cansat-tsniimash/NeonBlade-2023/docs/Зимняя сессия/Cansat NEON BLADE-2023 Презентация.pdf

# Презентация проекта команды NEON BLADE

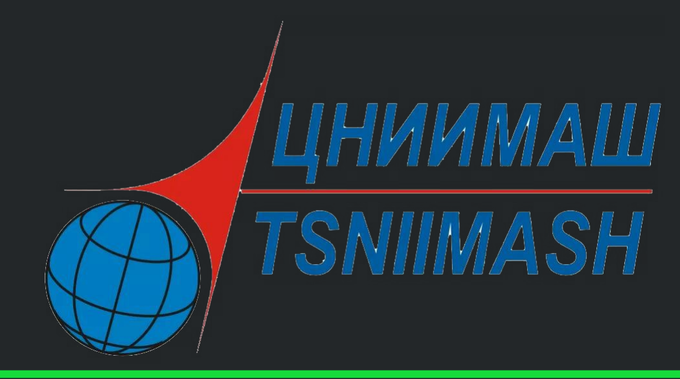
[picture p1: figure]

# Команда

# Воронов Даниил

## 2 года участия в ВИШ

# Черноглазов Даниил

## 1 год участия в ВИШ

# Ожигов Тимофей ✩

## 2 года участия в ВИШ

# Куратор

# Кетов Вячеслав

## 8 год участия в ВИШ

Воздушно-инженерная школа
Зимняя сессия 2023

# Миссии атмосферного зонда

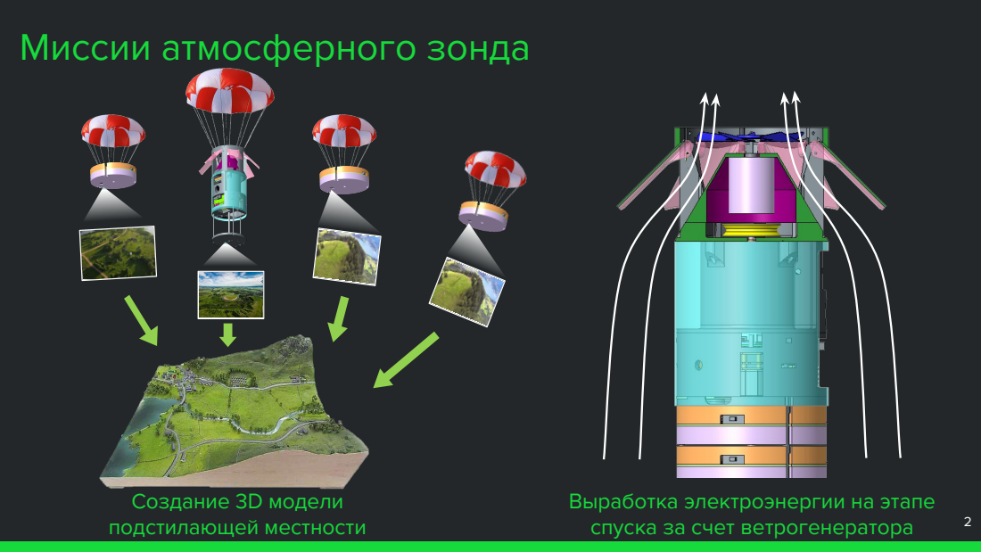
[picture p2: page 2]
Создание 3D модели подстилающей местности; спуска за счет ветрогенератора

Выработка электроэнергии на этапе

# Облик аппарата

## верхний отсек

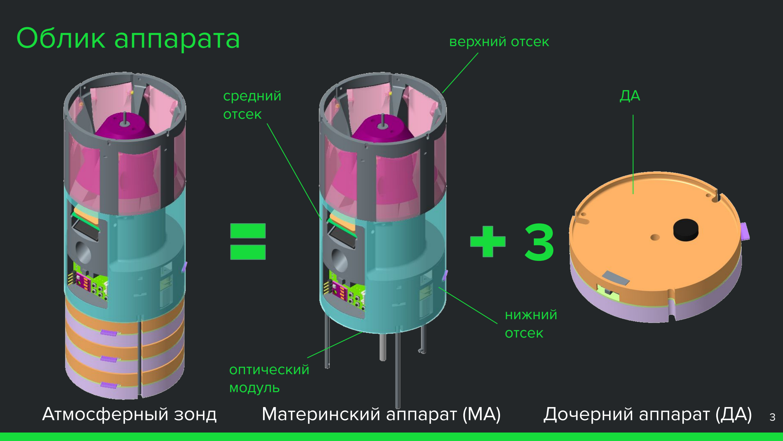
[picture p3: page 3]

3

## средний отсек

## нижний отсек

## оптический модуль

ДА

Атмосферный зонд | Материнский аппарат (МА) | Дочерний аппарат (ДА) 3

# Основные задачи

# - Измерение температуры, давления, трёх компонентов ускорения и трёх компонентов индукции магнитного поля на протяжении всего полёта

# - Создание системы спасения

# - Обеспечение бесконтактной фиксации момента отделения аппарата от носителя

# - Приём телеметрии на собственную наземную станцию

# Дополнительные задачи

- Создание ветрогенератора - Обеспечение вертикальной ориентации до раскрытия парашюта - Отложенное срабатывание системы спасения - Создание системы отделения ДА - Фотосъёмка с бортов МА и ДА во время спуска - Построение 3D-модели местности - Сбор данных с датчиков GPS МА и ДА - Сохранение телеметрии МА и ДА на SD карты - Обеспечение радиосвязи между МА и ДА - Анализ телеметрии зонда на приемном пункте в режиме реального времени во время полета - Разработка системы поиска - Видеорегистрация полёта

# План-полета

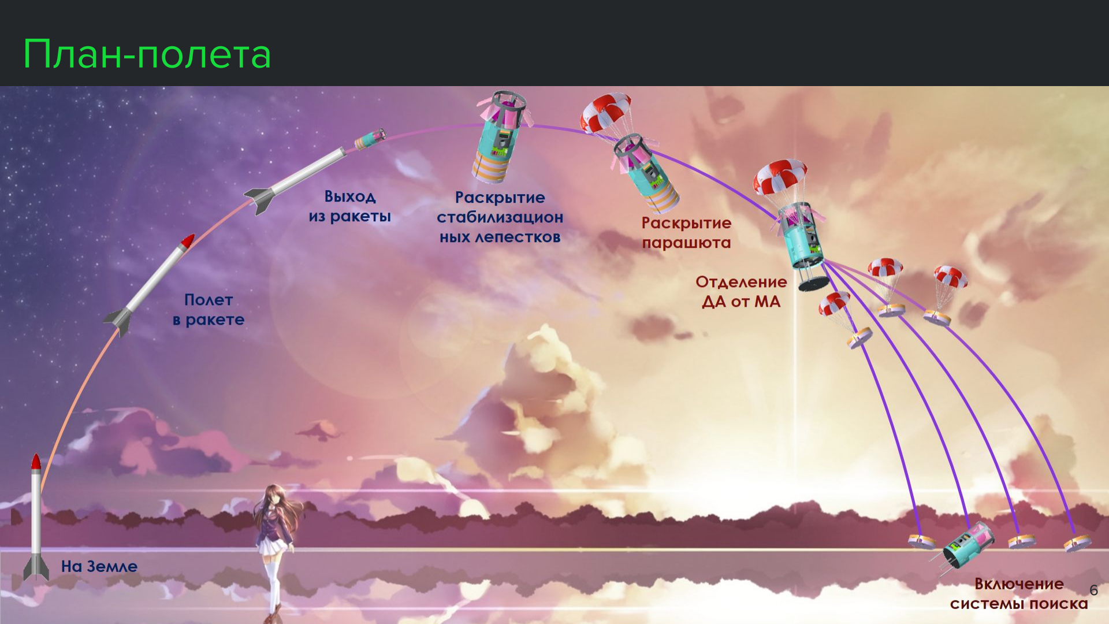
[picture p4: page 6]

# Создание ветрогенератора

V

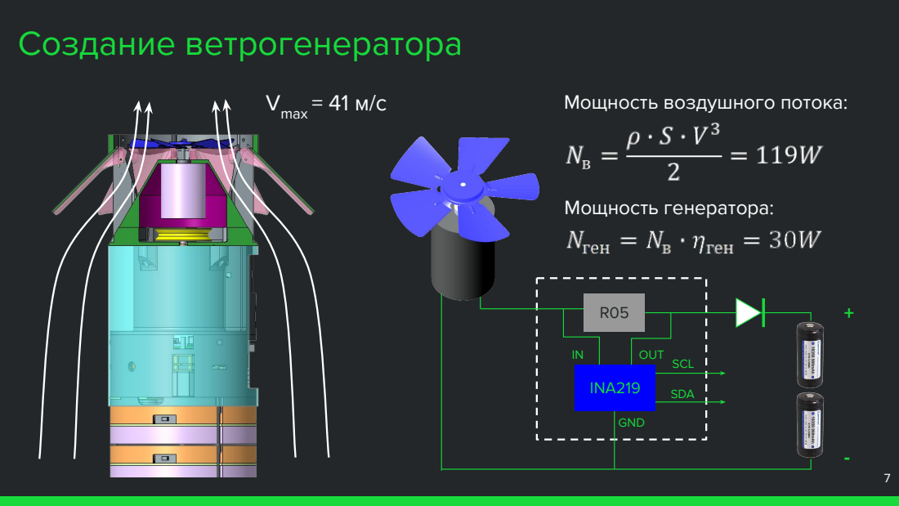
[picture p5: page 7]
OUT; GND; SCL SDA INA219; max; Мощность воздушного потока:; Мощность генератора:

# Обеспечение вертикальной ориентации

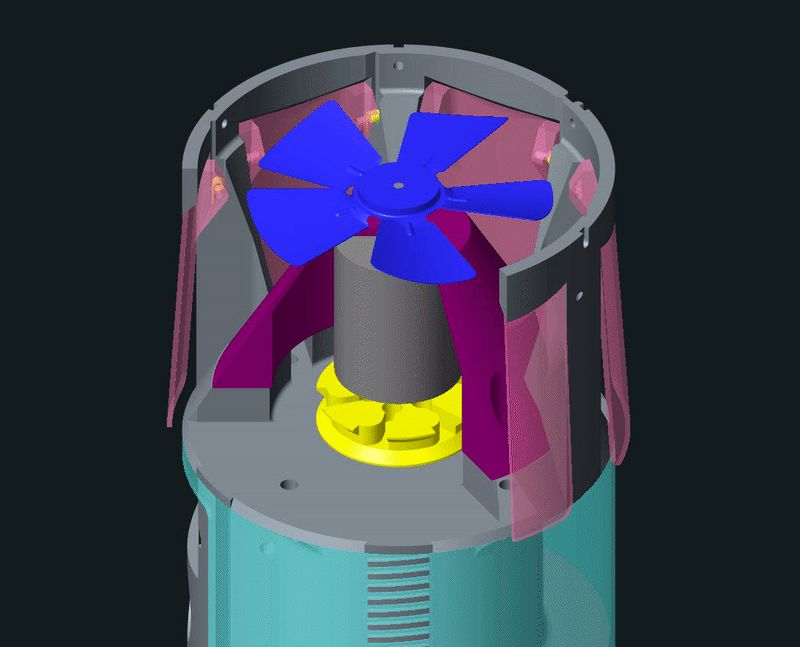
[picture p6: figure]

# Отложенное срабатывание системы спасения

## Крепления

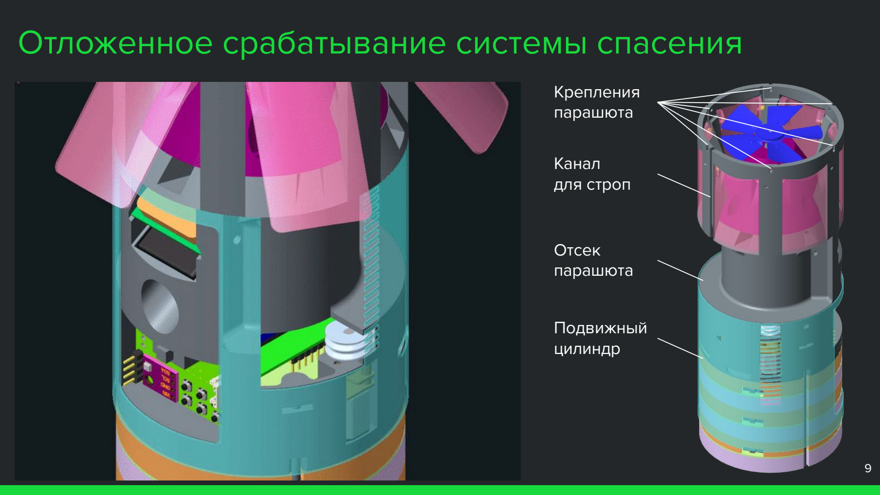
[picture p7: page 9]

## Канал для строп

## Отсек парашюта

## парашюта

## Подвижный цилиндр

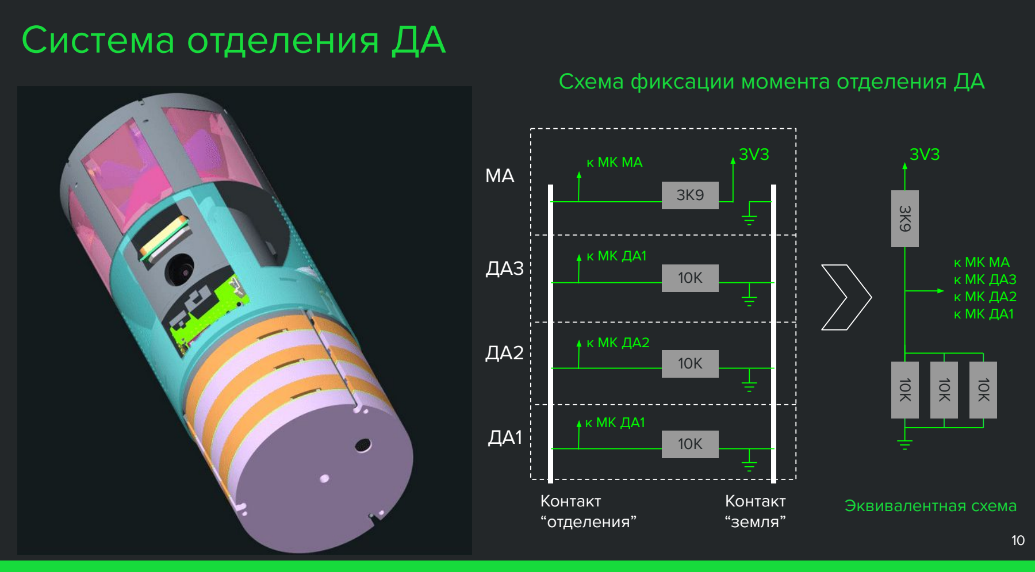
[picture p8: figure]
Система отделения ДА; Контакт “отделения”; Контакт “земля”; Схема фиксации момента отделения ДА; Эквивалентная схема

# Фотосъёмка с бортов МА и ДА

## Модуль ESP32-CAM:

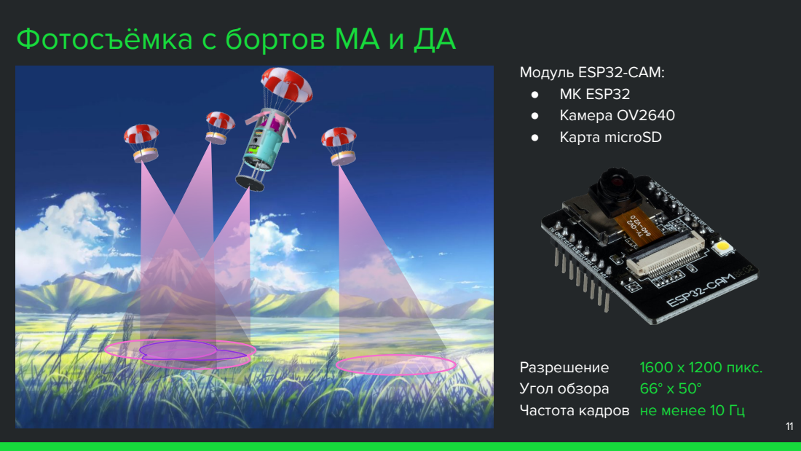
[picture p9: page 11]
Разрешение; 1600 х 1200 пикс.; Угол обзора; ● МК ESP32 ● Камера OV2640 ● Карта microSD

Частота кадров не менее 10 Гц

# Построение 3D модели местности

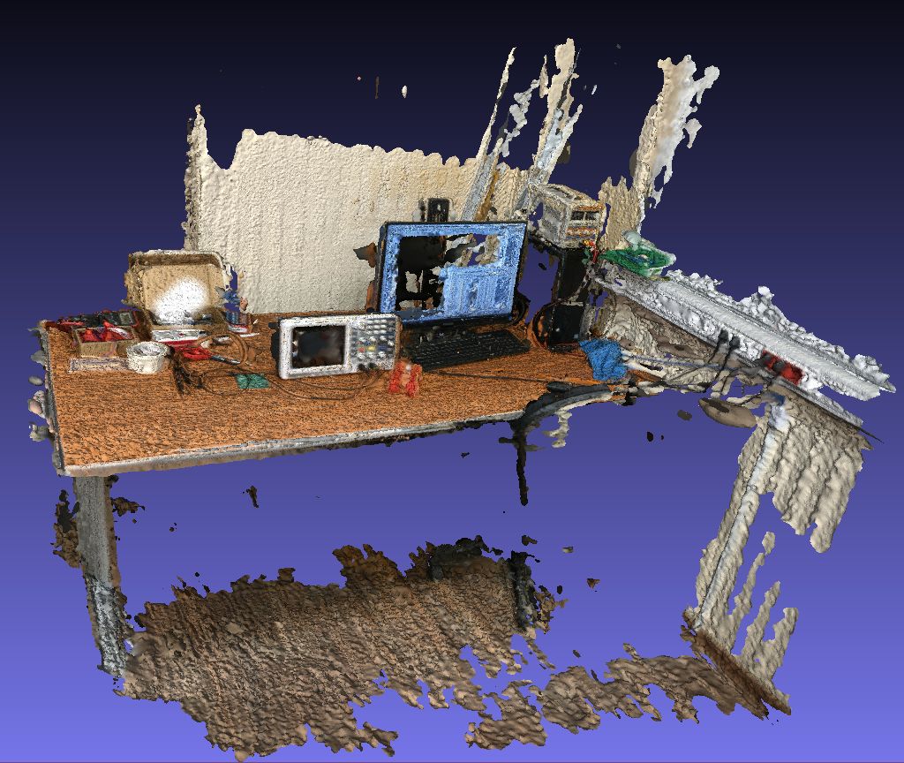
[picture p10: figure]

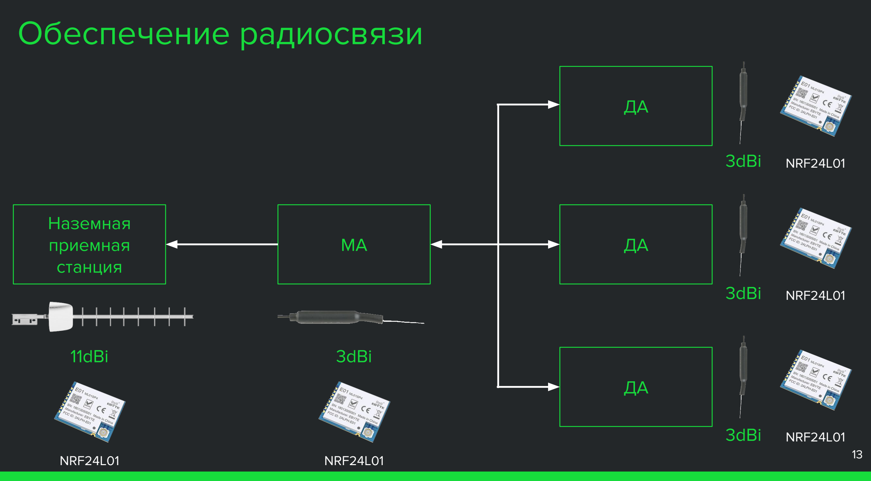
[picture p11: figure]
Обеспечение радиосвязи; Наземная приемная станция; 11dBi; 3dBi; 13 NRF24L01; NRF24L01

# Система поиска

## звуковая сигнализация GPS

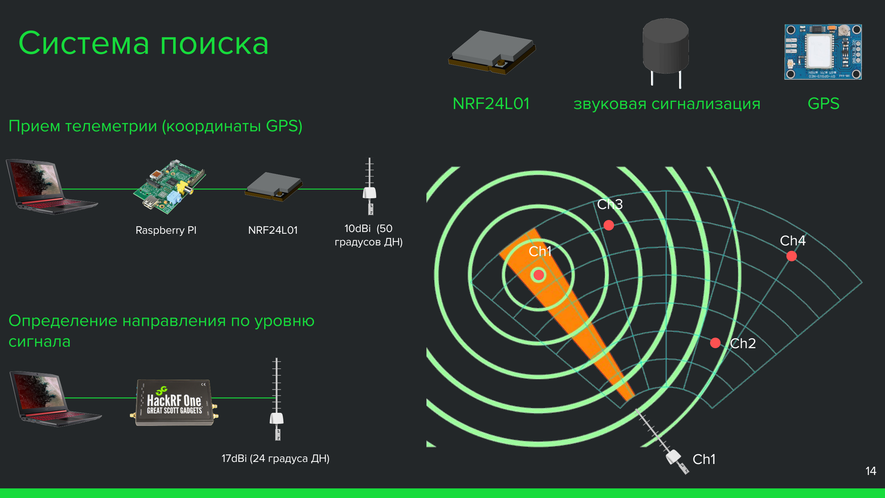
[picture p12: page 14]

Ch3

Ch4

Ch2

Ch1

Ch1

## NRF24L01 Прием телеметрии (координаты GPS)

## Определение направления по уровню сигнала

Raspberry PI | NRF24L01 | 10dBi (50 градусов ДН)

17dBi (24 градуса ДН)

# Видеорегистрация полёта

# Регистрация

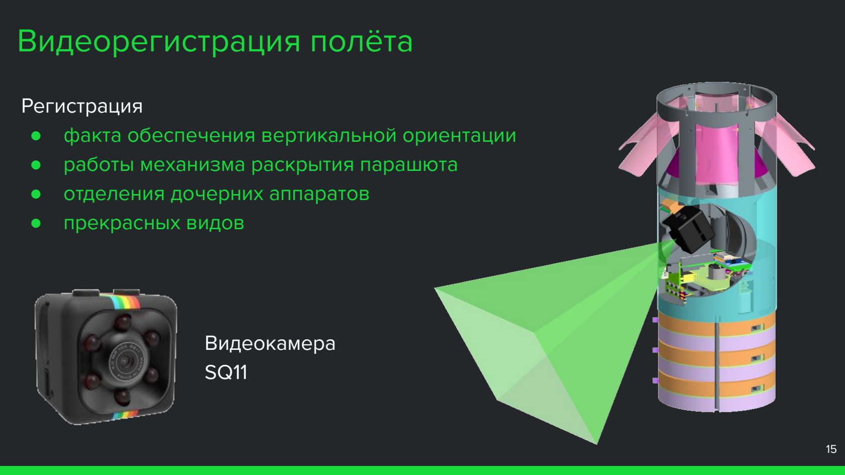
[picture p13: page 15]

# Видеокамера

SQ11

# - факта обеспечения вертикальной ориентации - работы механизма раскрытия парашюта - отделения дочерних аппаратов - прекрасных видов

# Системы материнского аппарата

# Аппарат

## система спасения

купольный
парашют

## система поиска

пищалка

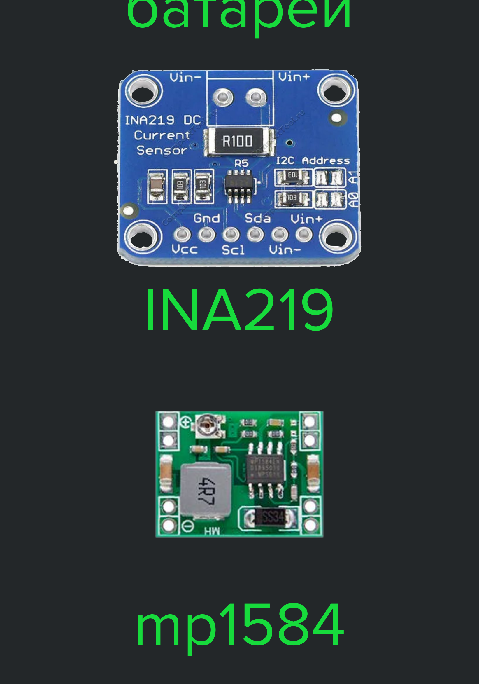
[picture p14: figure]
INA219

NRF24L01

XQ-02A

## система электропитания

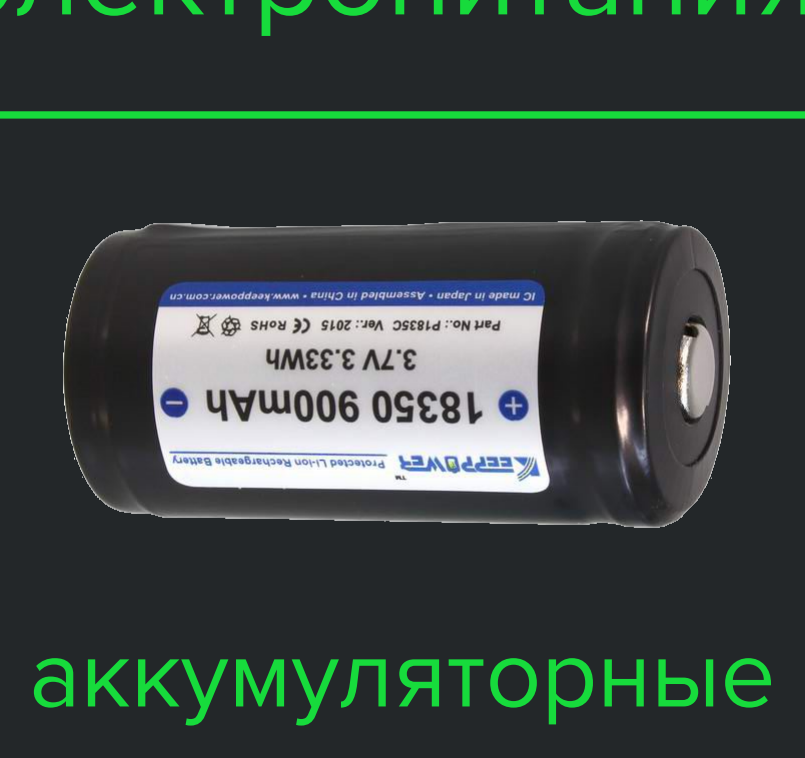
[picture p15: figure]
аккумуляторные

батареи

## система измерений

BME280

NEO-6M

LIS3MDL

LISM6DSL

VT91N1

## система управления

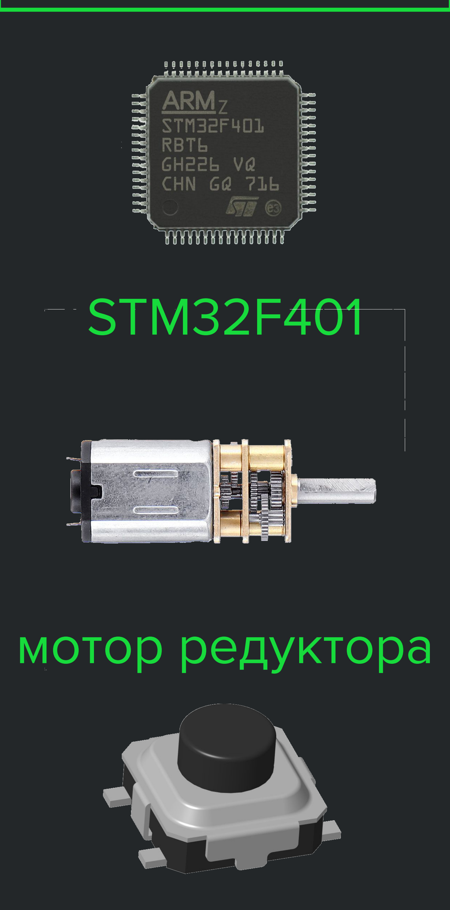
[picture p16: figure]
STM32F401; мотор редуктора

кнопки

## система видеонаблюдения

ESP32CAM

SQ11

## Система хранения и передачи данных

SD-карта

NRF24L01

XQ-02A

Входят функционально

# Системы дочернего аппарата

# Аппарат

## система спасения

купольный
парашют

## система поиска

пищалка

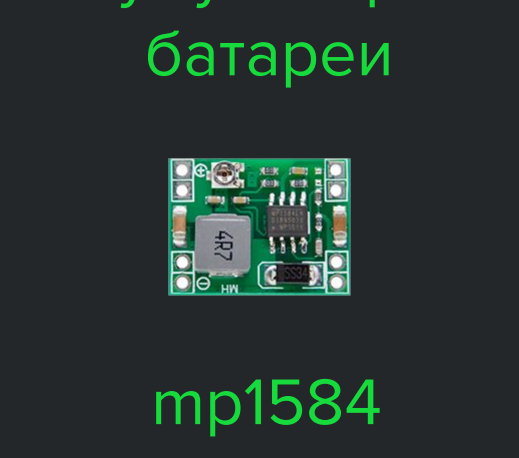
[picture p17: figure]
батареи

NRF24L01

## система электропитания

аккумуляторные

## система измерений

BME280

NEO-7M

LIS3MDL

LISM6DSL

## система управления

STM32F103

## система видеонаблюдения

ESP32CAM

## Система хранения и передачи данных

SD-карта

NRF24L01

Входят функционально

# Компоновка МА [верхний модуль]

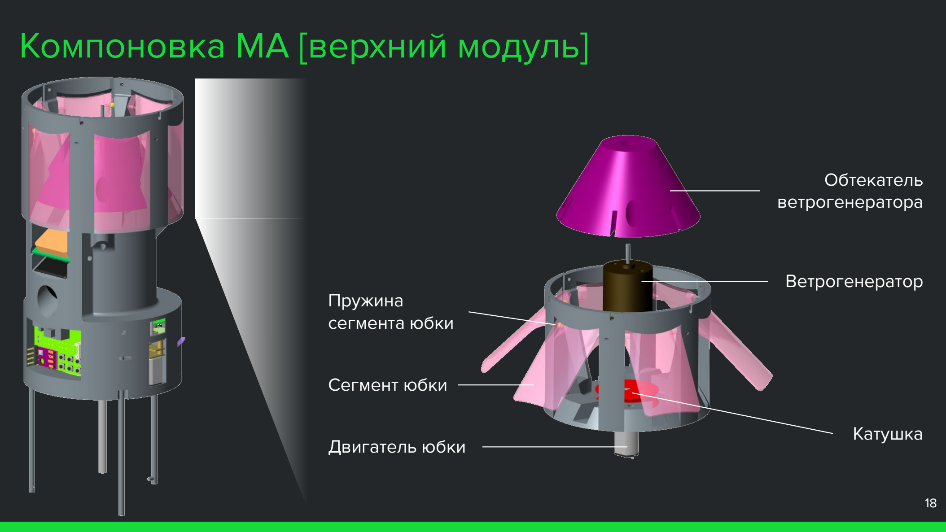
[picture p18: page 18]

## Двигатель юбки

## Катушка

## Пружина сегмента юбки

## Ветрогенератор

## Обтекатель ветрогенератора

## Сегмент юбки

# Компоновка МА [средний модуль]

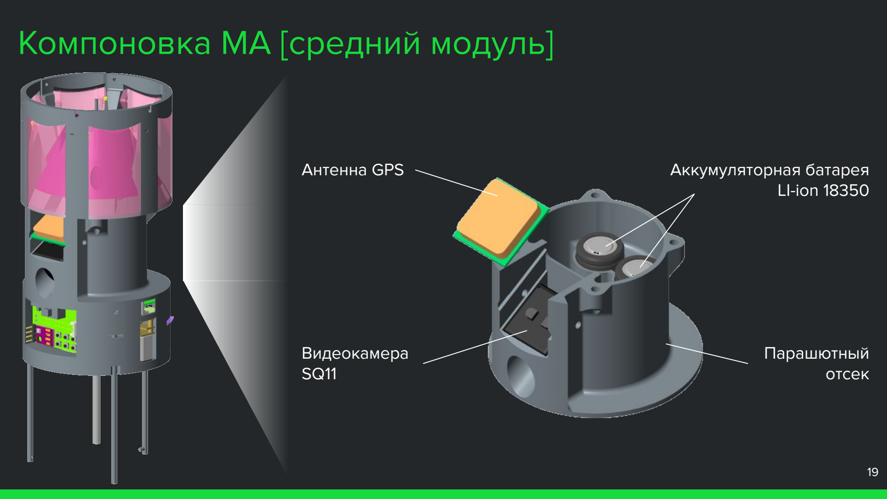
[picture p19: page 19]

## Парашютный отсек

## Аккумуляторная батарея LI-ion 18350

## Видеокамера

SQ11

## Антенна GPS

# Компоновка МА [нижний модуль]

| Усилитель XQ-02A | Датчик тока INA219

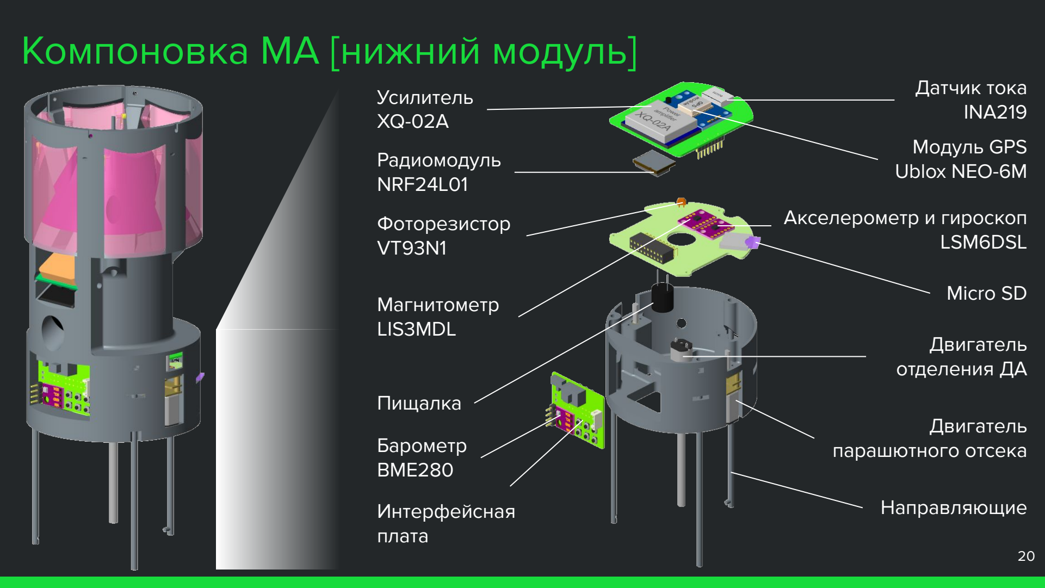
[picture p20: page 20]

## Барометр BME280

## Двигатель парашютного отсека

## Двигатель отделения ДА

## Пищалка

## Micro SD

## Акселерометр и гироскоп LSM6DSL

## Магнитометр LIS3MDL

## Модуль GPS Ublox NEO-6M

## Фоторезистор VT93N1

## Радиомодуль NRF24L01

## Интерфейсная плата

## Направляющие

# Компоновка МА [Оптический модуль]

Разъём FFC | Модуль SP32-CAM

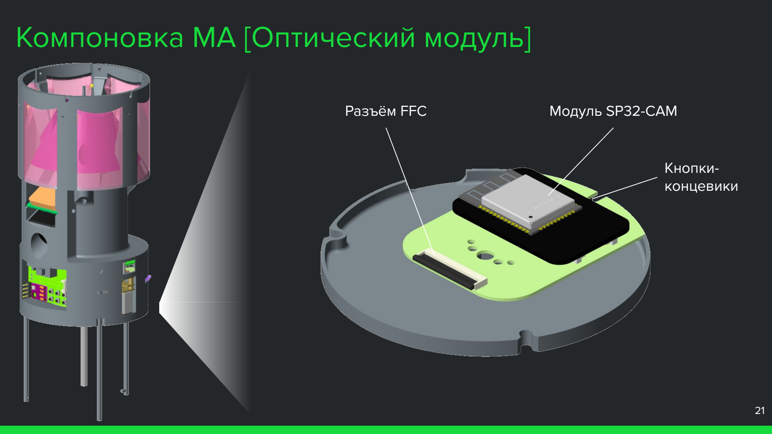
[picture p21: page 21]

## Кнопки-концевики

# Компоновка ДА

## Переключатель

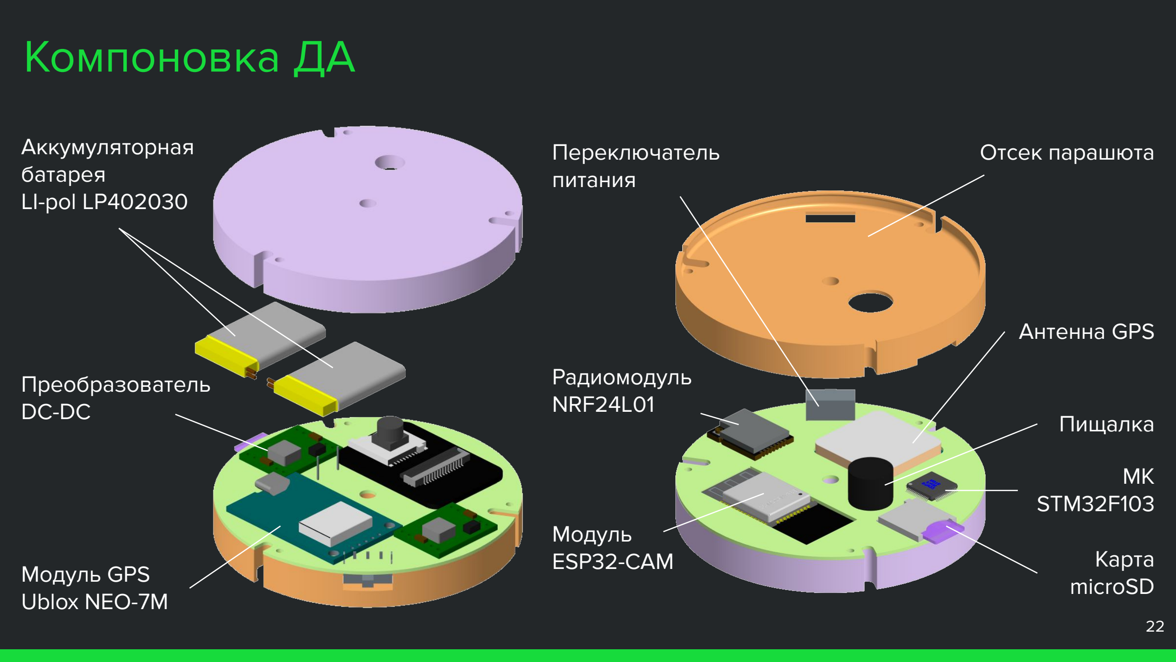
[picture p22: page 22]

## Карта microSD

МК

## STM32F103

## Пищалка

## Антенна GPS

## питания

## Отсек парашюта

## Радиомодуль NRF24L01

## Модуль ESP32-CAM Модуль GPS

## Ublox NEO-7M

## Преобразователь DC-DC

## Аккумуляторная батарея LI-pol LP402030

# Схема подключения МА

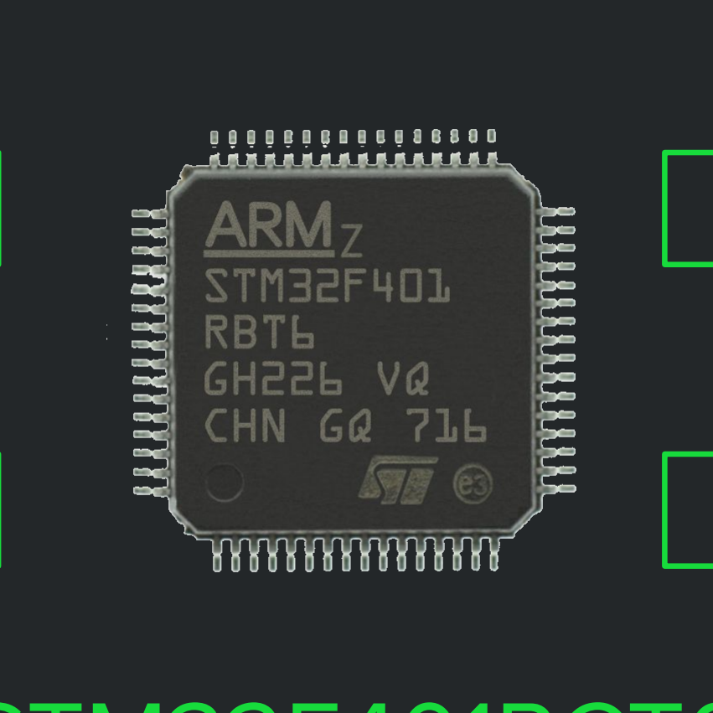
[picture p23: figure]

## STM32F401RCT6

SPI | SPI

### BME280

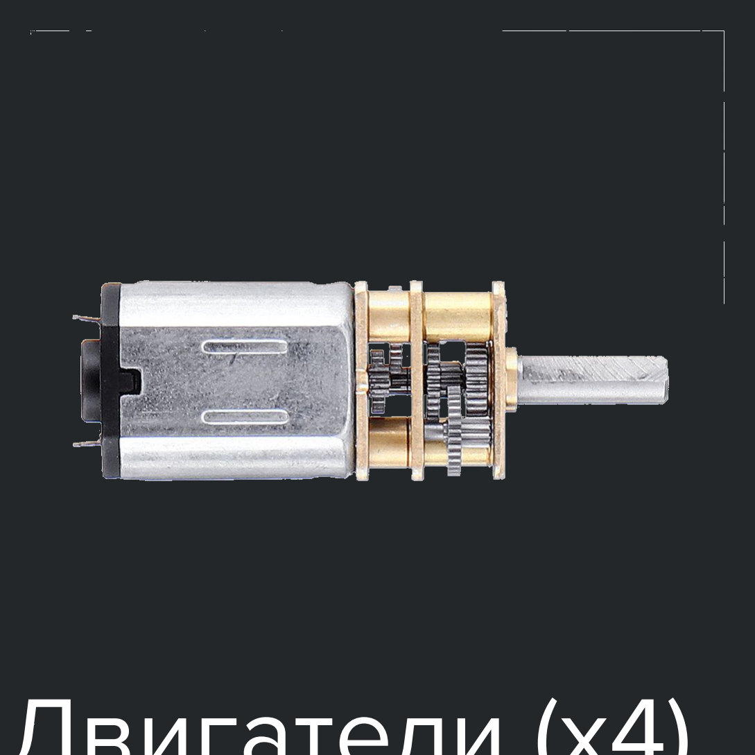
[picture p24: figure]

### LSM6DSL

### LIS3MDL

### NRF24L01

## SPI

## SPI

## SPI

## ADC

UART | I2C

I2C

SDIO | SDIO

## GPIO

## ADC

ФОТОРЕЗИСТОР | INA219 | Кнопки (x10)
GPIO | GPIO
Двигатели (x4) | BUZZER

## GPIO

Усилитель

UART | GPIO

### NEO-6M

microSD

# Схема подключения ДА

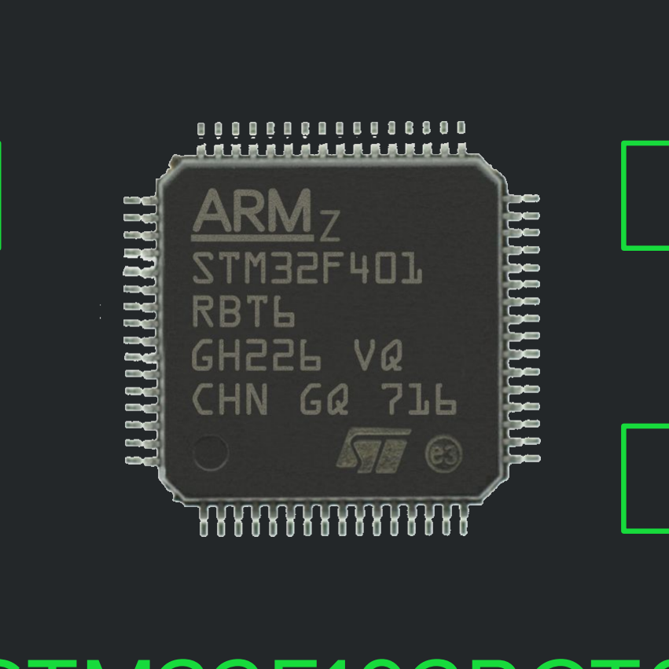
[picture p25: figure]

## STM32F103RCT6

SPI | SPI

### BME280

### LSM6DSL

### LIS3MDL

### NRF24L01

## SPI

## SPI

SPI | UART
SPI | SPI

## GPIO

### BUZZER

UART | GPIO

### NEO-7M

microSD

# Система питания МА

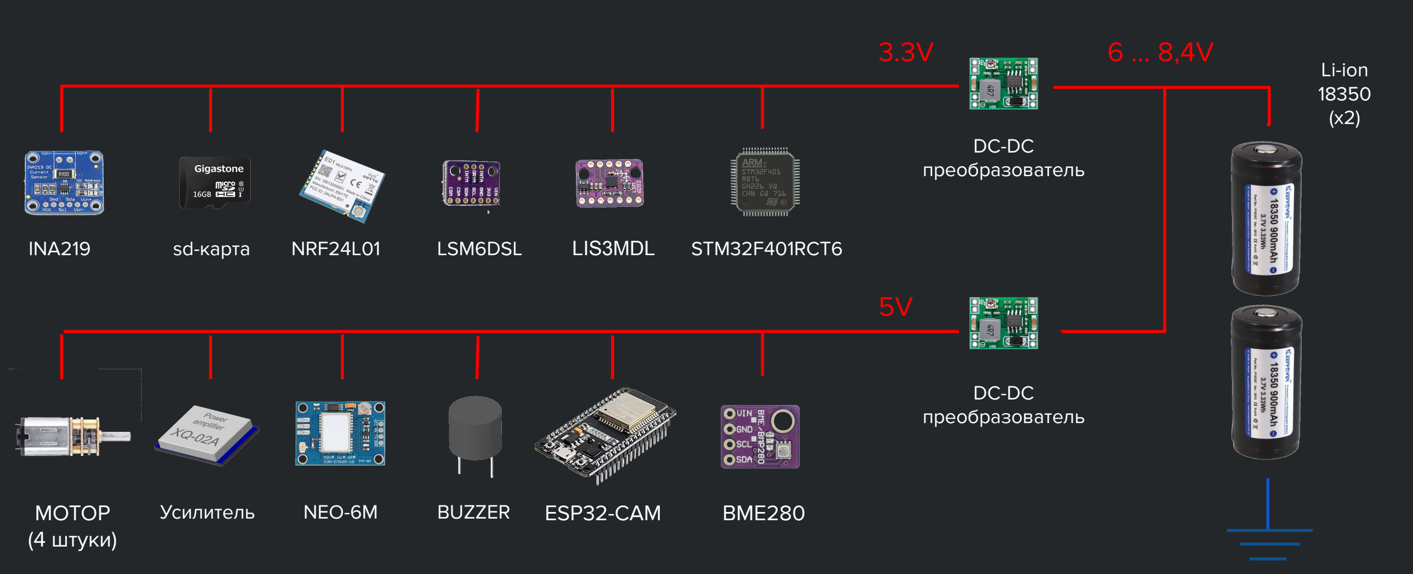
[picture p26: figure]
DC-DC преобразователь; STM32F401RCT6; BME280; INA219; NRF24L01; LSM6DSL; LIS3MDL; ESP32-CAM; sd-карта; BUZZER; Li-ion 18350 (x2); МОТОР; Усилитель; (4 штуки); NEO-6M

# Система питания ДА

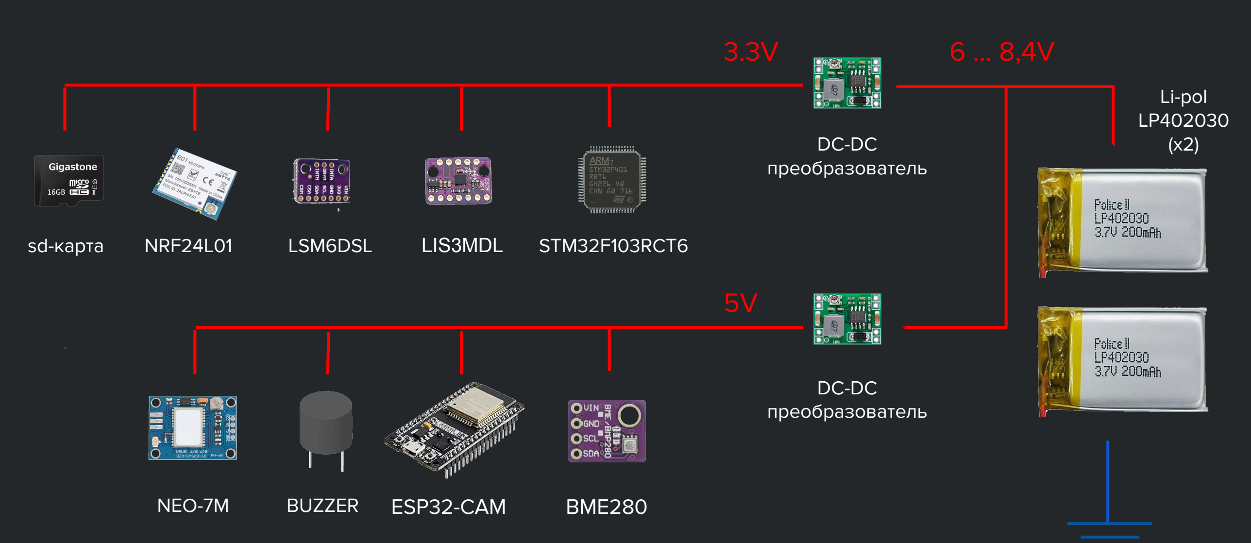
[picture p27: figure]
DC-DC преобразователь; STM32F103RCT6; BME280; NRF24L01; LSM6DSL; LIS3MDL; ESP32-CAM; sd-карта; BUZZER; Li-pol LP402030 (x2); NEO-7M

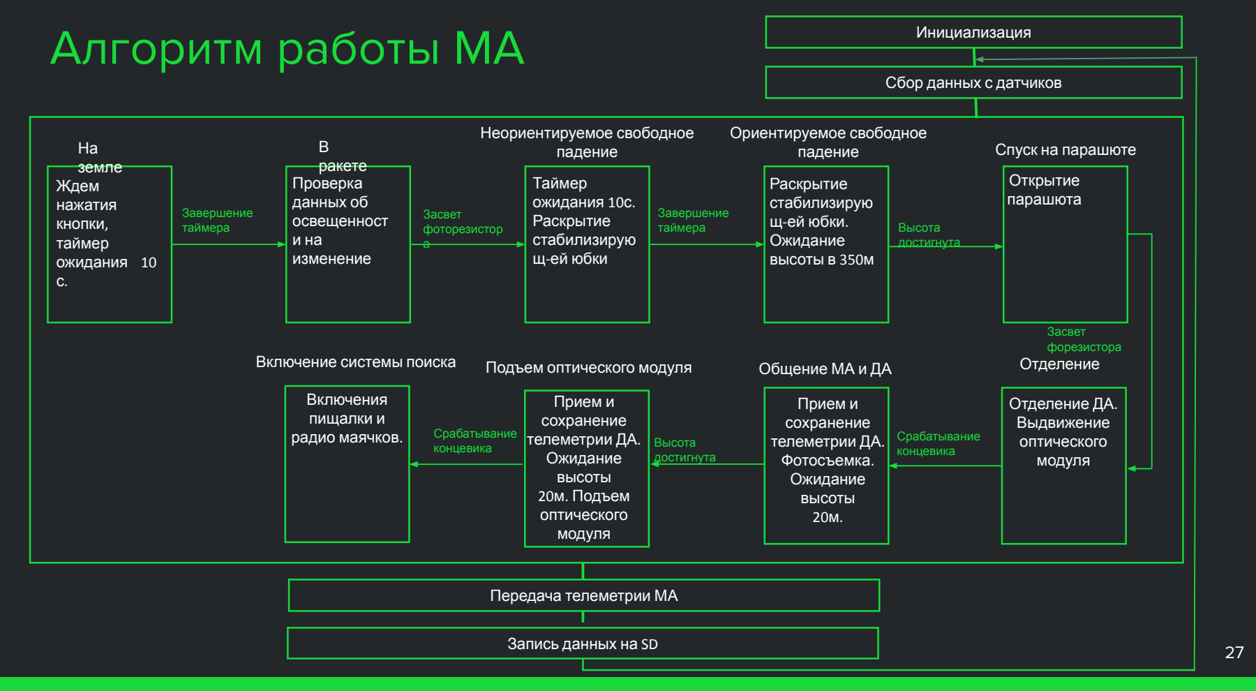
[picture p28: figure]
Инициализация; На земле Ждем нажатия кнопки,; таймер ожидания 10 с.; достигнута; Завершение таймера; В ракете Проверка данных об освещенност и на изменение; Засвет фоторезистор а; Неориентируемое свободное падение; Таймер ожидания 10с. Раскрытие стабилизирую щ-ей юбки; Ориентируемое свободное падение; Раскрытие стабилизирую щ-ей юбки. Ожидание высоты в 350м; Высота; Спуск на парашюте; Открытие парашюта; Засвет форезистора; Срабатывание концевика; Общение МА и ДА; Отделение; Отделение ДА. Выдвижение оптического модуля; Прием и сохранение телеметрии ДА. Фотосъемка. Ожидание высоты 20м.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

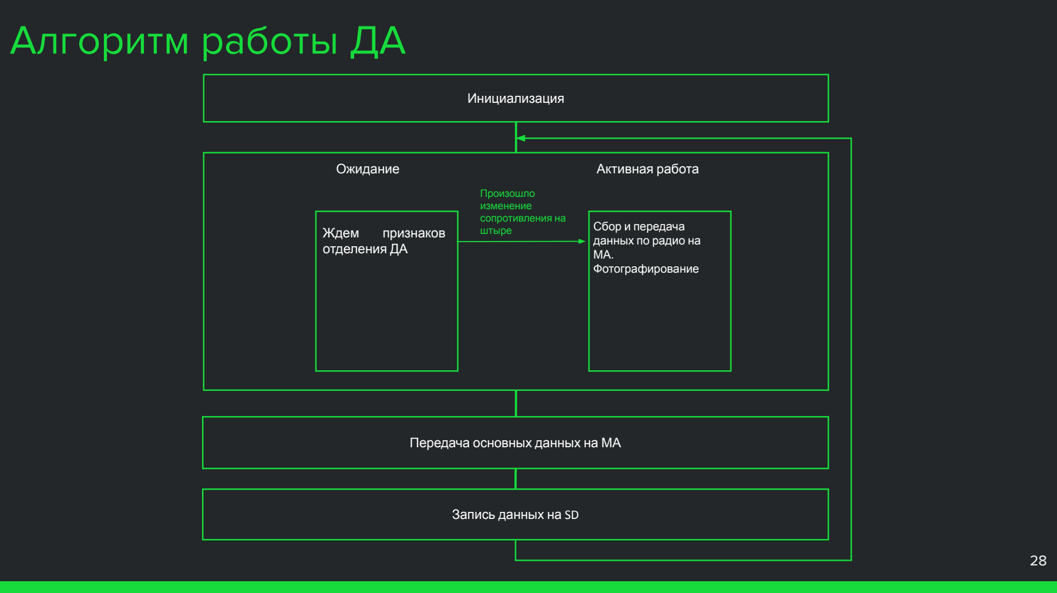
[picture p29: figure]
Алгоритм работы ДАА; Инициализация; Ожидание; Ждем; признаков; отделения ДА; Произошло изменение сопротивления на штыре; Активная работа; Сбор и передача данных по радио на МА. Фотографирование; Запись данных на SD; Передача основных данных на МА

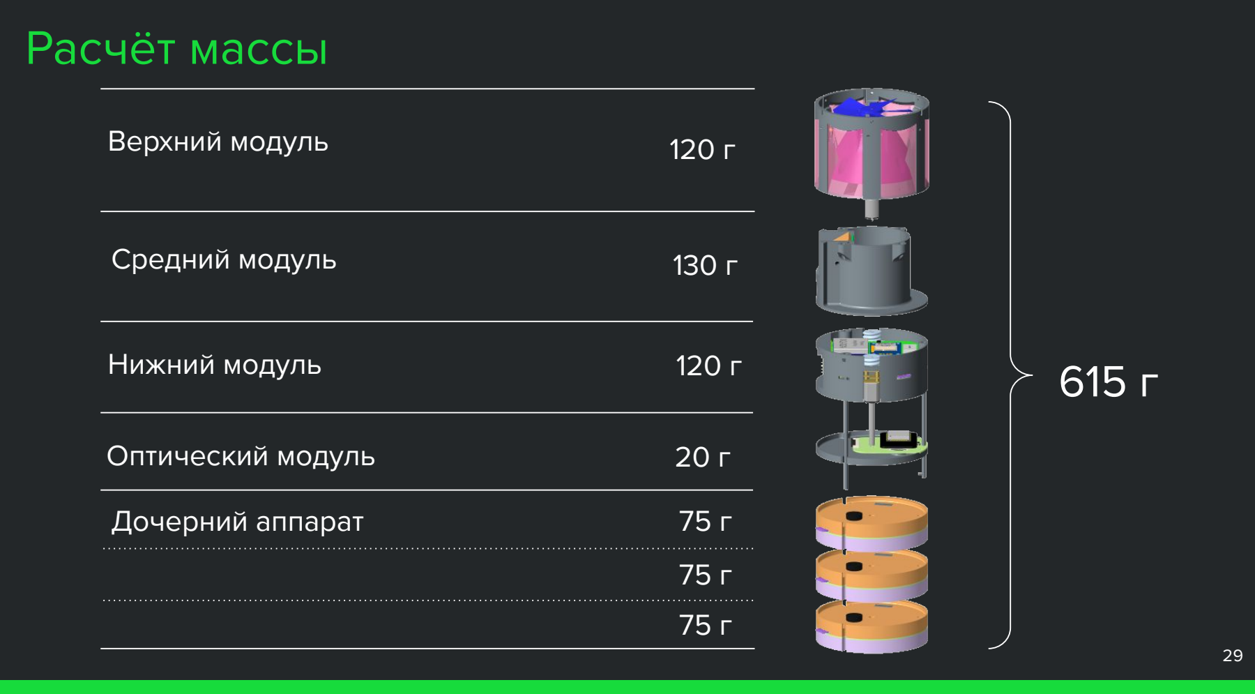
[picture p30: figure]
Расчёт массы; Верхний модуль; Средний модуль; Нижний модуль; Оптический модуль; Дочерний аппарат

# Расчёт парашюта

Характеристики парашюта | МА | ДА
Диаметр купола [D], мм | 308 | 180
Диаметр центрального отверстия, мм | 40 | 20
Площадь парашюта [S], м² | 0,731 | 0,025
Длина строп парашюта, мм | 450 | 200
Количество строп | 6 | 6
Режим спуска | Масса, г | Диаметр [D], мм | Скорость спуска, м/с
МА + ДА | 615 | 308 | 7,5
МА | 390 | 308 | 6
ДА | 75 | 180 | 6

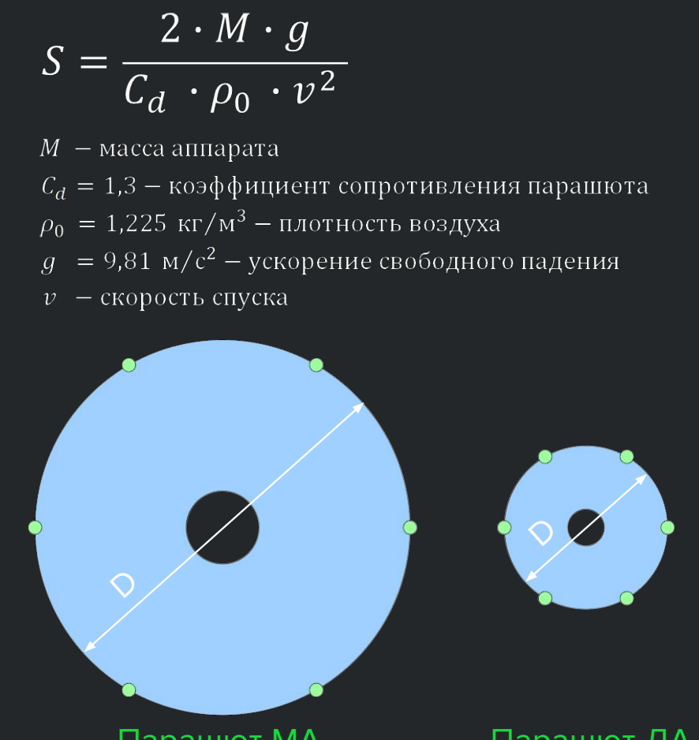
[picture p31: figure]

Парашют МА | Парашют ДА

# Энергобаланс

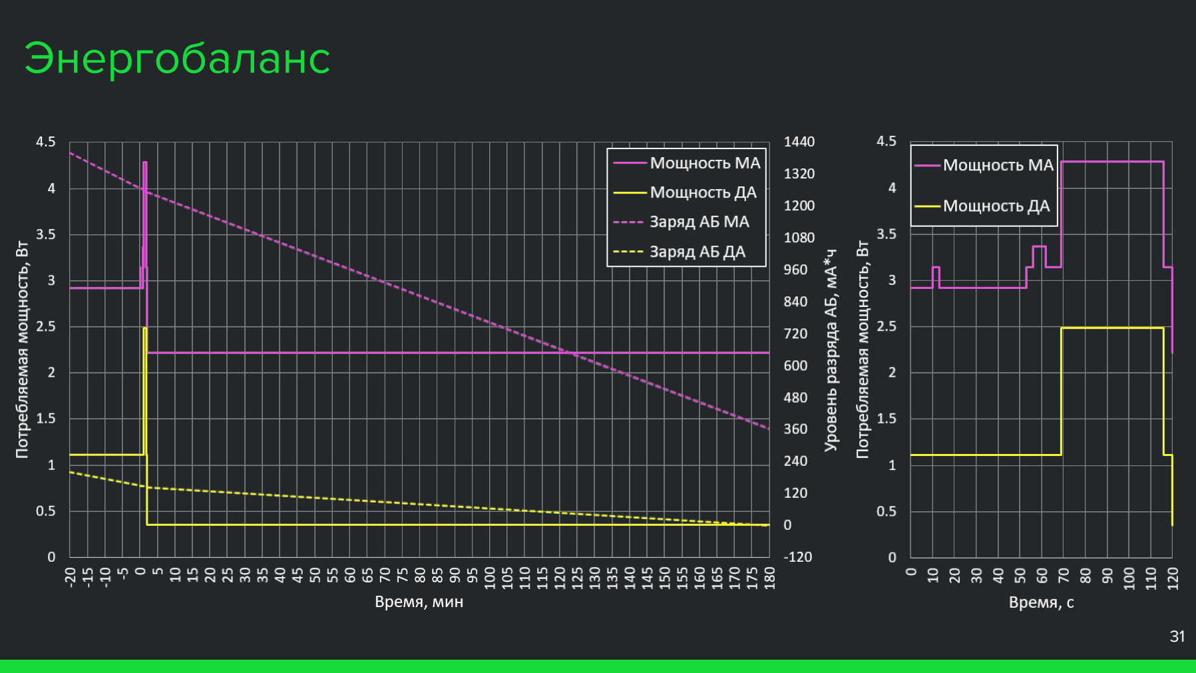
[picture p32: page 31]

# Расчёт стоимости

Наименование | Обозначение | Количество | Цена за 1 шт., руб. | Цена общая., руб.
Аккумулятор | ICR18350-1400 | 2 | 329 | 658
Аккумулятор | LP402030 | 6 | 230 | 1380
Акселерометр и гироскоп | LSM6DSL | 4 | 306 | 1224
Антенна для радио | 2,4 GHz Wi-Fi 3dbi 15см | 4 | 74 | 296
Антенна GPS | | 1 | 433 | 433
Ветрогенератор | | 1 | 269 | 269
Датчик температуры, давления и влажности | BME280 | 4 | 620 | 2480
Датчик тока | INA219 SOT23-8 | 1 | 335 | 335,2
Камера | FANGTUOSI SQ11 | 1 | 1053 | 1053
Магнитометр | LIS3MDL | 4 | 660 | 2640
Микроконтроллер на плате | ESP32-CAM | 4 | 632 | 2528
Микроконтроллер | STM32F401RCT6 | 1 | 233 | 233,2
Мотор-редуктор | вал-3мм | 2 | 102 | 204
Мотор-редуктор | вал-М4 | 1 | 147 | 147
Мотор-редуктор | вал-3мм | 1 | 102 | 102
Пищалка активная | 5 В | 4 | 8,1 | 32,4
Пружина кручения | 0.4x2.3x95 | 6 | 19,7 | 118,2
Радиомодуль | NRF24L01 | 4 | 226 | 904
Усилитель | XQ-02A | 1 | 1400 | 1400
Фоторезистор | VT93N1 | 1 | 25 | 25
Micro SD карта | SanDisk 16Gb | 8 | 460 | 3680
DC-DC преобразователь понижающий на плате | MP1584EN | 8 | 86 | 688
Изготовление печатных плат | | 1 | 12 000 | 12 000
ИТОГО: | 32 830

# План-график

Наименование работы | Февраль | Март | Апрель | Май | Июнь

П
У
С
К
1 | 2 | 3 | 4 | 5 | 6 | 7 | 8 | 9 | 10 | 11 | 12 | 13 | 14 | 15 | 16 | 17 | 18 | 19 | 20

Разработка печатных плат МА Разработка интерфейсной печатной платы Разработка печатной платы ДА Монтаж и отладка печатных плат МА Монтаж и отладка интерфейсной печатной платы Монтаж и отладка печатной платы ДА Печать и доработка конструкции МА Печать и доработка конструкции ДА Создание ПО МА Создание ПО ДА Создание ПО для ESP32-CAM Создание ПО для наземной станции Создание ПО для маяка Сборка конструкции аппарата Испытания аппарата Подготовка аппарата к пуску

# Спасибо за внимание!

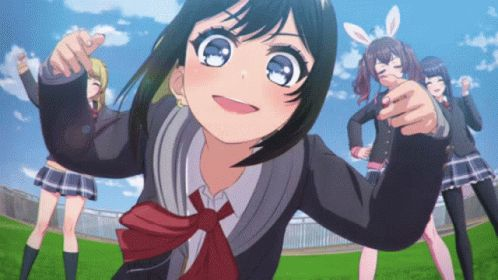
[picture p33: figure]
