cansat-tsniimash/NeonBlade-2023/docs/Видеозачет/3D модель/NB.4000-0 Оптический модуль.pdf

Копировал | Формат А4

Детали

1 | NB.4000-1 | Плата оптического модуля | 1
2 | NB.4000-2 | Крышка оптического модуля | 1
3 | Кнопка | 2
4 | Конектор FFC | 1
| FFC Connector 6 pins
5 | Модуль ESP32-CAM | 1
| ESP32-CAM

Инв. N подл. Подп. и дата Взам. инв. N Инв. N дубл. Подп. и дата Справ. N Перв. примен.

NB.4000-0
Изм. | Лист | N докум. | Подп. | Дата
| | Разраб. | Черноглазов | | Оптический модуль | Лит. NEON BLADE Н. контр. | Лист | Листов
Пров. | Воронов | | | | | | | 1
Команда
Утв. | Кетов Формат | Зона | Поз.
Обозначение | Наименование

Кол.

Примечание
