cansat-tsniimash/NeonBlade-2023/docs/Видеозачет/3D модель/NB.5000-0 Дочерний аппарат.pdf

Копировал | Формат А4
1 | NB.5000-1 | Плата ДА | 1
2 | NB.5000-2 | Верхняя крышка ДА | 1
3 | NB.5000-3 | Нижняя крышка ДА | 1

Прочие изделия

4 | DC-DC преоброзователь | 2
| MP1584EN
5 | Аккумулятор Li-Pol | 2
| LP443442
6 | Микроконтроллер | 1
| STM32F411RСT6
7 | Модуль ESP32-CAM | 1
| ESP32-CAM
8 | Модуль GPS | 1
| UBLOX NEO7-M
9 | Переключатель | 1
| SK12F14
10 | Пищалка | 1
| BUZZER-5V
11 | Радиомодуль на базе NRF24L01 | 1
| E01-ML01SP4
12 | Слот сд карты | 1
| MicroSD connector

Инв. N подл. Подп. и дата Взам. инв. N Инв. N дубл. Подп. и дата Справ. N Перв. примен.

NB.5000-0
Изм. | Лист | N докум. | Подп. | Дата
| | Разраб. | Черноглазов | | Дочерний аппарат | Лит. NEON BLADE Н. контр. | Лист | Листов
Пров. | Воронв | | | | | | | 1
Команда
Утв. | Кетов Формат | Зона | Поз.
Обозначение | Наименование | Приме-чание
| Детали

Кол.
