cansat-tsniimash/NeonBlade-2023/docs/Видеозачет/3D модель/NB.0000-0 Атмосферный зонд.pdf

Копировал | Формат А4
NB.0000-0ГЧ | Габаритный чертеж
| Сборочные единицы
1 | NB.1000-0 | Нижний модуль МА | 1
2 | NB.2000-0 | Средний модуль МА | 1
3 | NB.3000-0 | Верхний модуль МА | 1
4 | NB.4000-0 | Оптический модуль | 1
5 | NB.5000-0 | Дочерний аппарат | 3

Детали

6 | NB.0000-1 | Крышка парашютного отсека | 1

Инв. N подл. Подп. и дата Взам. инв. N Инв. N дубл. Подп. и дата Справ. N Перв. примен.

NB.0000-0
Изм. | Лист | N докум. | Подп. | Дата
| | Разраб. | Черноглазов | | Атмосферный зонд | Лит. NEON BLADE Н. контр. | Лист | Листов
Пров. | Воронов | | | | | | | 1
Команда
Утв. | Кетов Формат | Зона | Поз.
Обозначение | Наименование | Приме-чание
| Документация

Кол.
