cansat-tsniimash/NeonBlade-2023/docs/Видеозачет/3D модель/NB.1000-0 Нижний модуль МА.pdf

Копировал | Формат А4

Сборочные единицы

1 | NB.1100-0 | Нижняя плата | 1
2 | NB.1200-0 | Верхняя плата | 1
3 | NB.1300-0 | Интерефейсная плата | 1

Детали

4 | NB.1000-1 | Корпус среднего модуля | 1
5 | NB.1000-2 | Направляющий стержень | 3
6 | NB.1000-3 | Червяк | 2
7 | NB.1300-1 | Упор | 1

Прочие изделия

8 | Мотор-редуктор | 2
| GA12-N20 D3
9 | Мотор-редуктор | 1
| GA12-N20 M4

Инв. N подл. Подп. и дата Взам. инв. N Инв. N дубл. Подп. и дата Справ. N Перв. примен.

NB.1000-0
Изм. | Лист | N докум. | Подп. | Дата
| | Разраб. | Черноглазов | | Нижний модуль МА | Лит. NEON BLADE Н. контр. | Лист | Листов
Пров. | Воронов | | | | | | | 1
Команда
Утв. | Кетов Формат | Зона | Поз.
Обозначение | Наименование

Кол.

Примечание
