cansat-tsniimash/NeonBlade-2023/docs/Видеозачет/3D модель/NB.1000-0 Средний модуль МА.pdf

Копировал | Формат А4

Детали

1 | NB.2000-1 | Корпус среднего модуля | 1

Прочие изделия

2 | Аккумулятор Li-ion | 2
| IRC18350
3 | Антенна GPS | 1
| 28 dBi, 28*28*7 мм, IPX

Инв. N подл. Подп. и дата Взам. инв. N Инв. N дубл. Подп. и дата Справ. N Перв. примен.

NB.2000-0
Изм. | Лист | N докум. | Подп. | Дата
| | Разраб. | Черноглазов | | Средний модуль МА | Лит. NEON BLADE Н. контр. | Лист | Листов
Пров. | Воронов | | | | | | | 1
Команда
Утв. | Кетов Формат | Зона | Поз.
Обозначение | Наименование

Кол.

Примечание
