cansat-tsniimash/NeonBlade-2023/docs/Видеозачет/3D модель/NB.3000-0 Верхний модуль МА.pdf

Копировал | Формат А4

Сборочные единицы

1 | NB.3100-0 | Кнопка-концевик | 2

Детали

2 | NB.3000-1 | Корпус верхнего модуля | 1
3 | NB.3000-2 | Стабилизационная юбка | 6
4 | NB.3000-4 | Катушка | 1
5 | NB.3000-5 | Обтекатель | 1

Прочие изделия

6 | Винт ветрогенератора | 1
7 | Генератор ветрогенератора | 1
8 | Мотор-редуктор | 1
| GA12-N20 D3
9 | Пружина кручения | 6
| 0.4x2.1x180

Инв. N подл. Подп. и дата Взам. инв. N Инв. N дубл. Подп. и дата Справ. N Перв. примен.

NB.3000-0
Изм. | Лист | N докум. | Подп. | Дата
| | Разраб. | Черноглазов | | Верхний модуль МА | Лит. NEON BLADE Н. контр. | Лист | Листов
Пров. | Воронов | | | | | | | 1
Команда
Утв. | Кетов Формат | Зона | Поз.
Обозначение | Наименование

Кол.

Примечание
