cansat-tsniimash/NeonBlade-2023/construction/3Dmodel_mothership/cup_bottom_doch_new.stl

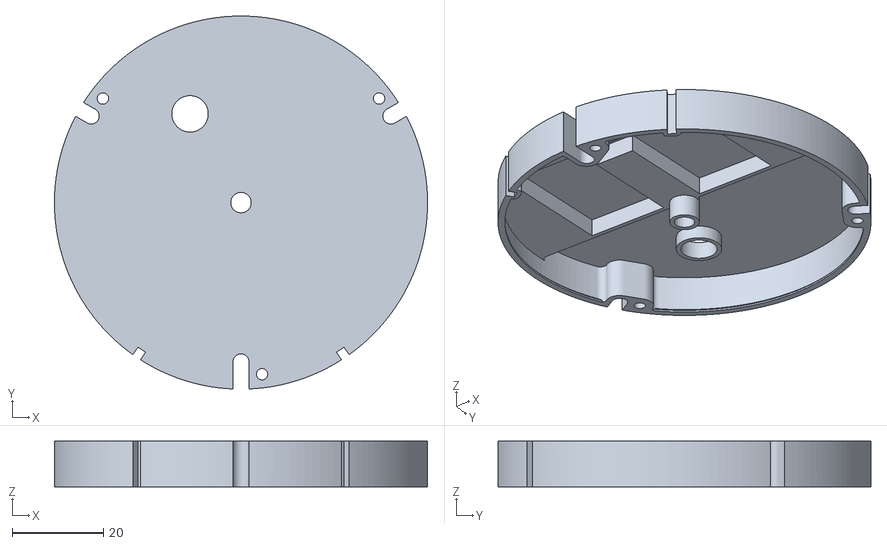
[picture p64: CAD file, 2023-04-14]
construction/3Dmodel_mothership/cup_bottom_doch_new.stl
82.0 x 82.0 x 10.0
