cansat-tsniimash/NeonBlade-2023/construction/STLs/platada_om.stl

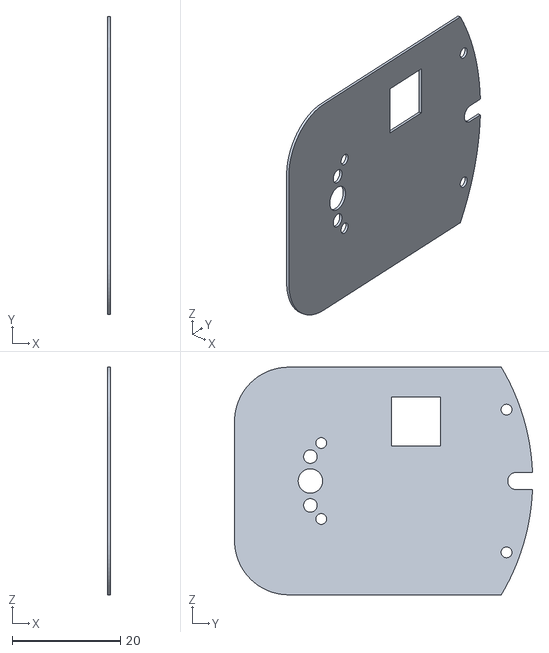
[picture p65: CAD file, 2023-05-01]
construction/STLs/platada_om.stl
0.5 x 55.0 x 42.0
