cansat-tsniimash/NeonBlade-2023/schematics/DXFs/halo_doch.dxf

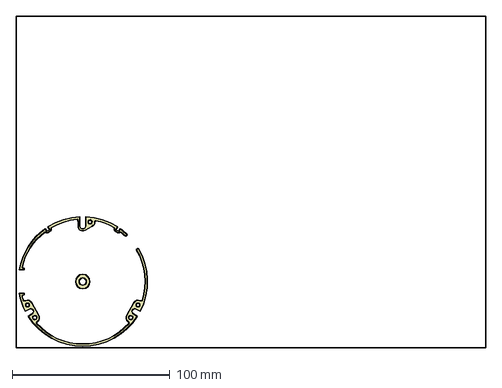
[picture p66: CAD file, 2023-03-25]
schematics/DXFs/halo_doch.dxf
297.0 x 210.0 mm
