cansat-tsniimash/NeonBlade-2023/construction/STLs/cup_babina.stl

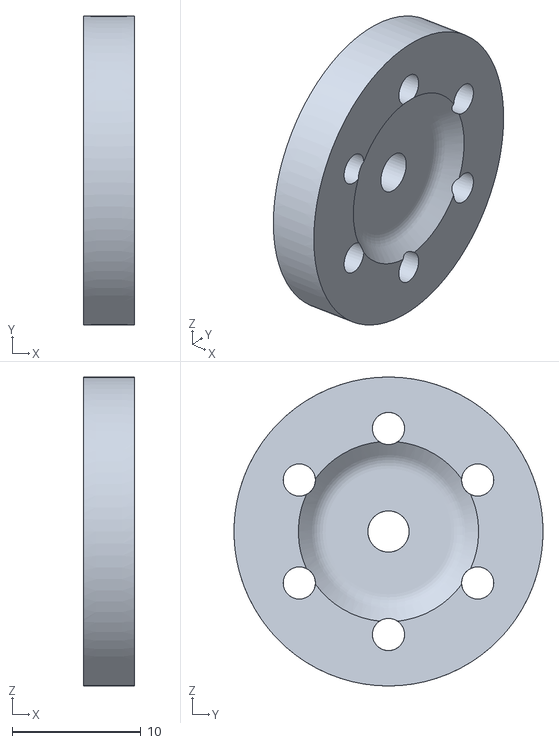
[picture p67: CAD file, 2023-05-01]
construction/STLs/cup_babina.stl
4.00 x 24.0 x 24.0
