cansat-tsniimash/NeonBlade-2023/schematics/DXFs/plata_da_new.dxf

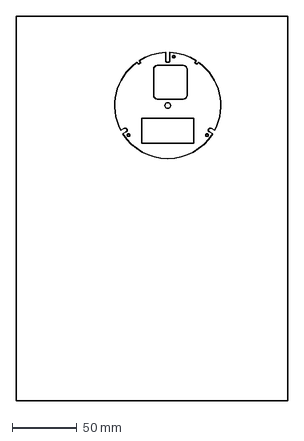
[picture p68: CAD file, 2023-03-25]
schematics/DXFs/plata_da_new.dxf
210.0 x 297.0 mm
