cansat-tsniimash/NeonBlade-2023/construction/STLs/skirt.stl

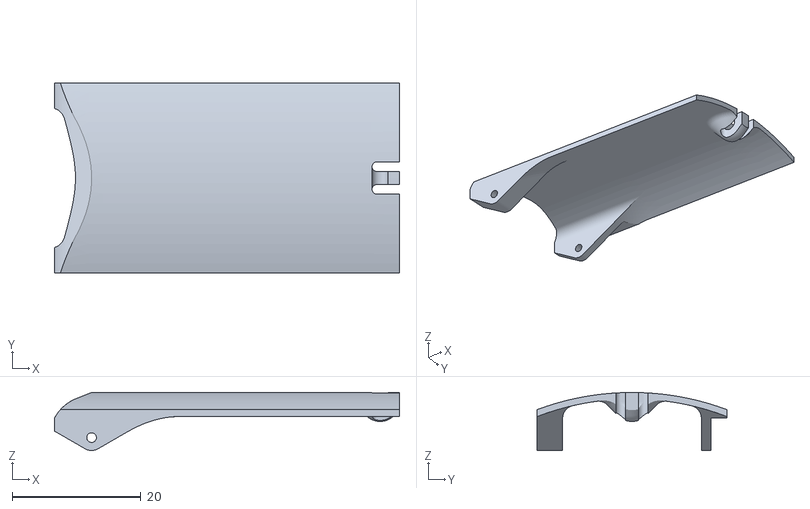
[picture p69: CAD file, 2023-05-01]
construction/STLs/skirt.stl
53.5 x 29.5 x 9.00
