cansat-tsniimash/NeonBlade-2023/schematics/DXFs/plata_da_zone-top.dxf

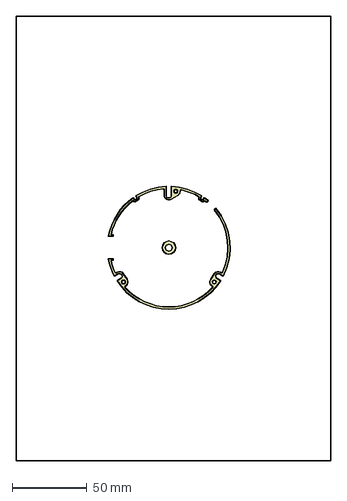
[picture p70: CAD file, 2023-03-25]
schematics/DXFs/plata_da_zone-top.dxf
210.0 x 297.0 mm
