cansat-tsniimash/NeonBlade-2023/construction/STLs/platada.stl

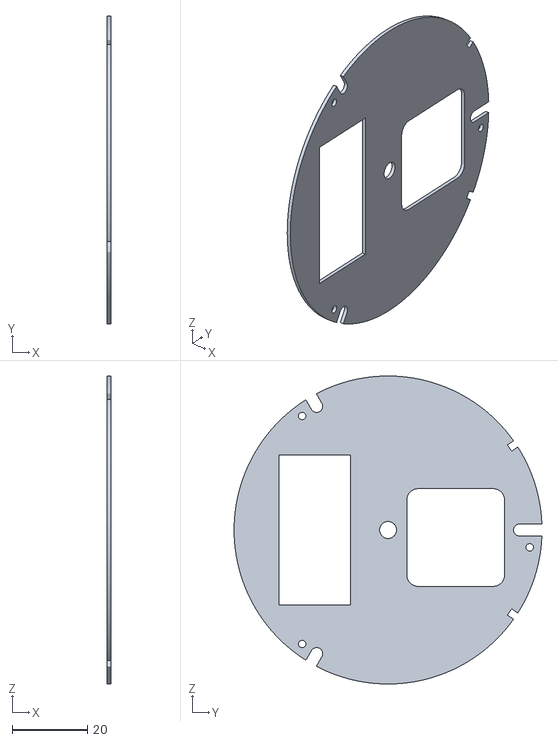
[picture p71: CAD file, 2023-05-01]
construction/STLs/platada.stl
1.00 x 82.0 x 82.0
