cansat-tsniimash/NeonBlade-2023/schematics/DXFs/lm_bottom_board-dxf.dxf

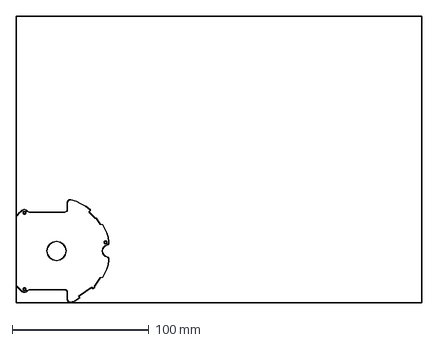
[picture p72: CAD file, 2023-03-25]
schematics/DXFs/lm_bottom_board-dxf.dxf
297.0 x 210.0 mm
