cansat-tsniimash/NeonBlade-2023/construction/STLs/babara_babina.stl

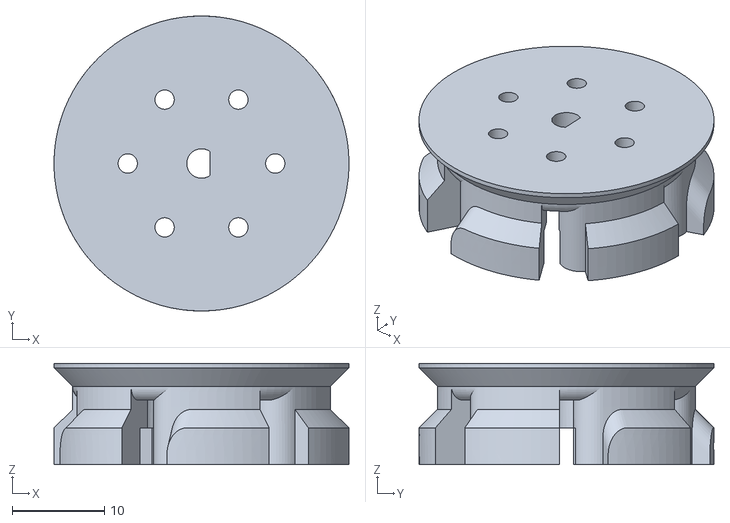
[picture p73: CAD file, 2023-05-01]
construction/STLs/babara_babina.stl
32.0 x 32.0 x 11.0
