cansat-tsniimash/NeonBlade-2023/schematics/DXFs/ma_board-2_zone.dxf

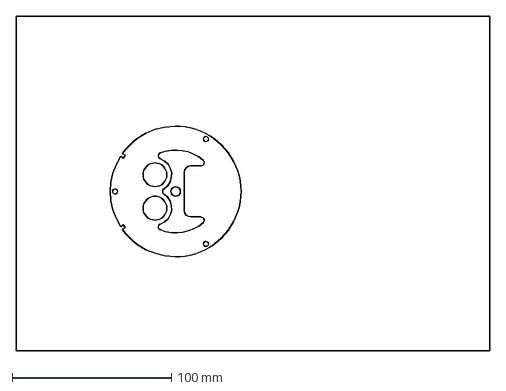
[picture p74: CAD file, 2023-03-25]
schematics/DXFs/ma_board-2_zone.dxf
297.0 x 210.0 mm
