cansat-tsniimash/NeonBlade-2023/construction/STLs/ember_skirt_print.stl

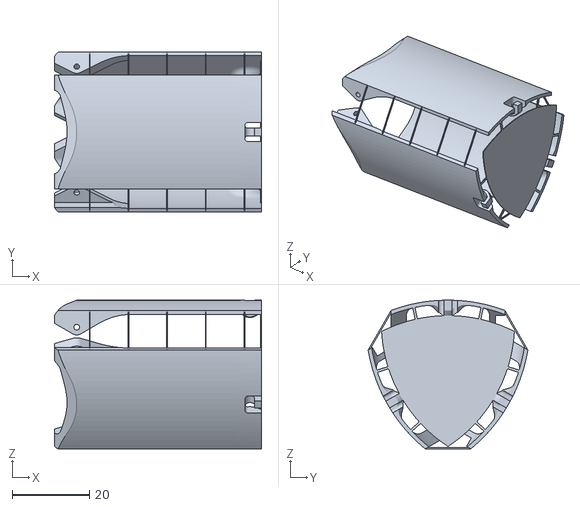
[picture p75: CAD file, 2023-05-01]
construction/STLs/ember_skirt_print.stl
53.5 x 41.3 x 38.4
