cansat-tsniimash/NeonBlade-2023/schematics/DXFs/ma_2floar_plata.dxf

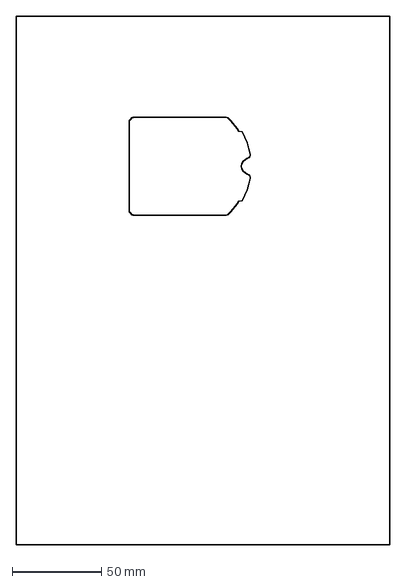
[picture p76: CAD file, 2023-02-19]
schematics/DXFs/ma_2floar_plata.dxf
210.0 x 297.0 mm
