cansat-tsniimash/NeonBlade-2023/construction/STLs/cup_up_doch.stl

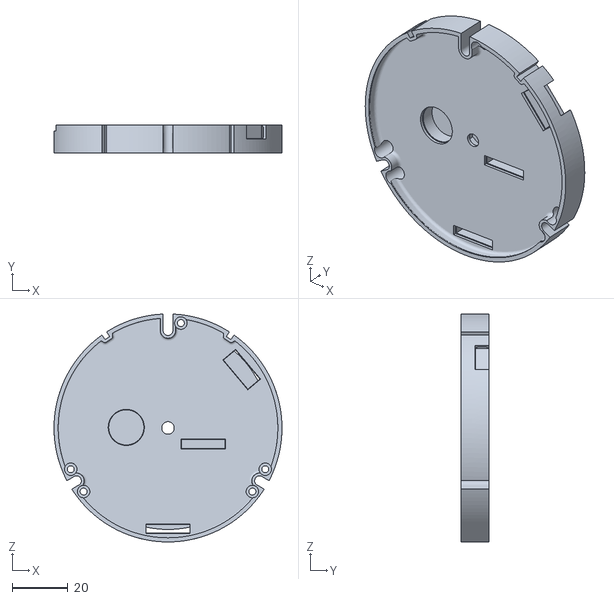
[picture p77: CAD file, 2023-04-15]
construction/STLs/cup_up_doch.stl
82.0 x 10.0 x 82.0
