cansat-tsniimash/NeonBlade-2023/schematics/DXFs/plata_optical_module.dxf

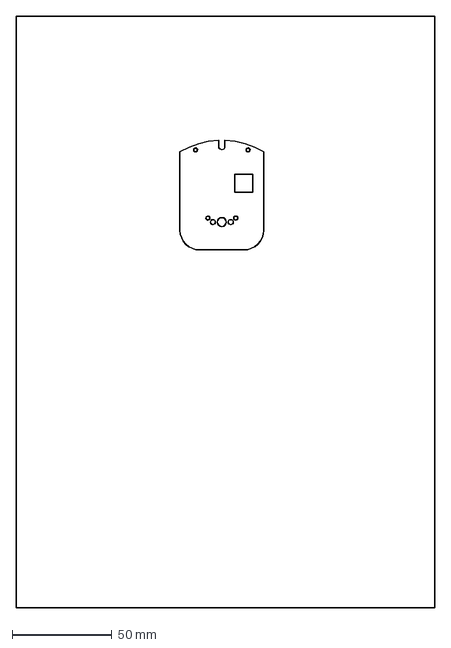
[picture p78: CAD file, 2023-02-08]
schematics/DXFs/plata_optical_module.dxf
210.0 x 297.0 mm
