cansat-tsniimash/NeonBlade-2023/construction/STLs/lm_korpus.stl

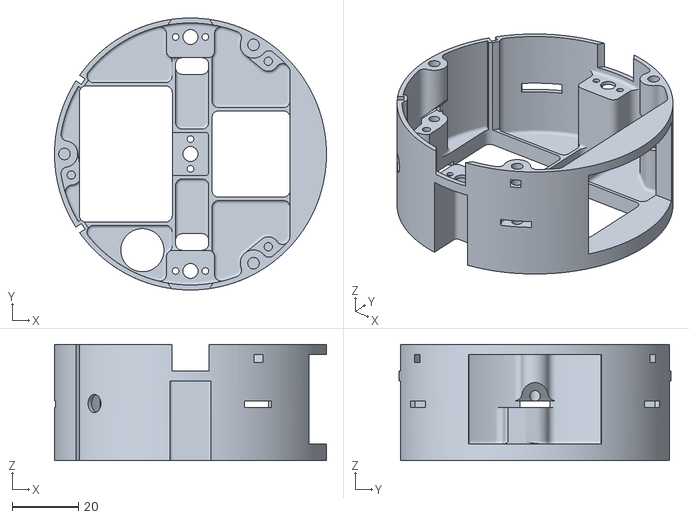
[picture p79: CAD file, 2023-04-14]
construction/STLs/lm_korpus.stl
82.0 x 82.0 x 35.0
