cansat-tsniimash/NeonBlade-2023/construction/STLs/liluziverx.stl

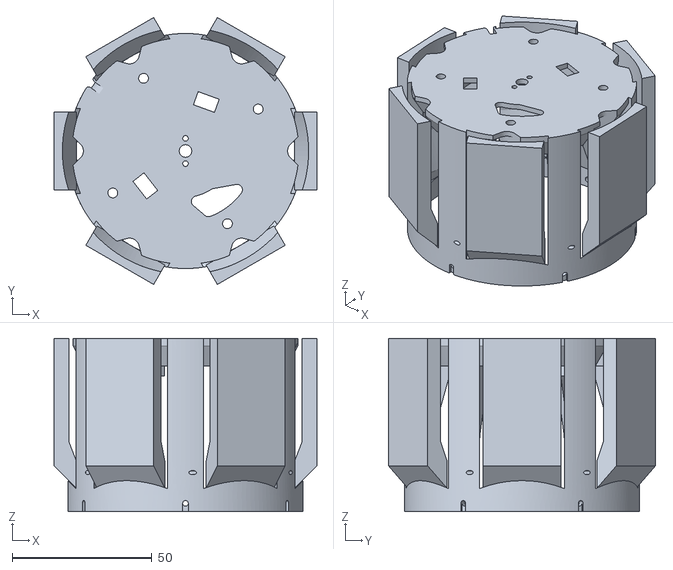
[picture p81: CAD file, 2023-04-14]
construction/STLs/liluziverx.stl
94.0 x 95.4 x 62.0
