cansat-tsniimash/NeonBlade-2023/schematics/DXFs/plata_interface.dxf

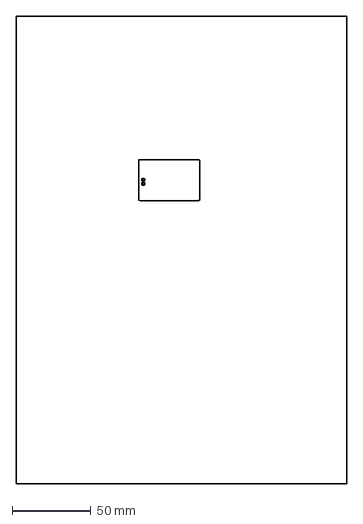
[picture p82: CAD file, 2023-02-08]
schematics/DXFs/plata_interface.dxf
210.0 x 297.0 mm
