cansat-tsniimash/NeonBlade-2023/construction/STLs/lil_uzi_otvet.stl

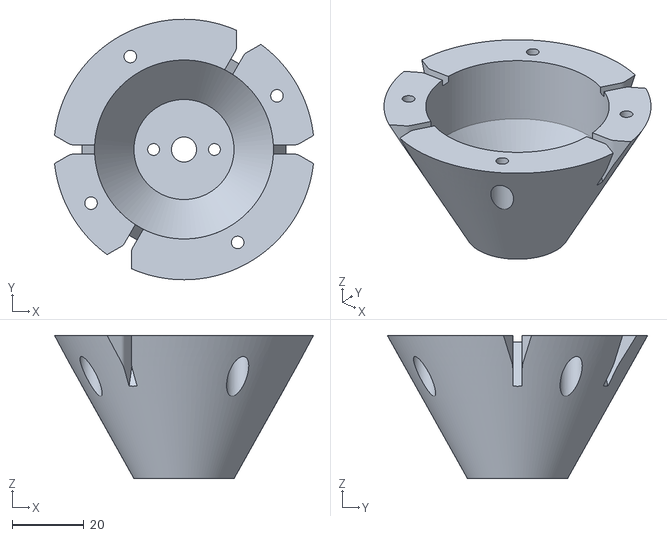
[picture p83: CAD file, 2023-04-14]
construction/STLs/lil_uzi_otvet.stl
72.4 x 72.8 x 40.0
