cansat-tsniimash/NeonBlade-2023/schematics/DXFs/plata_low_module_second.dxf

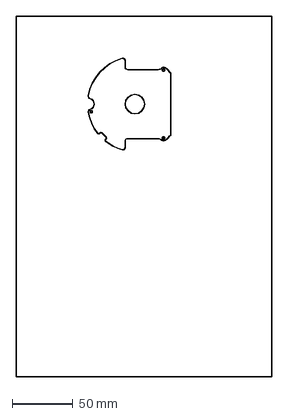
[picture p84: CAD file, 2023-02-08]
schematics/DXFs/plata_low_module_second.dxf
210.0 x 297.0 mm
