cansat-tsniimash/NeonBlade-2023/schematics/DXFs/plata_doch.dxf

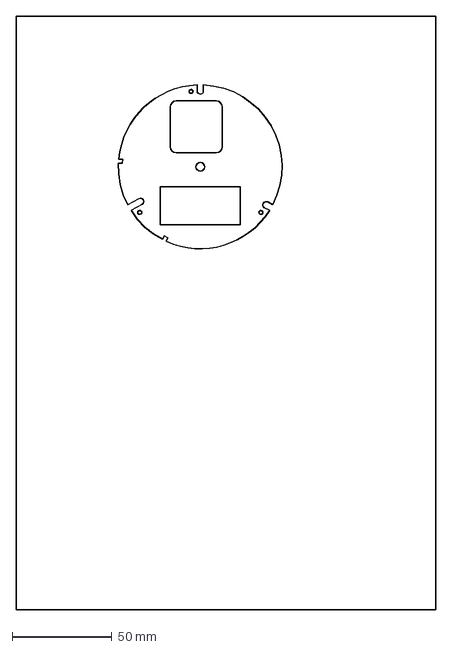
[picture p85: CAD file, 2023-02-08]
schematics/DXFs/plata_doch.dxf
210.0 x 297.0 mm
