cansat-tsniimash/NeonBlade-2023/construction/STLs/mm_korpus.stl

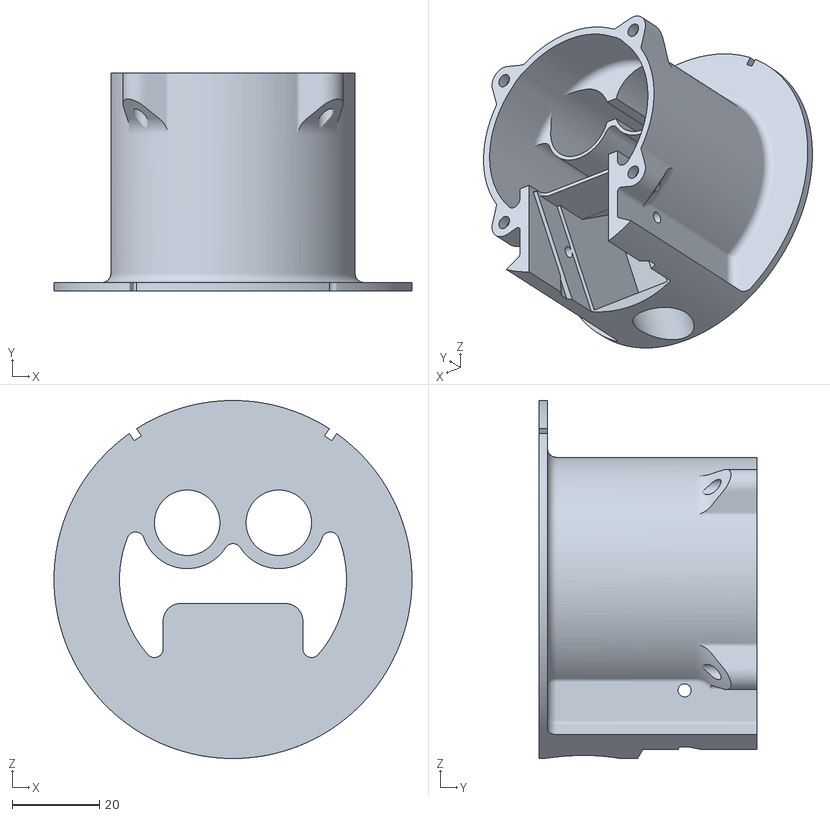
[picture p86: CAD file, 2023-03-25]
construction/STLs/mm_korpus.stl
82.0 x 50.0 x 82.0
