cansat-tsniimash/NeonBlade-2023/construction/STLs/shkiv.stl

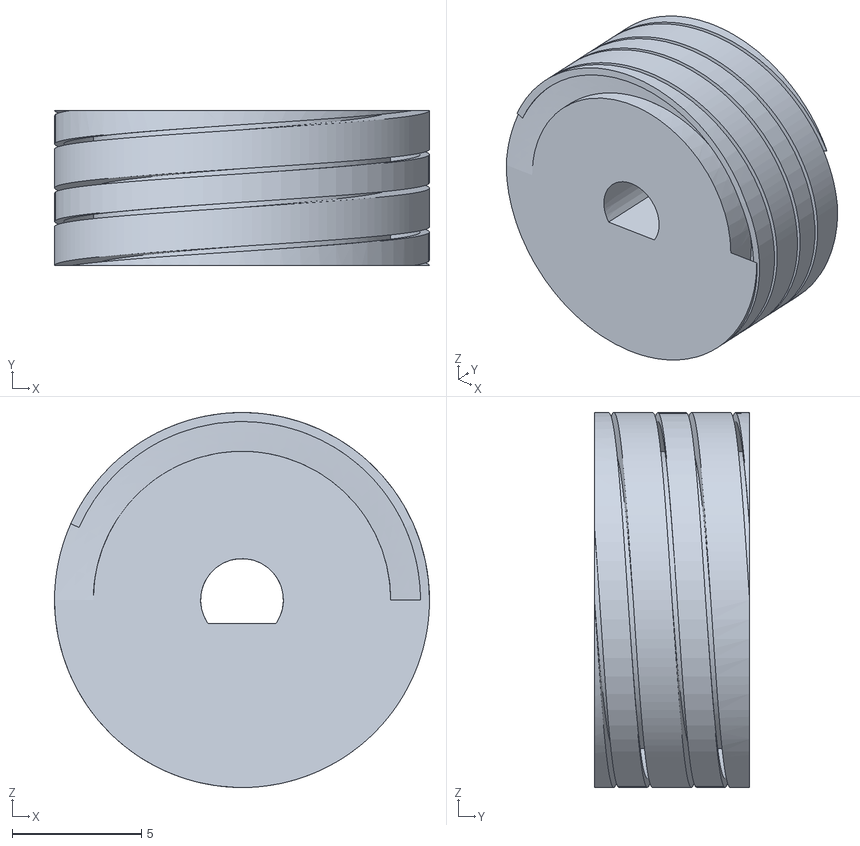
[picture p87: CAD file, 2023-03-25]
construction/STLs/shkiv.stl
14.5 x 6.00 x 14.5
