cansat-tsniimash/NeonBlade-2023/construction/STLs/krug_michail.stl

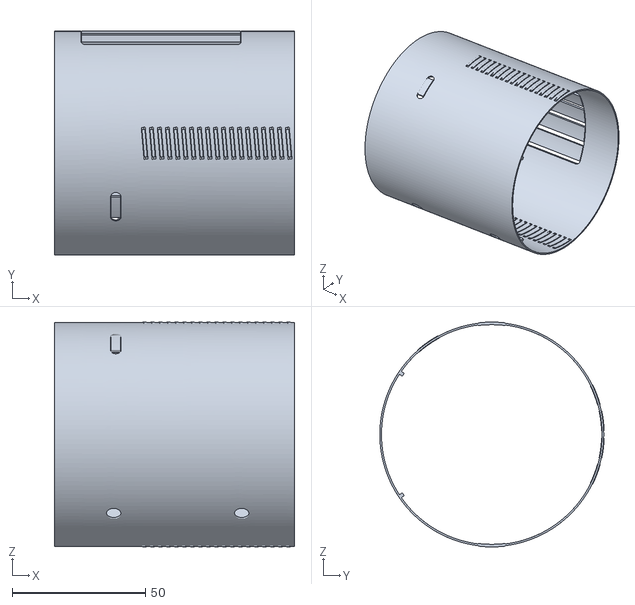
[picture p88: CAD file, 2023-03-25]
construction/STLs/krug_michail.stl
90.0 x 84.2 x 84.3
