cansat-tsniimash/NeonBlade-2023/construction/STLs/cup_om.stl

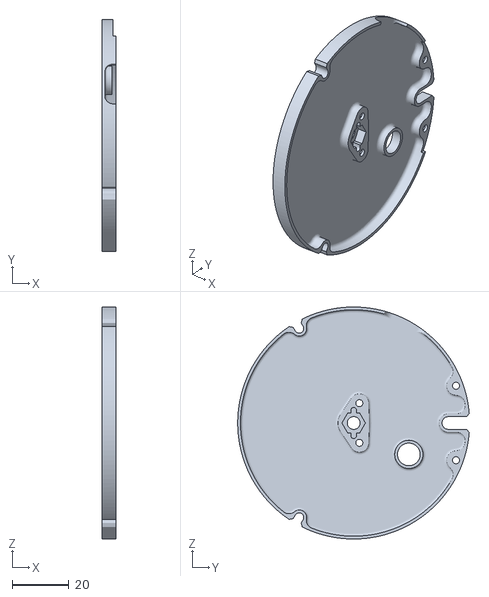
[picture p89: CAD file, 2023-01-27]
construction/STLs/cup_om.stl
5.00 x 81.9 x 82.0
