cansat-tsniimash/NeonBlade-2023/(list of files, cad)

Other CAD files:
construction/STLs/cup_bottom_doch.stl
construction/3Dmodel_mothership/bass_buzzer.prt
construction/3Dmodel_mothership/battery_li-pol_lp402030.prt
construction/3Dmodel_mothership/bme280_module.prt
construction/3Dmodel_mothership/bobine.prt
construction/3Dmodel_mothership/button.prt
construction/3Dmodel_mothership/camera-sq11.prt
construction/3Dmodel_mothership/connector-ffc_686115148922.prt
construction/3Dmodel_mothership/connector-ffc_6pins.prt
construction/3Dmodel_mothership/connector-pbd-20r.prt
construction/3Dmodel_mothership/connector-pbs-8.prt
construction/3Dmodel_mothership/connector-pls-4.prt
construction/3Dmodel_mothership/connector_b2b-eh-a.prt
construction/3Dmodel_mothership/cup_babina.prt
construction/3Dmodel_mothership/cup_bottom_da.prt
construction/3Dmodel_mothership/cup_om.prt
construction/3Dmodel_mothership/cup_up_da.prt
construction/3Dmodel_mothership/dc_dc.prt
construction/3Dmodel_mothership/ember_skirt_print.prt
construction/3Dmodel_mothership/esp32_cam.prt
construction/3Dmodel_mothership/fairing-top.prt
construction/3Dmodel_mothership/fairing.prt
construction/3Dmodel_mothership/fotorez.prt
construction/3Dmodel_mothership/gps_antenna.prt
construction/3Dmodel_mothership/gps_ublox_neo-7m-0-000.prt
construction/3Dmodel_mothership/gpstwo.prt
construction/3Dmodel_mothership/gy-lsm6ds3_lsm6ds3.prt
construction/3Dmodel_mothership/ic_mc_stm32f405rgt6.prt
construction/3Dmodel_mothership/ina219_module.prt
construction/3Dmodel_mothership/li-ion-cell_icr18350-1400.prt
construction/3Dmodel_mothership/lm_bottom_board.prt
construction/3Dmodel_mothership/lm_korpus.prt
construction/3Dmodel_mothership/lm_up_board.prt
construction/3Dmodel_mothership/magnetometer_cjmcu-lis3mdl.prt
construction/3Dmodel_mothership/magnetometer_lis3mdl.prt
construction/3Dmodel_mothership/microsd_connector_502774-0891.prt
construction/3Dmodel_mothership/mm_korpus.prt
construction/3Dmodel_mothership/motor-reductor-screw4mm.prt
construction/3Dmodel_mothership/motor-reductor.prt
construction/3Dmodel_mothership/nrf24l01_pa_lna_e01_ml01sp4.prt
construction/3Dmodel_mothership/parachute_compartment.prt
construction/3Dmodel_mothership/plata_da.prt
construction/3Dmodel_mothership/plata_interface.prt
construction/3Dmodel_mothership/plata_stoper.prt
construction/3Dmodel_mothership/platada_om.prt
construction/3Dmodel_mothership/rocket.prt
construction/3Dmodel_mothership/rod.prt
construction/3Dmodel_mothership/shtift_m2.prt
construction/3Dmodel_mothership/skirt.prt
construction/3Dmodel_mothership/spring_0_4x2_4x19_6.prt
construction/3Dmodel_mothership/switch_pin_down_ss12d10.prt
construction/3Dmodel_mothership/switch_right_mss12d01.prt
construction/3Dmodel_mothership/switch_sk12f14.prt
construction/3Dmodel_mothership/topcorpus.prt
construction/3Dmodel_mothership/windgen-generator.prt
construction/3Dmodel_mothership/windgen-vint.prt
construction/3Dmodel_mothership/worm_gear.prt
construction/3Dmodel_mothership/xq_02a_usilitel.prt
