cansat-tsniimash/NeonBlade-2023/docs/Видеозачет/Печатные платы/MA_board_2.brd

## EAGLE design docs/Видеозачет/Печатные платы/MA_board_2.brd (2023-03-26)

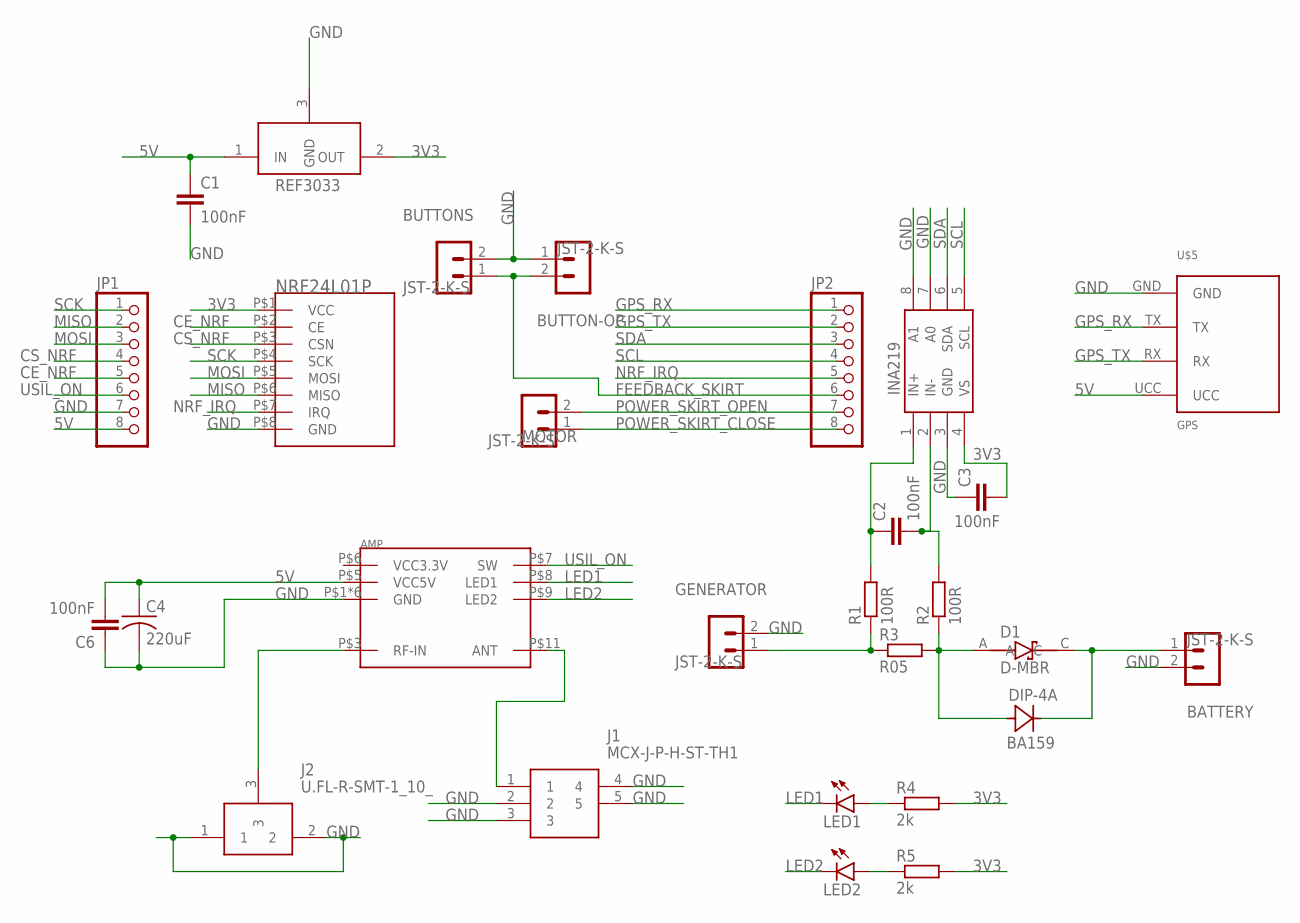
[picture p90: schematic MA_board_2.sch]

Parts:
AMP: XQ-02A
BATTERY: JST-2-K-S; B2B-PH-K-S
BUTTON-OP: JST-2-K-S; B2B-PH-K-S
BUTTONS: JST-2-K-S; B2B-PH-K-S
C1, C2, C3, C6: 100nF; C0603
C4: 220uF; ECAP220-CMD
D1: D-MBR; SOD123
DIP-4A: BA159
GENERATOR: JST-2-K-S; B2B-PH-K-S
INA219: INA219AID; SOT23-8
J1: MCX-J-P-H-ST-TH1; MCXJPHSTTH1
J2: U.FL-R-SMT-1_10_; U.FL-R-SMT-1(10)
JP1, JP2: PINHD-1X8-SHORT-PAD; 1X08
LED1, LED2: LEDSML0603; SML0603
MOTOR: JST-2-K-S; B2B-PH-K-S
NRF24L01P: NRF24L01_ML01SP4
R1, R2: 100R; R0603
R3: R05; R2512
R4, R5: 2k; R0603
REF3033: REF3033; SOT23-3
U$5: GPS

Connections:
3V3: C3.2, INA219.4 (VS), NRF24L01P.P$1 (VCC), R4.2, R5.2, REF3033.2 (OUT)
5V: AMP.P$5 (VCC5V), C1.1, C4.P$1 (1), C6.2, JP1.8, REF3033.1 (IN), U$5.UCC
CE_NRF: JP1.5, NRF24L01P.P$2 (CE)
CS_NRF: JP1.4, NRF24L01P.P$3 (CSN)
FEEDBACK_SKIRT: BUTTON-OP.2, BUTTONS.1, JP2.6
GND: AMP.P$1 (GND), AMP.P$2 (GND), AMP.P$4 (GND), AMP.P$10 (GND), AMP.P$12 (GND), AMP.P$13 (GND), BATTERY.2, BUTTON-OP.1, BUTTONS.2, C1.2, C3.1, C4.P$2 (2), C6.1, GENERATOR.2, INA219.3 (GND), INA219.7 (A0), INA219.8 (A1), J1.2, J1.3, J1.4, J1.5, J2.1, J2.2, JP1.7, NRF24L01P.P$8 (GND), REF3033.3 (GND), U$5.GND
GPS_RX: JP2.1, U$5.TX
GPS_TX: JP2.2, U$5.RX
LED1: AMP.P$8 (LED1), LED1.C
LED2: AMP.P$9 (LED2), LED2.C
MISO: JP1.2, NRF24L01P.P$6 (MISO)
MOSI: JP1.3, NRF24L01P.P$5 (MOSI)
unnamed: C2.1, INA219.1 (IN+), R1.2
unnamed: AMP.P$3 (RF-IN), J2.3
unnamed: AMP.P$11 (ANT), J1.1
unnamed: GENERATOR.1, R1.1, R3.1
unnamed: C2.2, INA219.2 (IN-), R2.2
unnamed: BATTERY.1, D1.C, DIP-4A.P$2 (C)
unnamed: LED1.A, R4.1
unnamed: D1.A, DIP-4A.P$1 (A), R2.1, R3.2
unnamed: LED2.A, R5.1
NRF_IRQ: JP2.5, NRF24L01P.P$7 (IRQ)
POWER_SKIRT_CLOSE: JP2.8, MOTOR.1
POWER_SKIRT_OPEN: JP2.7, MOTOR.2
SCK: JP1.1, NRF24L01P.P$4 (SCK)
SCL: INA219.5 (SCL), JP2.4
SDA: INA219.6 (SDA), JP2.3
USIL_ON: AMP.P$7 (SW), JP1.6

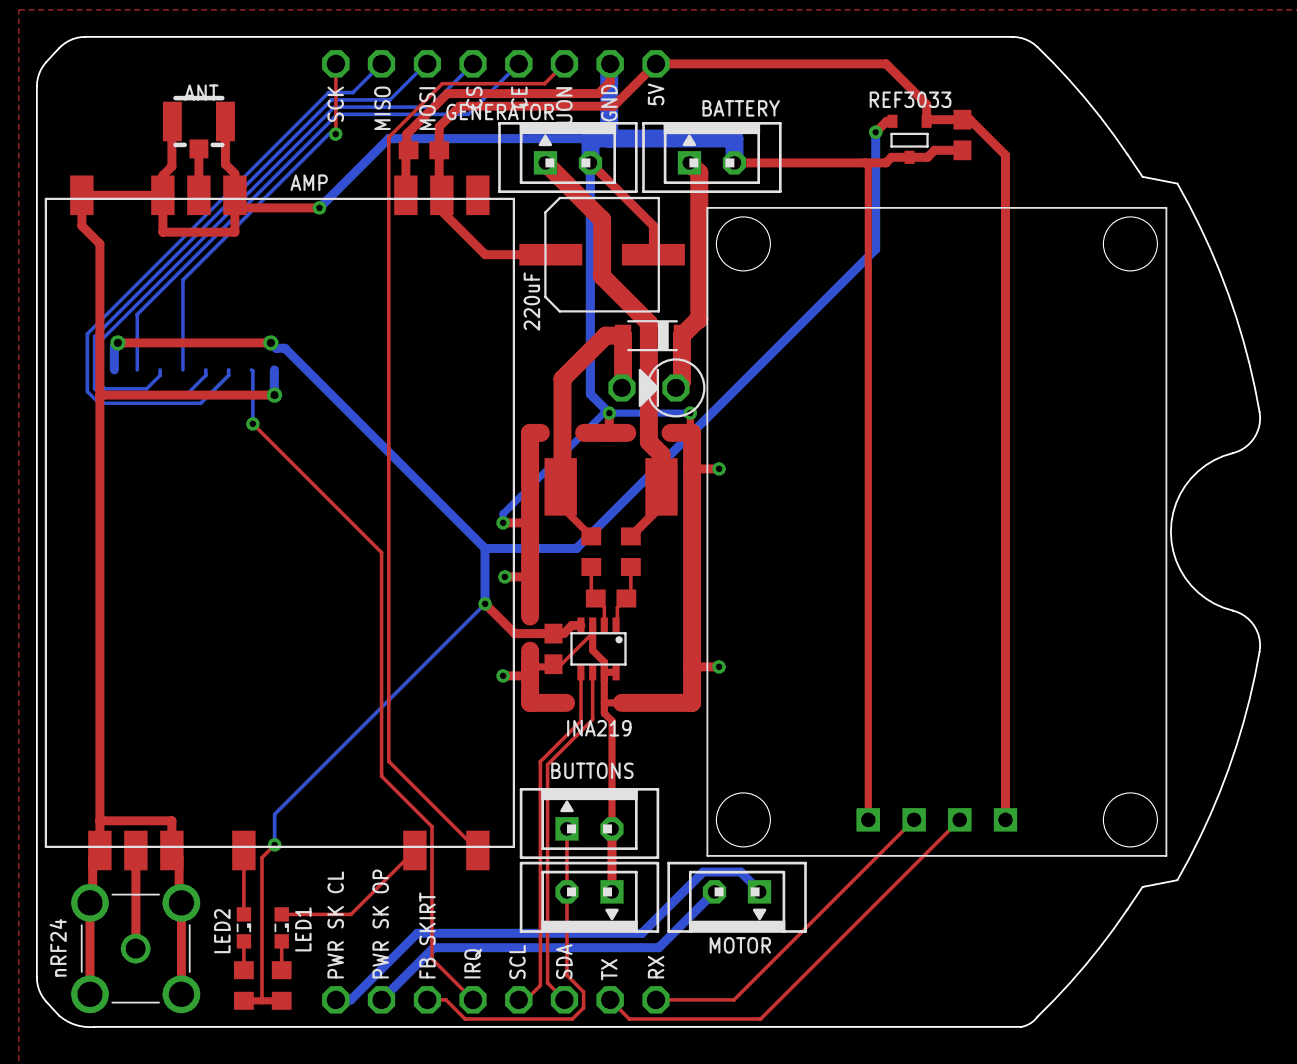
[picture p91: board MA_board_2.brd from above]

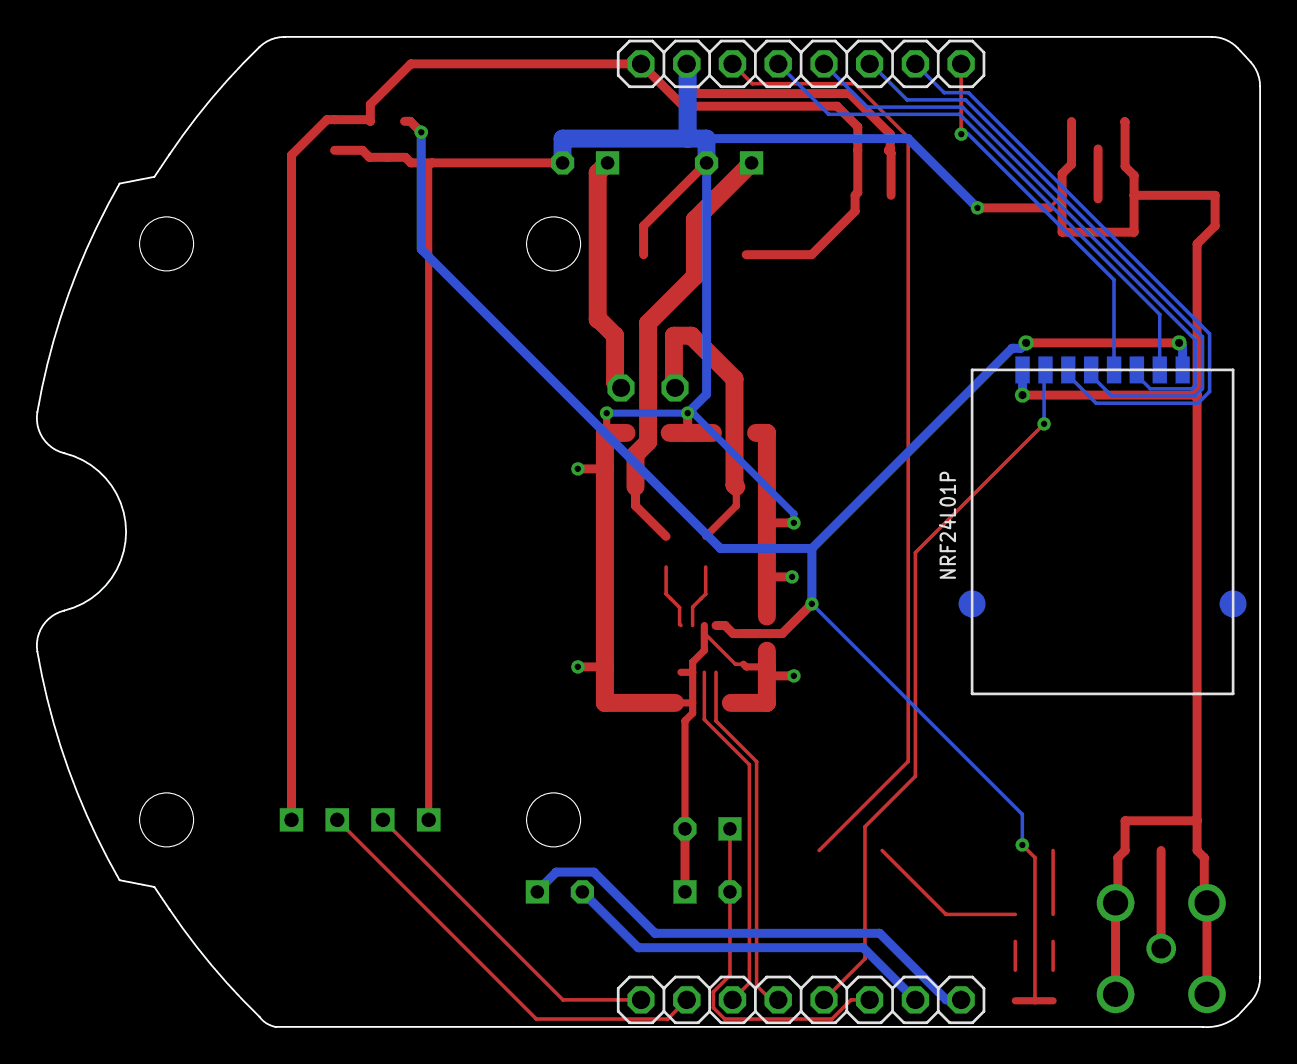
[picture p92: board MA_board_2.brd from below]

Board: 2 copper layers, 68.0 x 55.0 mm, 28 parts (3 on the bottom side), 28 nets.
