cansat-tsniimash/NeonBlade-2023/docs/Видеозачет/Печатные платы/MA_board_1.brd

## EAGLE design docs/Видеозачет/Печатные платы/MA_board_1.brd (2023-05-01)

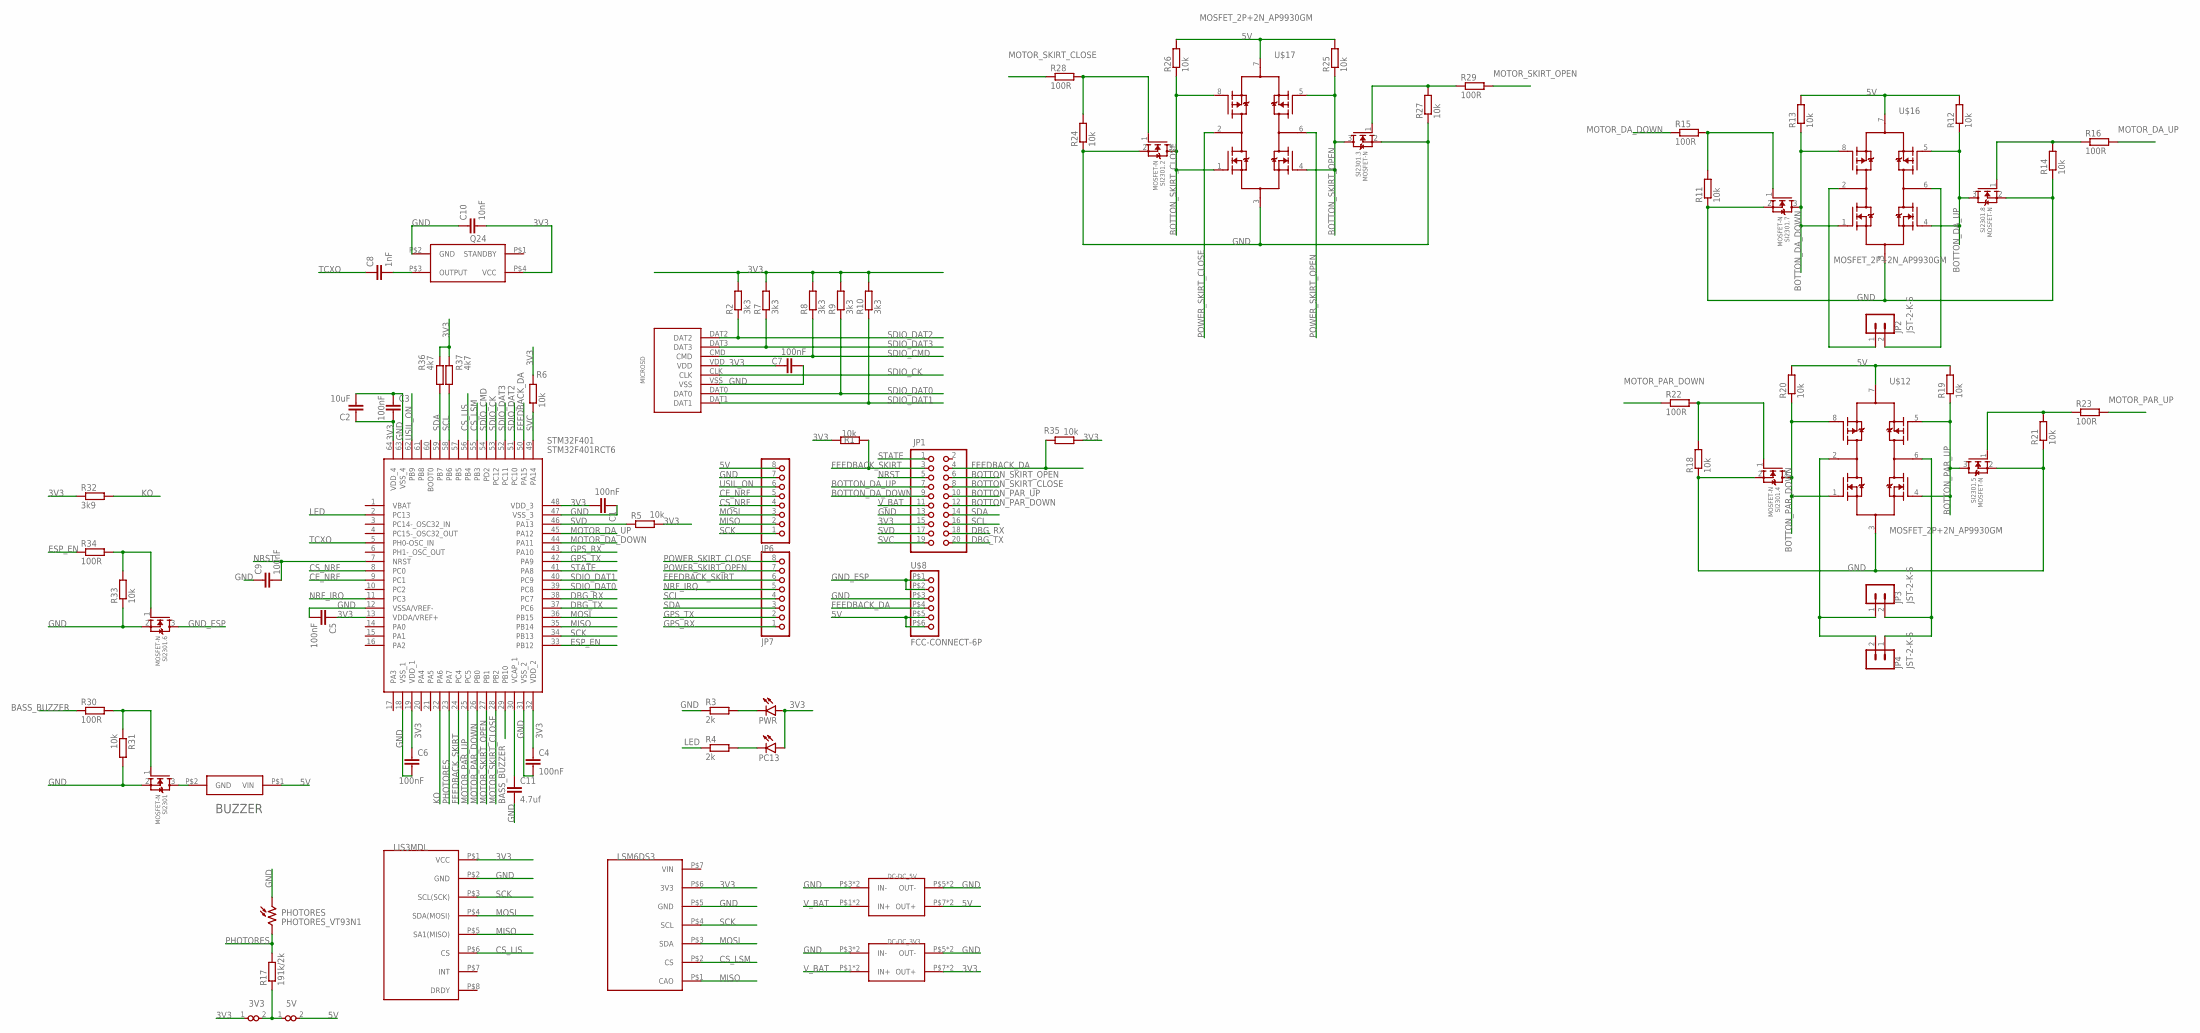
[picture p93: schematic MA_board_1.sch]

Parts:
3V3, 5V: VIAS-CONNECT
BUZZER: BUZZERS8R6; BUZZER-S8R12
C1, C3, C4, C5, C6, C7, C9: 100nF; C0603
C2: 10uF; C1206
C8: 1nF; C0603
C10: 10nF; C0603
C11: 4.7uf; C0603
DC-DC_3V3, DC-DC_5V: MP1584-B
JP1: PINHD-2X10/90; 2X10/90
JP2, JP3, JP4: JST-2-K-S; B2B-PH-K-S
JP6, JP7: PINHD-1X8-SHORT-PAD; 1X08
LIS3MDL: LIS3MDL-CJMCUБез_отв._зеркальный; LIS3MDL-CGMSU-NB2023
LSM6DS3: LSM6DS3-GY-NB2023
MICROSD: SD
PC13: LEDCHIPLED_0603; CHIPLED_0603
PHOTORES: PHOTORES_VT93N1; PHOTORES_VT93N1_SMD
PWR: LEDCHIPLED_0603; CHIPLED_0603
Q24: Q24
R1, R5, R6, R11, R12, R13, R14, R18, R19, R20, R21, R24, R25, R26, R27, R31, R33, R35: 10k; R0603
R2, R7, R8, R9, R10: 3k3; R0603
R3, R4: 2k; R0603
R15, R16, R22, R23, R28, R29, R30, R34: 100R; R0603
R17: 191k/2k; R0603
R32: 3k9; R0603
R36, R37: 4k7; R0603
SI2301, SI2301.2, SI2301.3, SI2301.4, SI2301.5, SI2301.6, SI2301.7, SI2301.8: MOSFET-N; SOT23-3
STM32F401: STM32F401RCT6; QFP50P1200X1200X160-64N
U$8: FCC-CONNECT-6P; FFC-CONNECT-6P-SMD
U$12, U$16, U$17: MOSFET_2P+2N_AP9930GM; SO8

Connections:
3V3: 3V3.1, C1.2, C2.1, C3.2, C4.1, C5.1, C6.1, C7.2, C10.2, DC-DC_3V3.P$7 (OUT+), DC-DC_3V3.P$8 (OUT+), JP1.15, LIS3MDL.P$1 (VCC), LSM6DS3.P$6 (3V3), MICROSD.VDD, PC13.A, PWR.A, Q24.P$4 (VCC), R1.2, R2.2, R5.2, R6.2, R7.2, R8.2, R9.2, R10.2, R32.1, R35.1, R36.2, R37.2, STM32F401.13 (VDDA/VREF+), STM32F401.19 (VDD_1), STM32F401.32 (VDD_2), STM32F401.48 (VDD_3), STM32F401.64 (VDD_4)
5V: 5V.2, BUZZER.P$1 (VIN), DC-DC_5V.P$7 (OUT+), DC-DC_5V.P$8 (OUT+), JP6.8, R12.2, R13.2, R19.2, R20.2, R25.2, R26.2, U$8.P$5 (5), U$8.P$6 (6), U$12.7 (P1P2S), U$16.7 (P1P2S), U$17.7 (P1P2S)
BASS_BUZZER: R30.1, STM32F401.29 (PB10)
BOTTON_DA_DOWN: JP1.9, R13.1, SI2301.7.3 (D), U$16.1 (N1G), U$16.8 (P1G)
BOTTON_DA_UP: JP1.7, R12.1, SI2301.8.3 (D), U$16.4 (N2G), U$16.5 (P2G)
BOTTON_PAR_DOWN: JP1.12, R20.1, SI2301.4.3 (D), U$12.1 (N1G), U$12.8 (P1G)
BOTTON_PAR_UP: JP1.10, R19.1, SI2301.5.3 (D), U$12.4 (N2G), U$12.5 (P2G)
BOTTON_SKIRT_CLOSE: JP1.8, R26.1, SI2301.2.3 (D), U$17.1 (N1G), U$17.8 (P1G)
BOTTON_SKIRT_OPEN: JP1.6, R25.1, SI2301.3.3 (D), U$17.4 (N2G), U$17.5 (P2G)
CE_NRF: JP6.5, STM32F401.9 (PC1)
CS_LIS: LIS3MDL.P$6 (CS), STM32F401.56 (PB4)
CS_LSM: LSM6DS3.P$2 (CS), STM32F401.55 (PB3)
CS_NRF: JP6.4, STM32F401.8 (PC0)
DBG_RX: JP1.18, STM32F401.38 (PC7)
DBG_TX: JP1.20, STM32F401.37 (PC6)
ESP_EN: R34.1, STM32F401.33 (PB12)
FEEDBACK_DA: JP1.4, R35.2, STM32F401.50 (PA15), U$8.P$4 (4)
FEEDBACK_SKIRT: JP1.3, JP7.6, R1.1, STM32F401.24 (PC4)
GND: C1.1, C2.2, C3.1, C4.2, C5.2, C6.2, C7.1, C9.1, C10.1, C11.2, DC-DC_3V3.P$3 (IN-), DC-DC_3V3.P$4 (IN-), DC-DC_3V3.P$5 (OUT-), DC-DC_3V3.P$6 (OUT-), DC-DC_5V.P$3 (IN-), DC-DC_5V.P$4 (IN-), DC-DC_5V.P$5 (OUT-), DC-DC_5V.P$6 (OUT-), JP1.13, JP6.7, LIS3MDL.P$2 (GND), LSM6DS3.P$5 (GND), MICROSD.VSS, PHOTORES.P$1 (1), Q24.P$2 (GND), R3.1, R11.1, R14.1, R18.1, R21.1, R24.1, R27.1, R31.2, R33.1, SI2301.2 (S), SI2301.2.2 (S), SI2301.3.2 (S), SI2301.4.2 (S), SI2301.5.2 (S), SI2301.6.2 (S), SI2301.7.2 (S), SI2301.8.2 (S), STM32F401.12 (VSSA/VREF-), STM32F401.18 (VSS_1), STM32F401.31 (VSS_2), STM32F401.47 (VSS_3), STM32F401.63 (VSS_4), U$8.P$3 (3), U$12.3 (N1N2S), U$16.3 (N1N2S), U$17.3 (N1N2S)
GND_ESP: SI2301.6.3 (D), U$8.P$1 (1), U$8.P$2 (2)
GPS_RX: JP7.1, STM32F401.43 (PA10)
GPS_TX: JP7.2, STM32F401.42 (PA9)
KO: R32.2, STM32F401.22 (PA6)
LED: R4.1, STM32F401.2 (PC13)
MISO: JP6.2, LIS3MDL.P$5 (SA1(MISO)), LSM6DS3.P$1 (CAO), STM32F401.35 (PB14)
MOSI: JP6.3, LIS3MDL.P$4 (SDA(MOSI)), LSM6DS3.P$3 (SDA), STM32F401.36 (PB15)
MOTOR_DA_DOWN: R15.1, STM32F401.44 (PA11)
MOTOR_DA_UP: R16.2, STM32F401.45 (PA12)
MOTOR_PAR_DOWN: R22.1, STM32F401.26 (PB0)
MOTOR_PAR_UP: R23.2, STM32F401.25 (PC5)
MOTOR_SKIRT_CLOSE: R28.1, STM32F401.28 (PB2)
MOTOR_SKIRT_OPEN: R29.2, STM32F401.27 (PB1)
unnamed: R30.2, R31.1, SI2301.1 (G)
unnamed: R11.2, R15.2, SI2301.7.1 (G)
unnamed: R18.2, R22.2, SI2301.4.1 (G)
unnamed: R33.2, R34.2, SI2301.6.1 (G)
unnamed: JP3.1, JP4.2, U$12.2 (P1N1D)
unnamed: JP2.1, U$16.2 (P1N1D)
unnamed: JP2.2, U$16.6 (P2N2D)
unnamed: R14.2, R16.1, SI2301.8.1 (G)
unnamed: JP3.2, JP4.1, U$12.6 (P2N2D)
unnamed: C8.2, Q24.P$3 (OUTPUT)
unnamed: R21.2, R23.1, SI2301.5.1 (G)
unnamed: C11.1, STM32F401.30 (VCAP_1)
unnamed: 3V3.2, 5V.1, R17.1
unnamed: R24.2, R28.2, SI2301.2.1 (G)
unnamed: R27.2, R29.1, SI2301.3.1 (G)
unnamed: BUZZER.P$2 (GND), SI2301.3 (D)
unnamed: PWR.C, R3.2
unnamed: PC13.C, R4.2
NRF_IRQ: JP7.5, STM32F401.11 (PC3)
NRST: C9.2, JP1.5, STM32F401.7 (NRST)
PHOTORES: PHOTORES.P$2 (2), R17.2, STM32F401.23 (PA7)
POWER_SKIRT_CLOSE: JP7.8, U$17.2 (P1N1D)
POWER_SKIRT_OPEN: JP7.7, U$17.6 (P2N2D)
SCK: JP6.1, LIS3MDL.P$3 (SCL(SCK)), LSM6DS3.P$4 (SCL), STM32F401.34 (PB13)
SCL: JP1.16, JP7.4, R37.1, STM32F401.58 (PB6)
SDA: JP1.14, JP7.3, R36.1, STM32F401.59 (PB7)
SDIO_CK: MICROSD.CLK, STM32F401.53 (PC12)
SDIO_CMD: MICROSD.CMD, R8.1, STM32F401.54 (PD2)
SDIO_DAT0: MICROSD.DAT0, R9.1, STM32F401.39 (PC8)
SDIO_DAT1: MICROSD.DAT1, R10.1, STM32F401.40 (PC9)
SDIO_DAT2: MICROSD.DAT2, R2.1, STM32F401.51 (PC10)
SDIO_DAT3: MICROSD.DAT3, R7.1, STM32F401.52 (PC11)
STATE: JP1.1, STM32F401.41 (PA8)
SVC: JP1.19, R6.1, STM32F401.49 (PA14)
SVD: JP1.17, R5.1, STM32F401.46 (PA13)
TCXO: C8.1, STM32F401.5 (PH0-OSC_IN)
USIL_ON: JP6.6, STM32F401.62 (PB9)
V_BAT: DC-DC_3V3.P$1 (IN+), DC-DC_3V3.P$2 (IN+), DC-DC_5V.P$1 (IN+), DC-DC_5V.P$2 (IN+), JP1.11

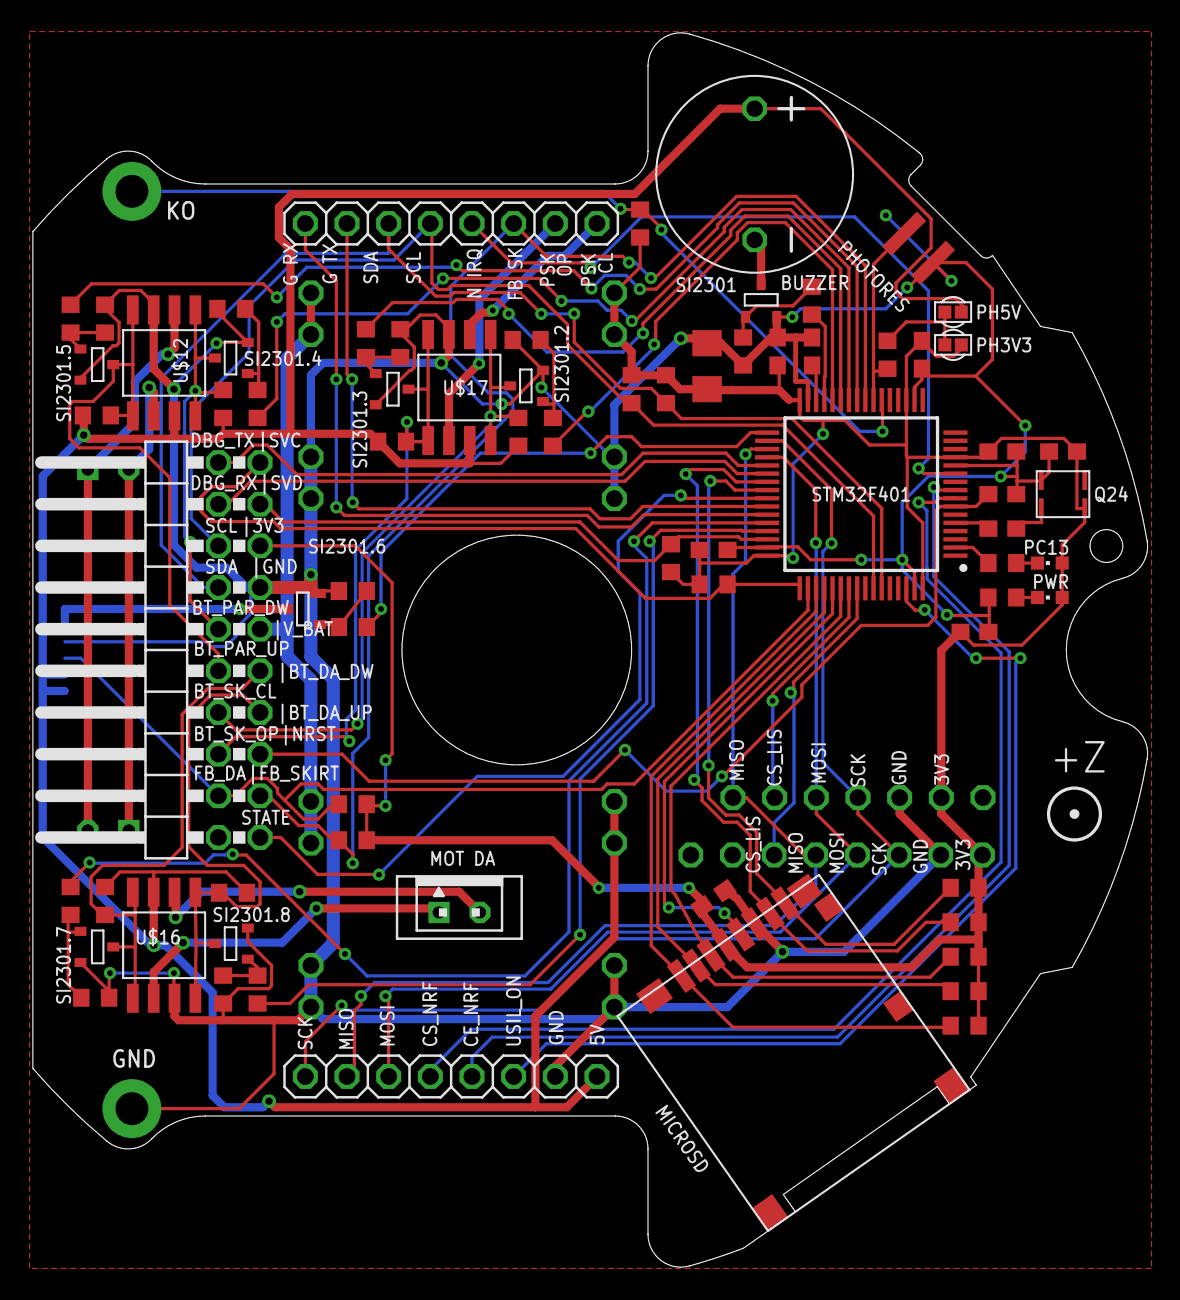
[picture p94: board MA_board_1.brd from above]

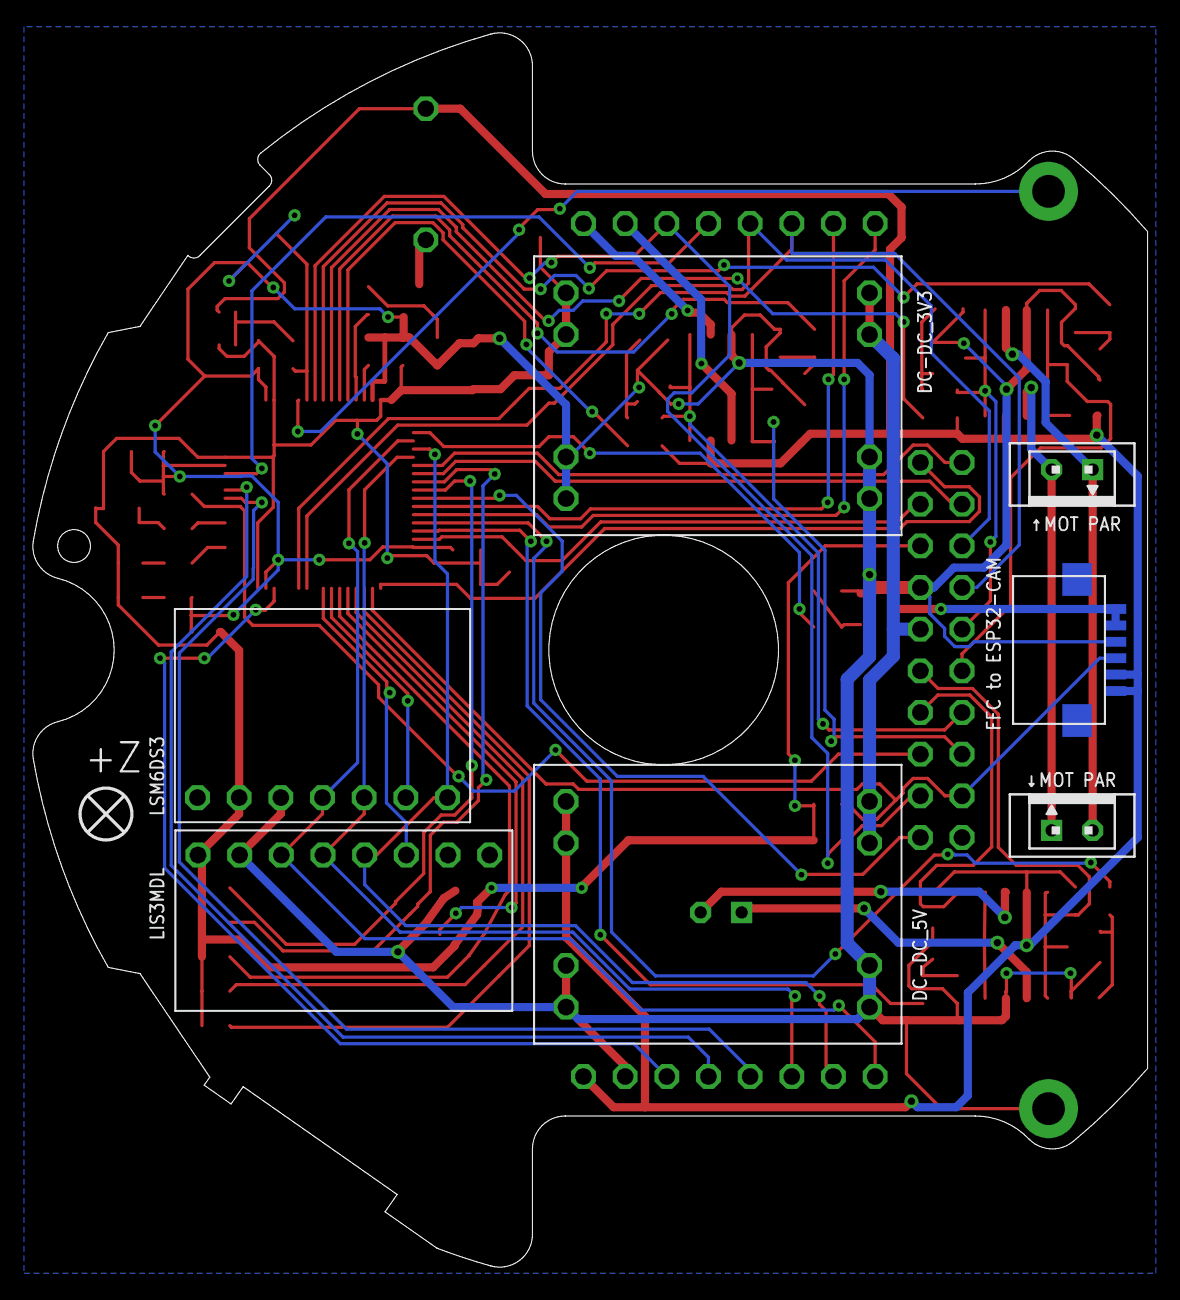
[picture p95: board MA_board_1.brd from below]

Board: 2 copper layers, 68.0 x 75.2 mm, 79 parts (5 on the bottom side), 70 nets.
