cansat-tsniimash/NeonBlade-2023/docs/Видеозачет/Печатные платы/DA.brd

## EAGLE design docs/Видеозачет/Печатные платы/DA.brd (2023-05-01)

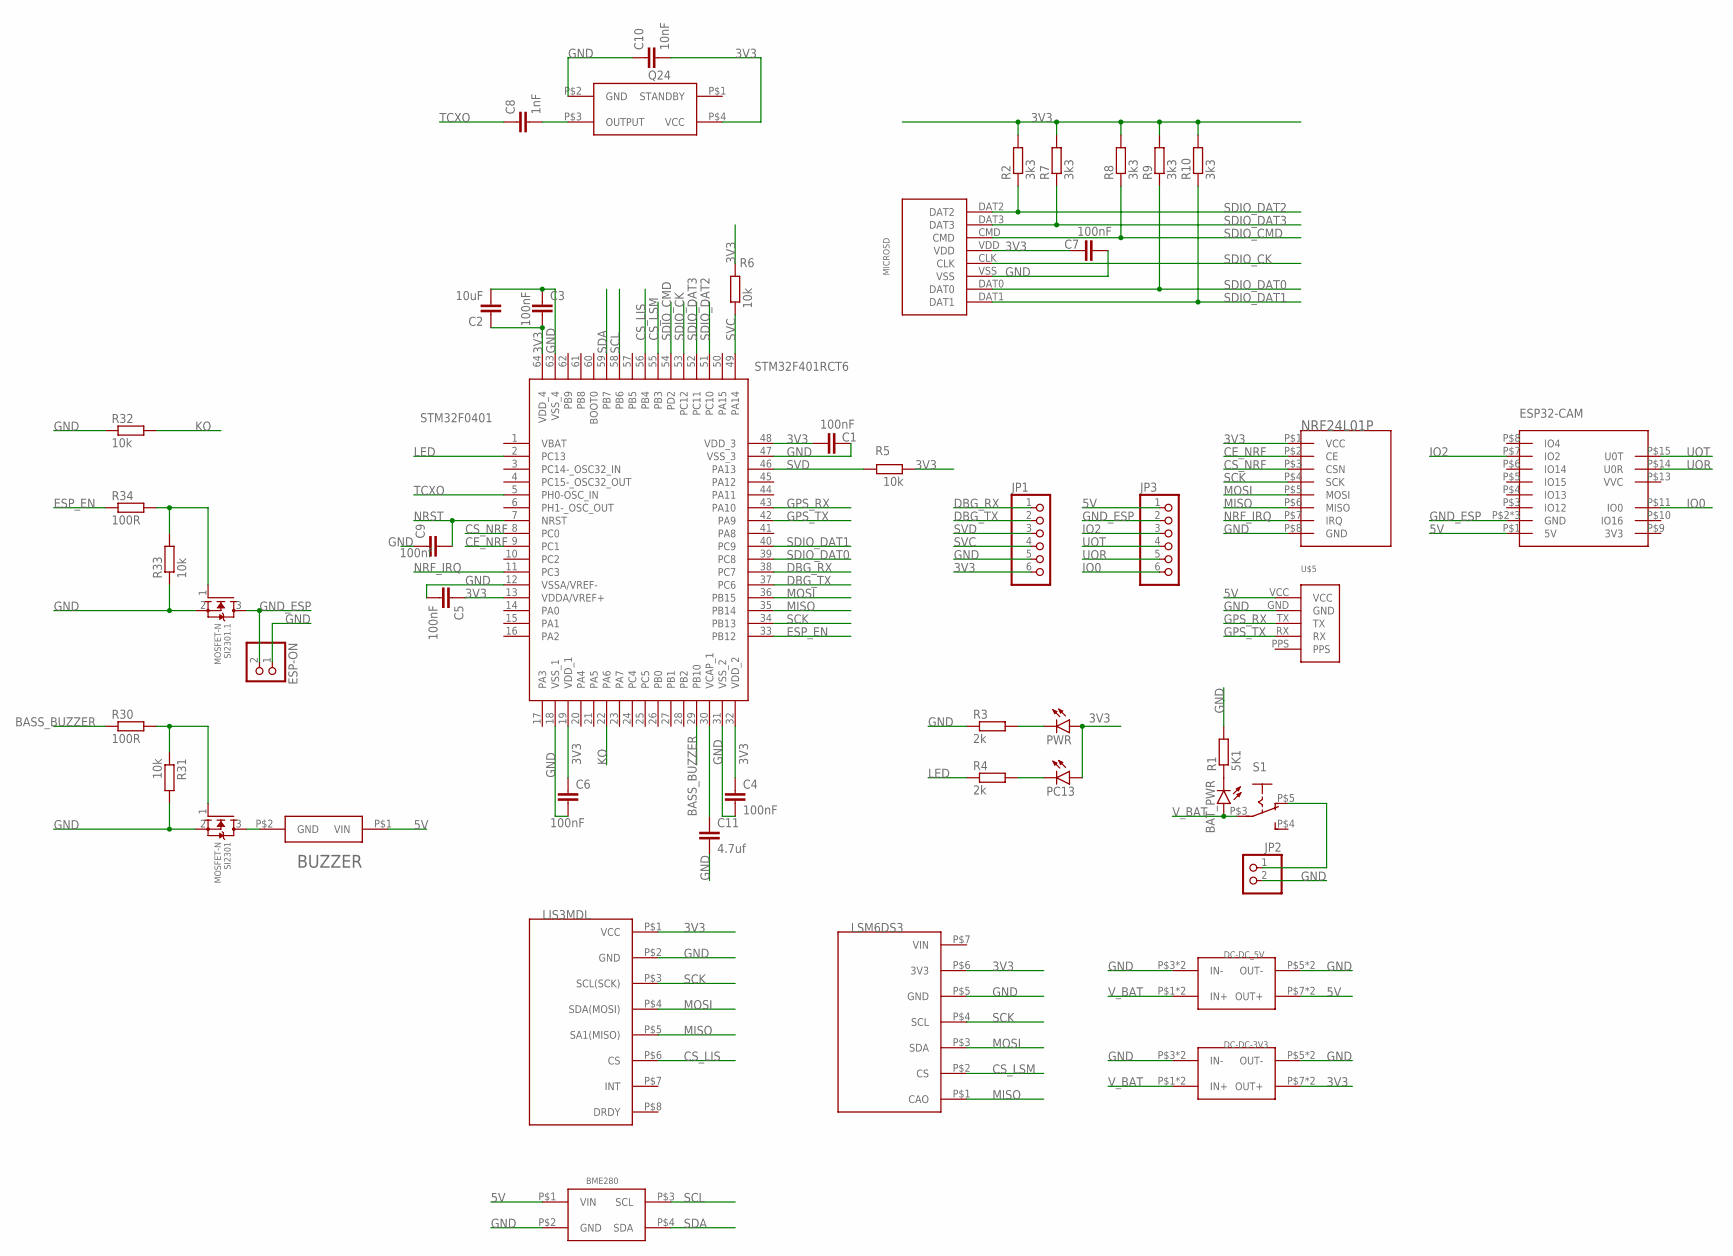
[picture p96: schematic DA.sch]

Parts:
BAT_PWR: LEDSML0603; SML0603
BME280: BME280BME280-PINS-ONLY; BME280-PINS-ONLY
BUZZER: BUZZERS8R6; BUZZER-S8R12
C1, C3, C4, C5, C6, C7: 100nF; C0603
C2: 10uF; C1206
C8: 1nF; C0603
C9: 100nf; C0603
C10: 10nF; C0603
C11: 4.7uf; C0603
DC-DC-3V3: MP1584-B
DC-DC_5V: MP1584-B
ESP32-CAM: ESP32-CAM
ESP-ON: PINHD-1X2; 1X02
JP1, JP3: PINHD-1X6; 1X06
JP2: PINHD-1X2; 1X02
LIS3MDL: LIS3MDL-CJMCUбез_отв.; LIS3MDL-CGMSU-NB2023-1
LSM6DS3: LSM6DS3-GY-NB2023Без_отв.; LSM6DS3-GY-NB2023-1
MICROSD: SD
NRF24L01P: NRF24L01_ML01SP4
PC13: LEDCHIPLED_0603; CHIPLED_0603
PWR: LEDCHIPLED_0603; CHIPLED_0603
Q24: Q24
R1: 5K1; R0603
R2, R7, R8, R9, R10: 3k3; R0603
R3, R4: 2k; R0603
R5, R6, R31, R32, R33: 10k; R0603
R30, R34: 100R; R0603
S1: UNICS-SWITCH; SWITCH_SK-12F14
SI2301, SI2301.1: MOSFET-N; SOT23-3
STM32F0401: STM32F401RCT6; QFP50P1200X1200X160-64N
U$5: GPS_NEO7M_W-PPS; GPS_NEO7M_W-PPS_&_ANT

Connections:
3V3: C1.2, C2.1, C3.2, C4.1, C5.1, C6.1, C7.2, C10.2, DC-DC-3V3.P$7 (OUT+), DC-DC-3V3.P$8 (OUT+), JP1.6, LIS3MDL.P$1 (VCC), LSM6DS3.P$6 (3V3), MICROSD.VDD, NRF24L01P.P$1 (VCC), PC13.A, PWR.A, Q24.P$4 (VCC), R2.2, R5.2, R6.2, R7.2, R8.2, R9.2, R10.2, STM32F0401.13 (VDDA/VREF+), STM32F0401.19 (VDD_1), STM32F0401.32 (VDD_2), STM32F0401.48 (VDD_3), STM32F0401.64 (VDD_4)
5V: BME280.P$1 (VIN), BUZZER.P$1 (VIN), DC-DC_5V.P$7 (OUT+), DC-DC_5V.P$8 (OUT+), ESP32-CAM.P$1 (5V), JP3.1, U$5.VCC
BASS_BUZZER: R30.1, STM32F0401.29 (PB10)
CE_NRF: NRF24L01P.P$2 (CE), STM32F0401.9 (PC1)
CS_LIS: LIS3MDL.P$6 (CS), STM32F0401.56 (PB4)
CS_LSM: LSM6DS3.P$2 (CS), STM32F0401.55 (PB3)
CS_NRF: NRF24L01P.P$3 (CSN), STM32F0401.8 (PC0)
DBG_RX: JP1.1, STM32F0401.38 (PC7)
DBG_TX: JP1.2, STM32F0401.37 (PC6)
ESP_EN: R34.1, STM32F0401.33 (PB12)
GND: BME280.P$2 (GND), C1.1, C2.2, C3.1, C4.2, C5.2, C6.2, C7.1, C9.1, C10.1, C11.2, DC-DC-3V3.P$3 (IN-), DC-DC-3V3.P$4 (IN-), DC-DC-3V3.P$5 (OUT-), DC-DC-3V3.P$6 (OUT-), DC-DC_5V.P$3 (IN-), DC-DC_5V.P$4 (IN-), DC-DC_5V.P$5 (OUT-), DC-DC_5V.P$6 (OUT-), ESP-ON.1, JP1.5, JP2.2, LIS3MDL.P$2 (GND), LSM6DS3.P$5 (GND), MICROSD.VSS, NRF24L01P.P$8 (GND), Q24.P$2 (GND), R1.2, R3.1, R31.2, R32.1, R33.1, SI2301.2 (S), SI2301.1.2 (S), STM32F0401.12 (VSSA/VREF-), STM32F0401.18 (VSS_1), STM32F0401.31 (VSS_2), STM32F0401.47 (VSS_3), STM32F0401.63 (VSS_4), U$5.GND
GND_ESP: ESP32-CAM.P$2 (GND), ESP32-CAM.P$12 (GND), ESP32-CAM.P$16 (GND), ESP-ON.2, JP3.2, SI2301.1.3 (D)
GPS_RX: STM32F0401.43 (PA10), U$5.TX
GPS_TX: STM32F0401.42 (PA9), U$5.RX
IO0: ESP32-CAM.P$11 (IO0), JP3.6
IO2: ESP32-CAM.P$7 (IO2), JP3.3
KO: R32.2, STM32F0401.22 (PA6)
LED: R4.1, STM32F0401.2 (PC13)
MISO: LIS3MDL.P$5 (SA1(MISO)), LSM6DS3.P$1 (CAO), NRF24L01P.P$6 (MISO), STM32F0401.35 (PB14)
MOSI: LIS3MDL.P$4 (SDA(MOSI)), LSM6DS3.P$3 (SDA), NRF24L01P.P$5 (MOSI), STM32F0401.36 (PB15)
unnamed: R30.2, R31.1, SI2301.1 (G)
unnamed: R33.2, R34.2, SI2301.1.1 (G)
unnamed: BAT_PWR.C, R1.1
unnamed: JP2.1, S1.P$5 (O)
unnamed: C8.2, Q24.P$3 (OUTPUT)
unnamed: C11.1, STM32F0401.30 (VCAP_1)
unnamed: BUZZER.P$2 (GND), SI2301.3 (D)
unnamed: PWR.C, R3.2
unnamed: PC13.C, R4.2
NRF_IRQ: NRF24L01P.P$7 (IRQ), STM32F0401.11 (PC3)
NRST: C9.2, STM32F0401.7 (NRST)
SCK: LIS3MDL.P$3 (SCL(SCK)), LSM6DS3.P$4 (SCL), NRF24L01P.P$4 (SCK), STM32F0401.34 (PB13)
SCL: BME280.P$3 (SCL), STM32F0401.58 (PB6)
SDA: BME280.P$4 (SDA), STM32F0401.59 (PB7)
SDIO_CK: MICROSD.CLK, STM32F0401.53 (PC12)
SDIO_CMD: MICROSD.CMD, R8.1, STM32F0401.54 (PD2)
SDIO_DAT0: MICROSD.DAT0, R9.1, STM32F0401.39 (PC8)
SDIO_DAT1: MICROSD.DAT1, R10.1, STM32F0401.40 (PC9)
SDIO_DAT2: MICROSD.DAT2, R2.1, STM32F0401.51 (PC10)
SDIO_DAT3: MICROSD.DAT3, R7.1, STM32F0401.52 (PC11)
SVC: JP1.4, R6.1, STM32F0401.49 (PA14)
SVD: JP1.3, R5.1, STM32F0401.46 (PA13)
TCXO: C8.1, STM32F0401.5 (PH0-OSC_IN)
UOR: ESP32-CAM.P$14 (U0R), JP3.5
UOT: ESP32-CAM.P$15 (U0T), JP3.4
V_BAT: BAT_PWR.A, DC-DC-3V3.P$1 (IN+), DC-DC-3V3.P$2 (IN+), DC-DC_5V.P$1 (IN+), DC-DC_5V.P$2 (IN+), S1.P$3

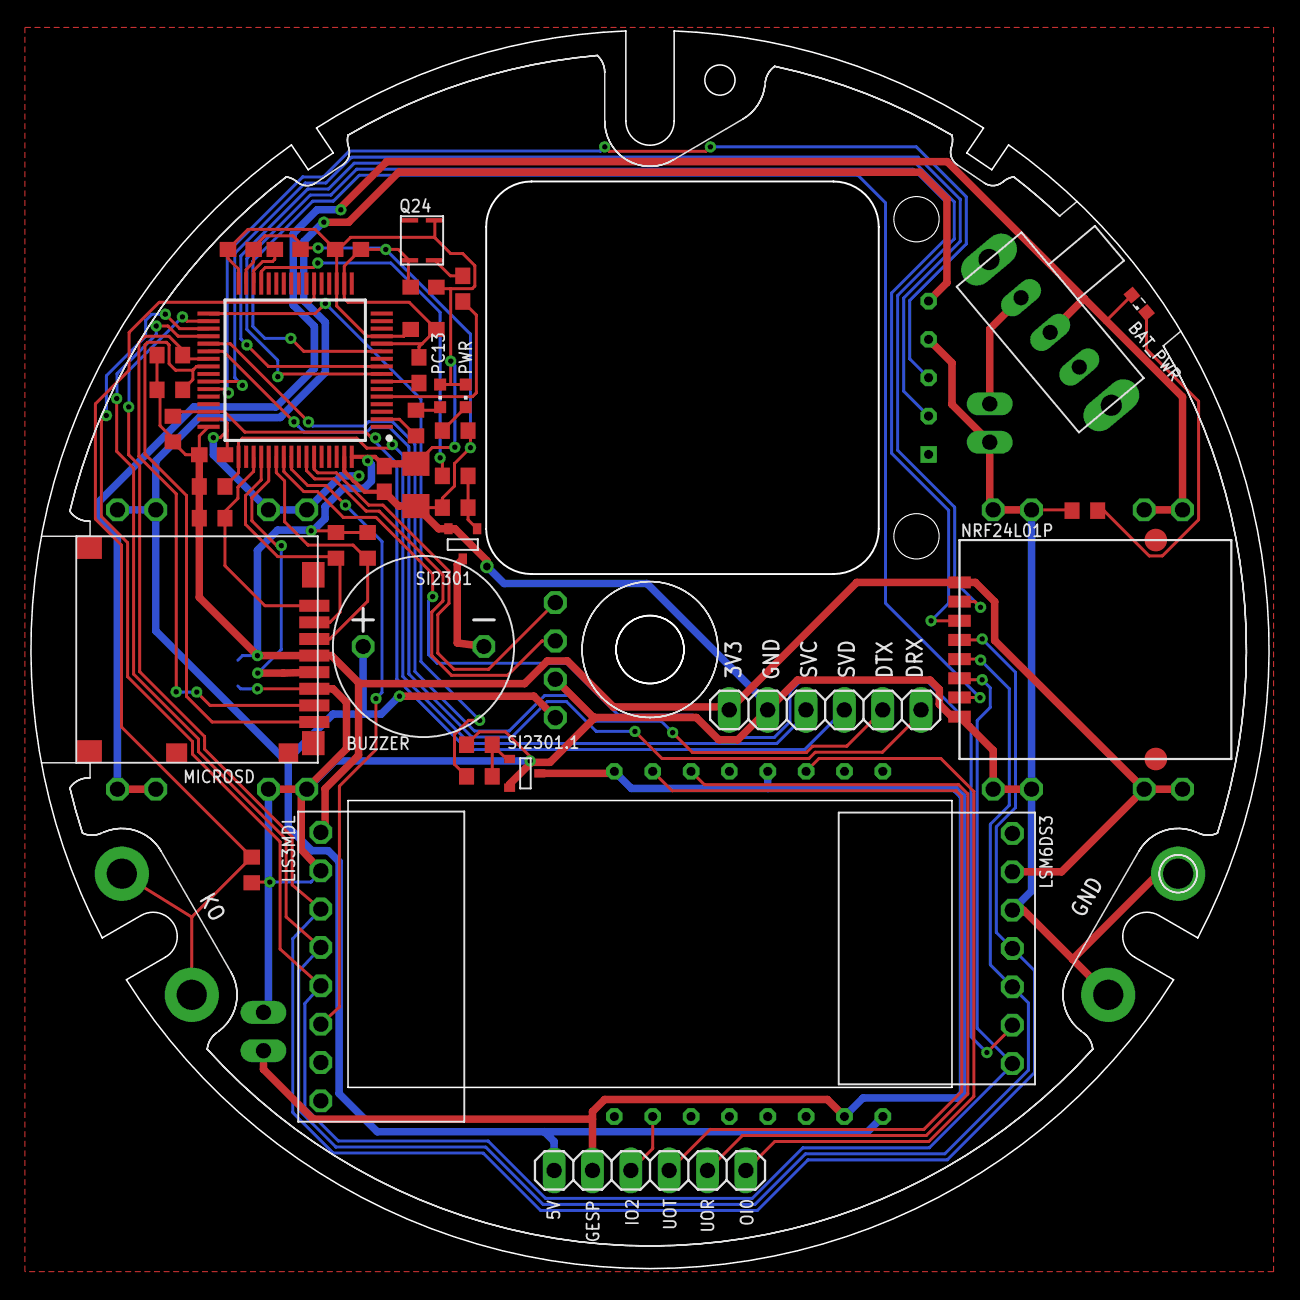
[picture p97: board DA.brd from above]

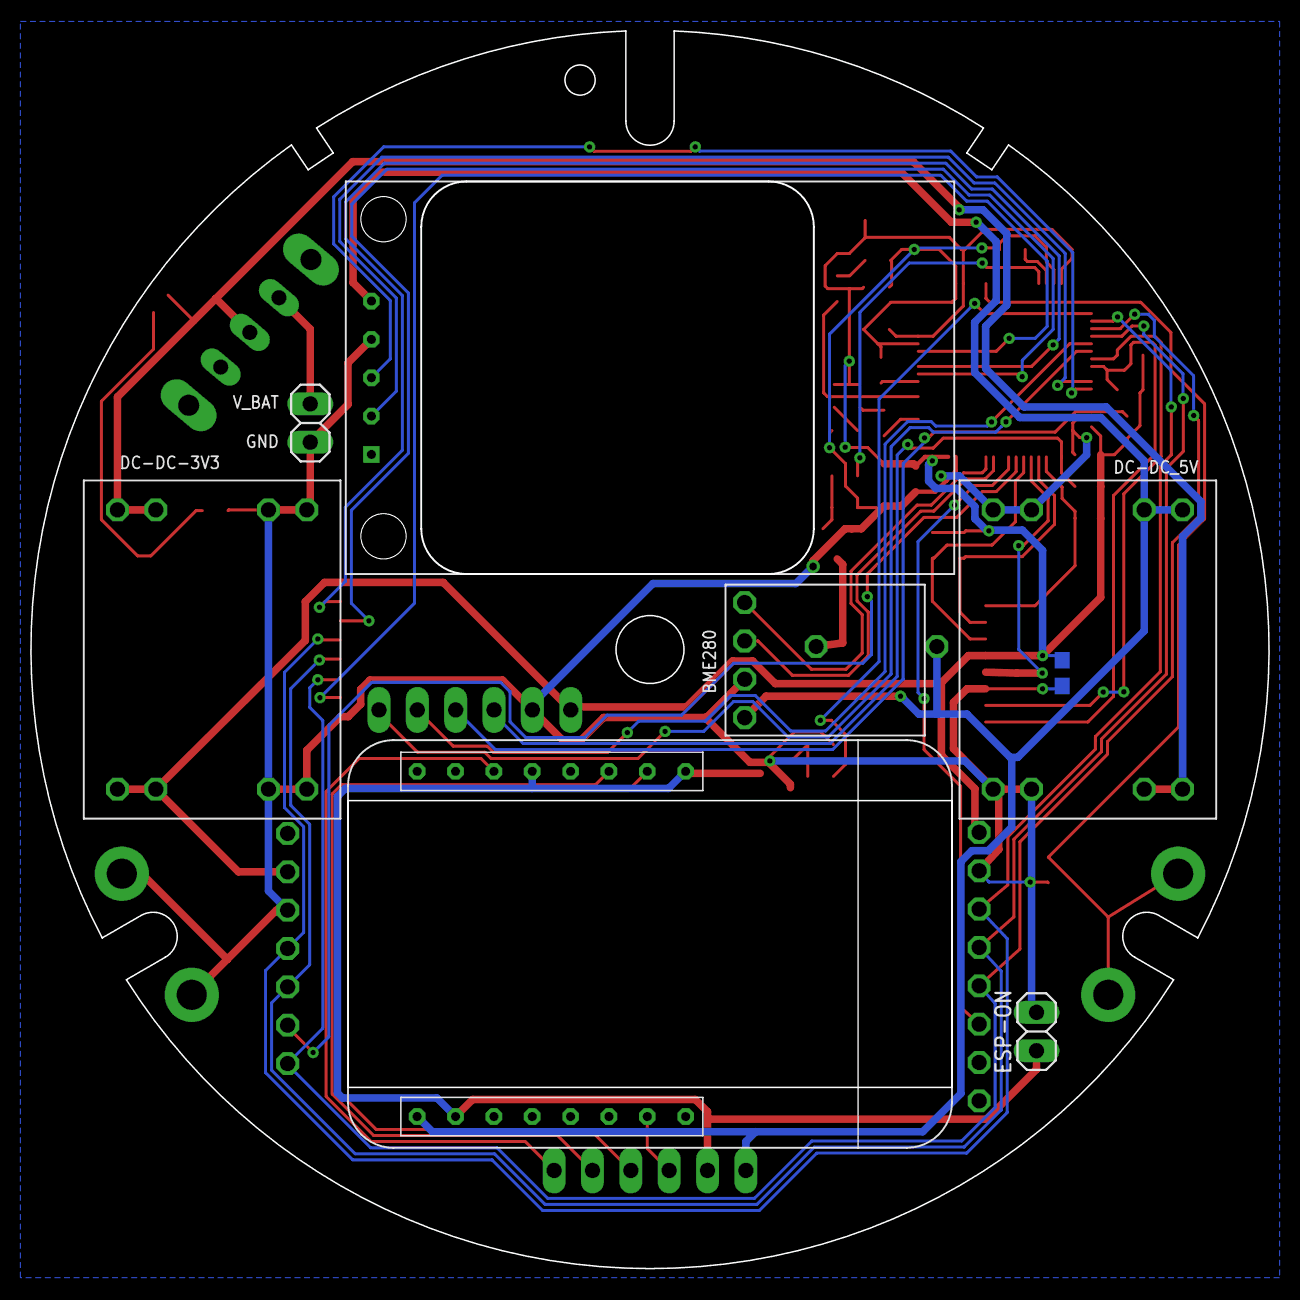
[picture p98: board DA.brd from below]

Board: 2 copper layers, 82.0 x 82.0 mm, 48 parts (7 on the bottom side), 46 nets.
