cansat-tsniimash/NeonBlade-2023/docs/Видеозачет/Печатные платы/optical_modul.brd

## EAGLE design docs/Видеозачет/Печатные платы/optical_modul.brd (2023-03-26)

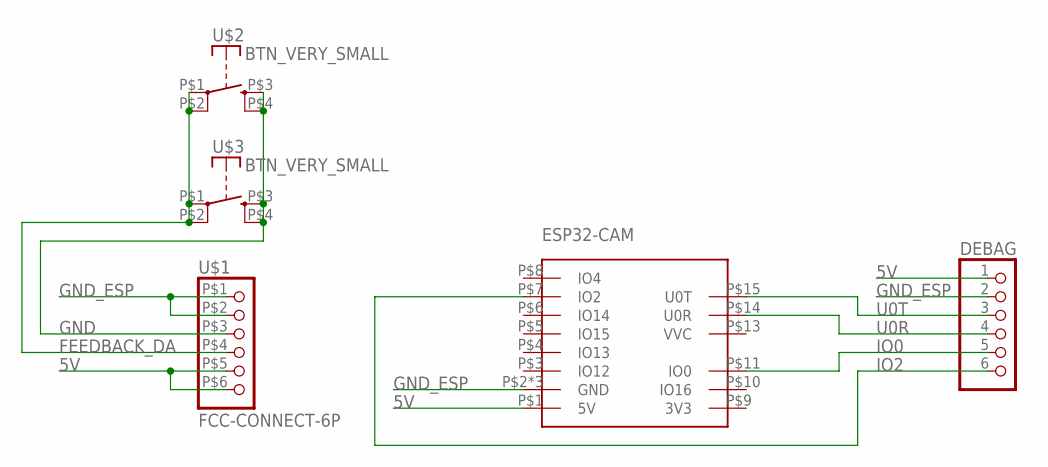
[picture p99: schematic optical_modul.sch]

Parts:
DEBAG: PINHD-1X6; 1X06
ESP32-CAM: ESP32-CAM
U$1: FCC-CONNECT-6P; FFC-CONNECT-6P-SMD
U$2, U$3: BTN_VERY_SMALL

Connections:
5V: DEBAG.1, ESP32-CAM.P$1 (5V), U$1.P$5 (5), U$1.P$6 (6)
FEEDBACK_DA: U$1.P$4 (4), U$2.P$1, U$2.P$2, U$3.P$1, U$3.P$2
GND: U$1.P$3 (3), U$2.P$3 (S), U$2.P$4 (S), U$3.P$3 (S), U$3.P$4 (S)
GND_ESP: DEBAG.2, ESP32-CAM.P$2 (GND), ESP32-CAM.P$12 (GND), ESP32-CAM.P$16 (GND), U$1.P$1 (1), U$1.P$2 (2)
IO0: DEBAG.5, ESP32-CAM.P$11 (IO0)
IO2: DEBAG.6, ESP32-CAM.P$7 (IO2)
U0R: DEBAG.4, ESP32-CAM.P$14 (U0R)
U0T: DEBAG.3, ESP32-CAM.P$15 (U0T)
