cansat-tsniimash/NeonBlade-2023/docs/Видеозачет/Печатные платы/optical_modul.brd

## EAGLE design docs/Видеозачет/Печатные платы/optical_modul.brd (continued)

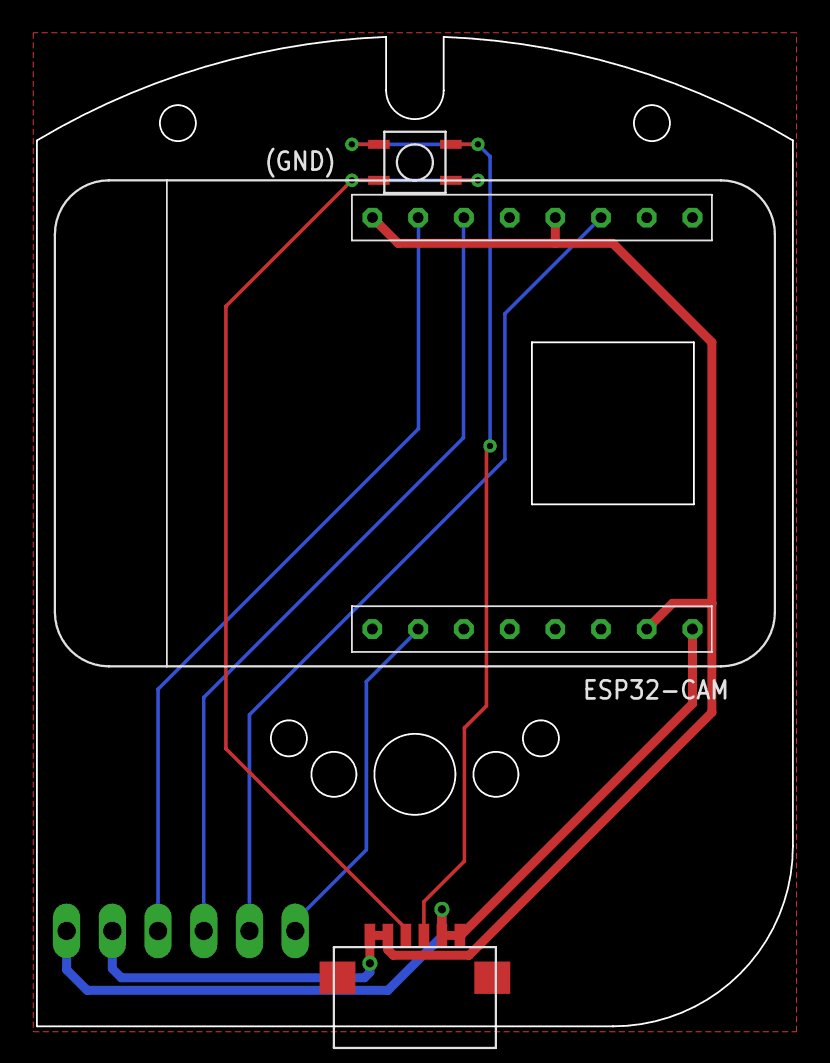
[picture p100: board optical_modul.brd from above]

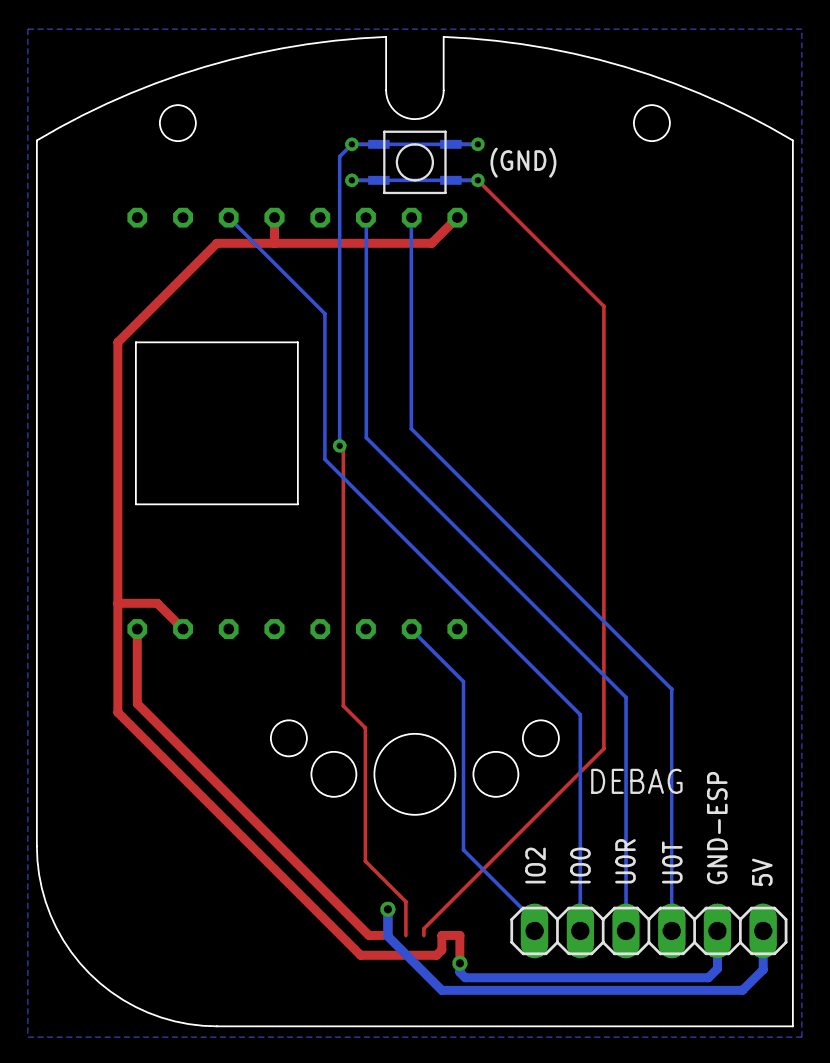
[picture p101: board optical_modul.brd from below]

Board: 2 copper layers, 42.0 x 55.0 mm, 5 parts (2 on the bottom side), 8 nets.
