cansat-tsniimash/NeonBlade-2023/docs/Видеозачет/Печатные платы/MA_interface-board.brd

## EAGLE design docs/Видеозачет/Печатные платы/MA_interface-board.brd (2023-03-26)

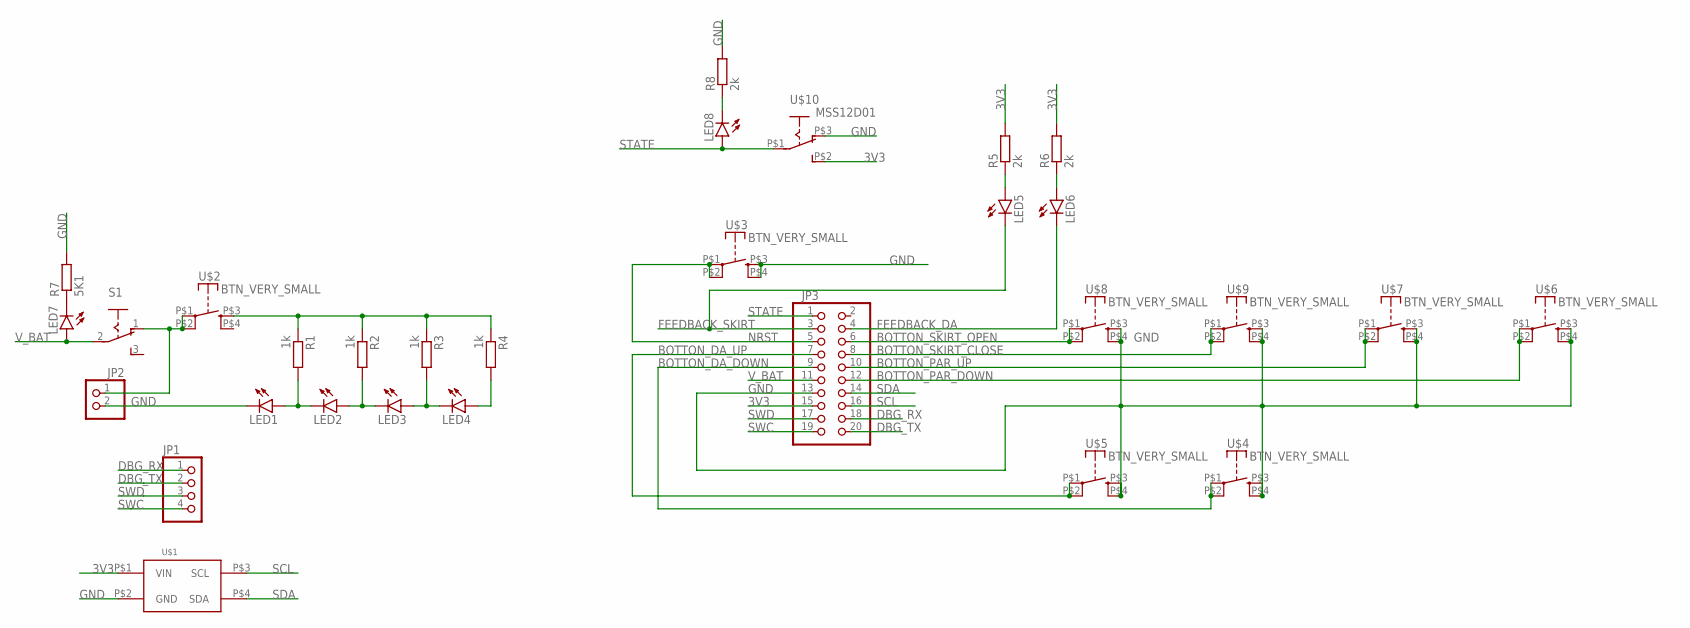
[picture p102: schematic MA_interface-board.sch]

Parts:
JP1: PINHD-1X4; 1X04
JP2: PINHD-1X2; 1X02
JP3: PINHD-2X10; 2X10
LED1, LED2, LED3, LED4, LED5, LED6, LED7, LED8: LEDSML0603; SML0603
R1, R2, R3, R4: 1k; R0603
R5, R6, R8: 2k; R0603
R7: 5K1; R0603
S1: UNICS-SWITCH
U$1: BME280BME280-PINS-ONLY; BME280-PINS-ONLY
U$2, U$3, U$4, U$5, U$6, U$7, U$8, U$9: BTN_VERY_SMALL
U$10: MSS12D01

Connections:
3V3: JP3.15, R5.2, R6.2, U$1.P$1 (VIN), U$10.P$2 (S)
BOTTON_DA_DOWN: JP3.9, U$4.P$1, U$4.P$2
BOTTON_DA_UP: JP3.7, U$5.P$1, U$5.P$2
BOTTON_PAR_DOWN: JP3.12, U$6.P$1, U$6.P$2
BOTTON_PAR_UP: JP3.10, U$7.P$1, U$7.P$2
BOTTON_SKIRT_CLOSE: JP3.8, U$9.P$1, U$9.P$2
BOTTON_SKIRT_OPEN: JP3.6, U$8.P$1, U$8.P$2
DBG_RX: JP1.1, JP3.18
DBG_TX: JP1.2, JP3.20
FEEDBACK_DA: JP3.4, LED6.C
FEEDBACK_SKIRT: JP3.3, LED5.C
GND: JP2.2, JP3.13, LED1.C, R7.2, R8.2, U$1.P$2 (GND), U$3.P$3 (S), U$3.P$4 (S), U$4.P$3 (S), U$4.P$4 (S), U$5.P$3 (S), U$5.P$4 (S), U$6.P$3 (S), U$6.P$4 (S), U$7.P$3 (S), U$7.P$4 (S), U$8.P$3 (S), U$8.P$4 (S), U$9.P$3 (S), U$9.P$4 (S), U$10.P$3 (O)
unnamed: LED1.A, LED2.C, R1.2
unnamed: LED2.A, LED3.C, R2.2
unnamed: LED3.A, LED4.C, R3.2
unnamed: LED4.A, R4.2
unnamed: LED7.C, R7.1
unnamed: JP2.1, S1.1 (O), U$2.P$1, U$2.P$2
unnamed: R1.1, R2.1, R3.1, R4.1, U$2.P$3 (S)
unnamed: LED5.A, R5.1
unnamed: LED6.A, R6.1
unnamed: LED8.C, R8.1
NRST: JP3.5, U$3.P$1, U$3.P$2
SCL: JP3.16, U$1.P$3 (SCL)
SDA: JP3.14, U$1.P$4 (SDA)
STATE: JP3.1, LED8.A, U$10.P$1
SWC: JP1.4, JP3.19
SWD: JP1.3, JP3.17
V_BAT: JP3.11, LED7.A, S1.2

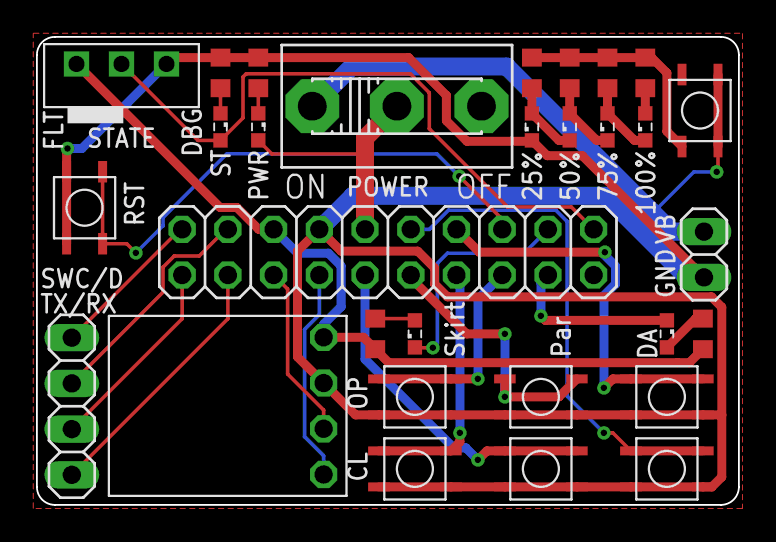
[picture p103: board MA_interface-board.brd from above]

Board: 2 copper layers, 39.0 x 26.0 mm, 30 parts (0 on the bottom side), 29 nets.
