cansat-tsniimash/NeonBlade-2023/schematics/board/Cansat-2023-2.brd

## EAGLE design schematics/board/Cansat-2023-2.brd (2023-05-17)

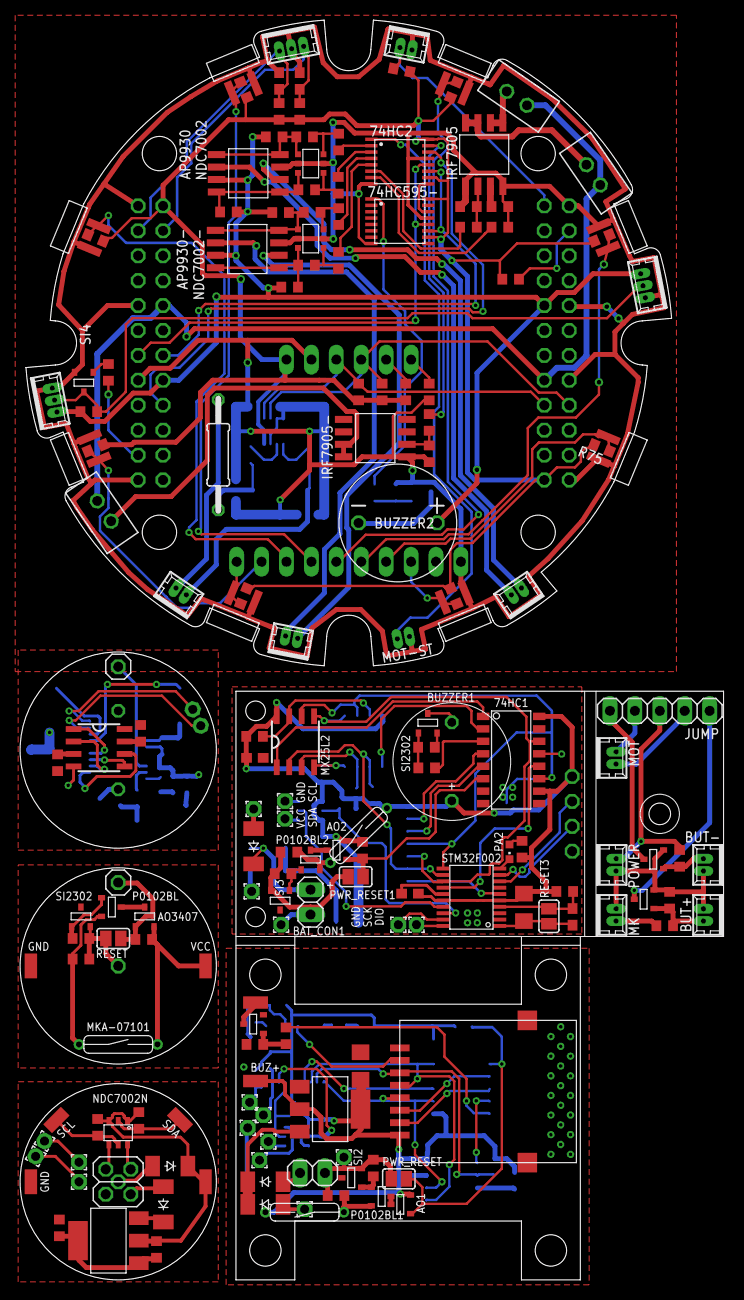
[picture p104: board Cansat-2023-2.brd from above]

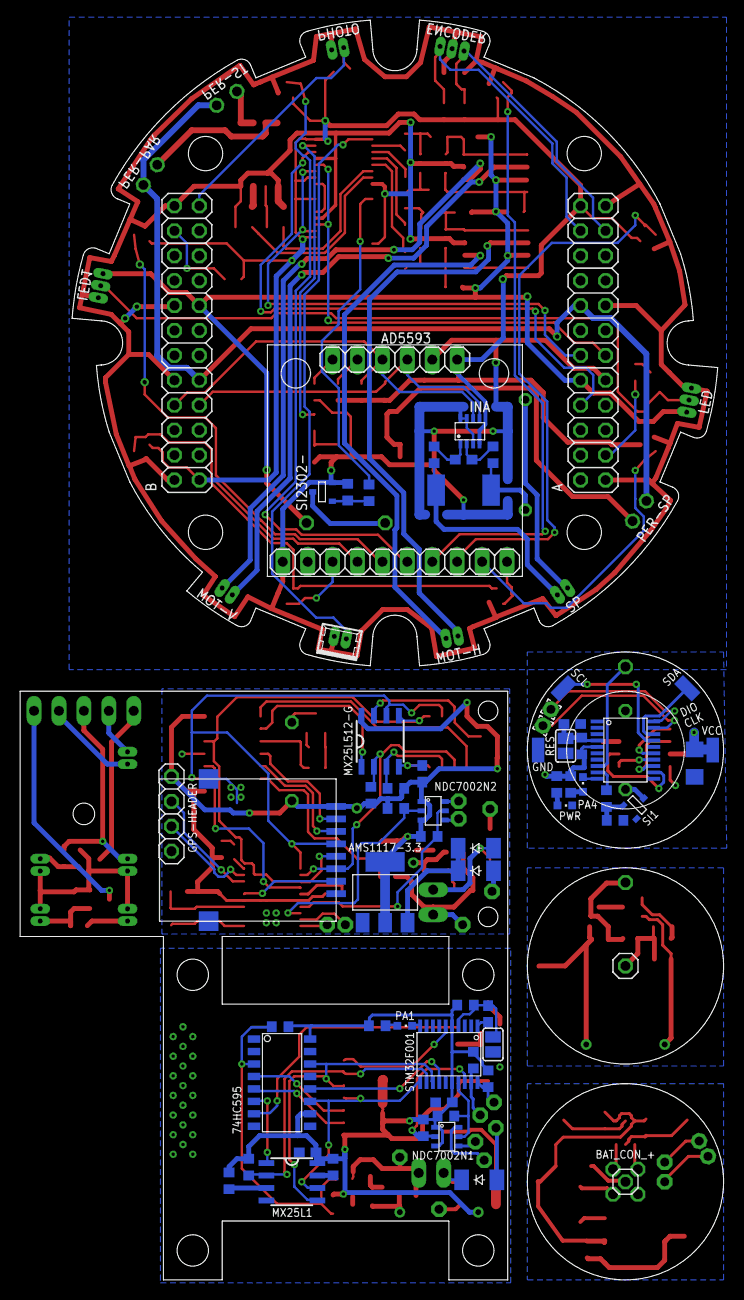
[picture p105: board Cansat-2023-2.brd from below]

Board: 2 copper layers, 71.7 x 128.4 mm, 233 parts (65 on the bottom side), 178 nets.

Parts:
74HC1, 74HC595: 74HC595SOIC16; SOIC16
74HC2, 74HC595-: 74HC595; TSSOP16
A: 2X12
AD5593: AD5593
AMS1117, AMS1117-3.3, AMS1117-ADJ: AMS1117; SOT223
AO1, AO2, AO3407: AO3407A; SOT23-3
AP9930, AP9930-: AP9930GM; SO8
B: 2X12
BAT_CON, BAT_CON1: 1X02
BAT_CON_-: 1X01
BUT+: 53047-02
BUT-: 53047-02
BUZ, BUZ1: SI2302CDS; SOT23-3
BUZ+: SMD1,27-2,54
BUZ-: SMD1,27-2,54
BUZZER, BUZZER1: BUZZER-5V; BUZZER
BUZZER2: BUZZERS8R6; BUZZER-S8R12
C1, C3, C8: 10µF; C1206
C2, C4, C5, C6, C7, C9, C10, C11, C12, C13, C14: 100nF; C0603
CHRG, CHRG1: 1,6/0,9
E01-ML01SP1, E01-ML01SP4: E01-ML01SP4
ENCODER: MOLEX-3-1.25; 53047-03
GND, GND1, GND2: SMD1,27-2,54
GND3, GND4: 1,6/0,9
GPS-HEADER: 1X04
INA: INA219AID; SOT23-8
IRF7905, IRF7905-: IRF7905; SO8
JP1: 2X02
JP2, JP3: 1X01
JUMP: 1X05
LED, LED1: MOLEX-3-1.25; 53047-03
MK: 53047-02
MOT: 53047-02
MOT-H: MOLEX-2-1.25; 53047-02
MOT-ST: MOLEX-2-1.25; 53047-02
MOT-V: MOLEX-2-1.25; 53047-02
MX25L1, MX25L2, MX25L512, MX25L512-G: MX25L25645; SOP8
NDC7002, NDC7002-: NDC7002N; SOT23-6
NDC7002N, NDC7002N1, NDC7002N2: NDC7002N; SOT-23-6
P0102BL, P0102BL1, P0102BL2: P0102BL; SOT23-3
PA1, PA2, PA4: CHIPLED_0603
PAD1, PAD2: 1,6/0,9
PER-PAR: JST-2-2.5
PER-SP: JST-2-2.5
PER-ST: JST-2-2.5
PHOTO: MOLEX-2-1.25; 53047-02
POWER: 53047-02
PWR: CHIPLED_0603
PWR-CTRL: 1X01
PWR_RESET, PWR_RESET1: SJ
R1, R8, R14, R16, R18, R30, R32, R43: 1k; R0603
R2: 1k4; R0603
R3, R4, R84: 4k7; R0603
R5: 10k x2; R0603
R6, R7, R35, R36, R37, R41, R44, R50, R52, R53, R54, R55, R59, R66, R67, R68, R70, R85: 10k; R0603
R9, R11, R12, R13, R15, R17, R19, R20, R21, R22, R23, R24, R25, R26, R27, R28, R29, R31, R33, R34, R38, R39, R40, R58, R61, R62, R63, R80, R81: 5k1; R0603
R10: 1k*2; R0603
R42: 10k*2; R0603
R45, R51, R56, R57, R60, R64, R65, R69, R83: 100R; R0603
R46, R47: 10R; R0603
R48: R01; R2512
R49: 10k*3; R0603
R71: 100R; 0207/15
R72, R73, R74, R75, R76, R77, R78, R79, R82: 2k; R0603
RESET, RESET1, RESET2, RESET3: SJ
SCL, SCL1: SMD1,27-2,54
SCL2, SCL3: 1,6/0,9
SDA, SDA1: SMD1,27-2,54
SDA2, SDA3: 1,6/0,9
SI1, SI2, SI3, SI4, SI2302, SI2302-: SI2302CDS; SOT23-3
SP: MOLEX-2-1.25; 53047-02
STM32F001, STM32F002, STM32F042: STM32F042F6P6; TSSOP-20
SW: 1,6/0,9
SWC, SWC1, SWC2: 1,6/0,9
SWD, SWD1, SWD2, SWD3: 1,6/0,9
U$1, U$2, U$4, U$5, U$6, U$8, U$9, U$10: MBR0530T1G; SOD-123_MINI-SMA
U$3, U$7: МКА-07101
U$11, U$21: SI2302CDS; SOT23-3
U$12, U$15, U$17, U$18, U$19, U$22, U$23, U$24: VT93N1
VCC, VCC1, VCC2: SMD1,27-2,54
VIN, VIN1: 1,6/0,9
МКА-07101: МКА-07101

Connections:
3V3: 74HC2.10, 74HC2.16, 74HC595-.10, 74HC595-.16, A.24, AD5593.16, B.1, INA.4, R61.2, R62.1, R63.1, R72.2, R73.2, R74.2, R75.2, R76.2, R77.2, R78.2, R79.2, R80.2, R81.2, R82.2, R85.2
5V: A.10, AP9930.7, AP9930-.7, B.15, BUZZER2.P$2, LED.1, LED1.1, R49.2, R50.2, R66.2, R67.2, R84.1
12V: JUMP.3, POWER.2, R41.2
BUZZER: R18.2, STM32F042.9
BUZZER1: 74HC595.7, R14.2
BUZZER2: 74HC1.3, R30.2
BUZZER3: 74HC595-.1, R45.1
CS: MX25L512.1, STM32F042.15
ENCOD_A: A.21, C14.2, ENCODER.1, R80.1
ENCOD_B: A.22, C13.2, ENCODER.3, R81.1
FOTO1: AD5593.3, R73.1, U$17.P$2
FOTO2: AD5593.4, R75.1, U$12.P$1
FOTO3: AD5593.5, R72.1, U$18.P$2
FOTO4: AD5593.6, R76.1, U$19.P$1
FOTO5: AD5593.7, R77.1, U$22.P$1
FOTO6: AD5593.8, R79.1, U$24.P$2
FOTO7: AD5593.9, R78.1, U$23.P$1
FOTO8: AD5593.10, R74.1, U$15.P$2
FOTO9: B.23, PHOTO.1, R82.1
GND: GND.1, JP1.2, R2.2
GND1: GND1.1, SI2302.3
GND2: C3.1, C4.1, GND2.1, MX25L512.4, PWR.C, R17.2, RESET1.1, SI1.2, STM32F042.1, STM32F042.16
GND3: 74HC595.8, 74HC595.13, AMS1117.P$2, BUZ.2, C1.1, C2.1, C5.1, C6.1, E01-ML01SP4.8, E01-ML01SP4.9, E01-ML01SP4.10, MX25L1.4, R13.2, RESET2.1, SI2.3, STM32F001.1, STM32F001.15
GND4: PA1.C, STM32F001.10
GND5: 74HC1.8, 74HC1.13, AMS1117-3.3.1, BUZ1.2, C7.1, C8.1, C9.1, C10.1, C11.1, E01-ML01SP1.8, E01-ML01SP1.9, E01-ML01SP1.10, GPS-HEADER.4, MX25L2.4, MX25L512-G.4, R29.2, RESET3.1, SI3.3, STM32F002.1, STM32F002.15
GND6: PA2.C, STM32F002.10
GND7: BUT+.1, BUT-.2, MK.2, POWER.1, R42.2, U$11.2, U$21.2
GND8: 74HC2.8, 74HC2.13, 74HC595-.8, 74HC595-.13, A.1, A.9, A.15, A.23, AD5593.1, AD5593.15, AP9930.3, AP9930-.3, B.2, B.10, B.16, B.24, C13.1, C14.1, ENCODER.2, INA.3, INA.7, INA.8, IRF7905.1, IRF7905.4, IRF7905-.1, LED.3, LED1.3, MOT-ST.2, NDC7002.2, NDC7002.5, NDC7002-.2, NDC7002-.5, PHOTO.2, R54.2, R55.2, R57.1, R58.2, R59.2, R70.2, SI4.2, SI2302-.2, U$12.P$2, U$15.P$1, U$17.P$1, U$18.P$1, U$19.P$2, U$22.P$2, U$23.P$2, U$24.P$1
HLD: MX25L2.7, MX25L512-G.7, R39.1
INA_SP+: R47.1, R48.2, R71.1
IRQ: E01-ML01SP4.7, STM32F001.6
IRQ1: E01-ML01SP1.7, STM32F002.6
LATCH: 74HC595.12, STM32F001.14
LATCH1: 74HC1.12, STM32F002.14
LATCH2: 74HC2.12, 74HC595-.12, A.11
LED: A.3, R83.1
MEM_CS: 74HC595.6, MX25L1.1
MEM_CS1: 74HC1.1, MX25L2.1
MEM_G_CS: 74HC1.2, MX25L512-G.1
MISO: MX25L512.2, STM32F042.13
MISO1: E01-ML01SP4.6, MX25L1.2, R26.1, STM32F001.12
MISO2: E01-ML01SP1.6, MX25L2.2, MX25L512-G.2, R38.1, STM32F002.12
MK_MOTOR1+: 74HC2.4, R69.2
MK_MOTOR1-: 74HC2.5, R51.2
MK_MOTOR2+: 74HC2.2, R64.2
MK_MOTOR2-: 74HC2.3, R65.2
MOSI: MX25L512.5, STM32F042.14
MOSI1: 74HC595.14, E01-ML01SP4.5, MX25L1.5, STM32F001.13
MOSI2: 74HC1.14, E01-ML01SP1.5, MX25L2.5, MX25L512-G.5, STM32F002.13
MOSI3: 74HC2.14, A.8
MOTOR1+: AP9930-.6, MOT-H.2
MOTOR1-: AP9930-.2, MOT-H.1
MOTOR2+: AP9930.6, MOT-V.2
MOTOR2-: AP9930.2, MOT-V.1
MOTOR3+: JUMP.4, MOT.2
MOTOR3+G: JUMP.5, U$21.3
MOTOR3-: JUMP.2, MOT.1
MOTOR3-G: JUMP.1, U$11.3
unnamed: JP1.1, U$1.A
unnamed: JP2.1, U$2.A
unnamed: AMS1117-ADJ.P$1, AMS1117-ADJ.P$2, R1.2, R2.1
unnamed: NDC7002N.5, R3.1, SCL.1
unnamed: PAD2.1, SWD.1
unnamed: NDC7002N.2, R4.1, SDA.1
unnamed: P0102BL.1, R5.1, SI2302.1
unnamed: P0102BL.2, R6.1, МКА-07101.1
unnamed: AO3407.3, P0102BL.3
unnamed: BAT_CON_-.1, R5.2, R6.2, RESET.2, SI2302.2
unnamed: AO3407.1, PWR-CTRL.1, R7.1, RESET.1
unnamed: PWR.A, R10.2
unnamed: R17.1, R18.1, SI1.1
unnamed: BUZZER.-, SI1.3
unnamed: PA4.A, R8.2
unnamed: PA4.C, STM32F042.10
unnamed: JP3.1, STM32F042.8
unnamed: MX25L512.3, R11.1
unnamed: MX25L512.7, R12.1
unnamed: STM32F042.20, SWC.1
unnamed: STM32F042.19, SWD1.1
unnamed: BUZ.1, R13.1, R14.1
unnamed: BUZ.3, BUZ-.1
unnamed: R27.1, STM32F001.20, SWC1.1
unnamed: PA1.A, R16.2
unnamed: P0102BL1.1, R21.1, SI2.1
unnamed: P0102BL1.2, R22.1, U$3.1
unnamed: AO1.3, P0102BL1.3
unnamed: BAT_CON.2, GND3.1, PWR_RESET.2, R21.2, R22.2, SI2.2
unnamed: MX25L1.7, R24.1
unnamed: MX25L1.3, R25.2
unnamed: BAT_CON.1, U$4.A, U$5.C
unnamed: U$6.A, VIN.1
unnamed: CHRG.1, U$5.A
unnamed: R28.1, STM32F001.19, SWD2.1
unnamed: NDC7002N1.6, SCL2.1
unnamed: BUZ1.1, R29.1, R30.1
unnamed: BUZ1.3, BUZZER1.-
unnamed: PA2.A, R32.2
unnamed: P0102BL2.1, R35.1, SI3.1
unnamed: P0102BL2.2, R36.1, U$7.1
unnamed: AO2.3, P0102BL2.3
unnamed: BAT_CON1.2, GND4.1, PWR_RESET1.2, R35.2, R36.2, SI3.2
unnamed: U$8.A, VIN1.1
unnamed: CHRG1.1, U$9.A
unnamed: BAT_CON1.1, U$9.C, U$10.A
unnamed: STM32F002.20, SWC2.1
unnamed: STM32F002.19, SWD3.1
unnamed: BUT-.1, R41.1, U$21.1
unnamed: BUT+.2, R42.1, R43.2, U$11.1
unnamed: BUZZER2.P$1, SI2302-.3
unnamed: R45.2, R70.1, SI2302-.1
unnamed: C12.1, INA.1, R46.2
unnamed: C12.2, INA.2, R47.2
unnamed: AP9930.1, AP9930.8, NDC7002.6, R49.1, R53.1
unnamed: NDC7002.3, R44.2, R64.1
unnamed: NDC7002.1, R53.2, R65.1
unnamed: AP9930.4, AP9930.5, NDC7002.4, R44.1, R50.1
unnamed: AP9930-.1, AP9930-.8, NDC7002-.6, R52.1, R66.1
unnamed: NDC7002-.3, R68.2, R69.1
unnamed: NDC7002-.1, R51.1, R52.2
unnamed: AP9930-.4, AP9930-.5, NDC7002-.4, R67.1, R68.1
unnamed: IRF7905.3, R54.1
unnamed: IRF7905.2, R55.1, R56.1
unnamed: IRF7905-.2, R59.1, R60.1
unnamed: AD5593.12, R61.1
unnamed: AD5593.11, R58.1
unnamed: R83.2, SI4.1
unnamed: LED.2, LED1.2, R84.2, SI4.3
unnamed: 74HC2.9, 74HC595-.14
PERE1: 74HC2.6, R56.2
PERE1_G: IRF7905.7, IRF7905.8, PER-PAR.1
PERE2: 74HC2.7, R57.2
PERE2_G: IRF7905.5, IRF7905.6, PER-ST.1
PERE3: 74HC2.15, R60.2
PERE3_G: IRF7905-.7, IRF7905-.8, PER-SP.1
PWR_CTRL: 74HC595.3, AO1.1, PWR_RESET.1, R23.1
PWR_CTRL1: 74HC1.6, AO2.1, PWR_RESET1.1, R37.1
RESET: C4.2, R9.2, RESET1.2, STM32F042.4
RESET1: C5.2, R15.2, RESET2.2, STM32F001.4
RESET2: C9.2, R31.2, RESET3.2, STM32F002.4
RF-CS: 74HC595.4, E01-ML01SP4.3
RF_CE: 74HC595.5, E01-ML01SP4.2
RF_CE1: 74HC1.4, E01-ML01SP1.2
RF_CS: 74HC1.5, E01-ML01SP1.3
RX: GPS-HEADER.3, STM32F002.9
SCK: MX25L512.6, STM32F042.12
SCK1: 74HC595.11, E01-ML01SP4.4, MX25L1.6, STM32F001.11
SCK2: 74HC1.11, E01-ML01SP1.4, MX25L2.6, MX25L512-G.6, STM32F002.11
SCK3: 74HC2.11, 74HC595-.11, A.12
SCL: JP1.3, NDC7002N.6
SCL1: SCL1.1, STM32F042.17
SCL2: AD5593.14, B.7, INA.5, R63.2
SCL-A: NDC7002N2.6, SCL3.1
SCL-B: NDC7002N1.5, R19.1, STM32F001.17
SCL-B1: NDC7002N2.5, R33.1, STM32F002.17
SDA: JP1.4, NDC7002N.4
SDA1: SDA1.1, STM32F042.18
SDA2: AD5593.13, B.8, INA.6, R62.2
SDA-A: NDC7002N1.4, SDA2.1
SDA-A1: NDC7002N2.4, SDA3.1
SDA-B: NDC7002N1.2, R20.1, STM32F001.18
SDA-B1: NDC7002N2.2, R34.1, STM32F002.18
SP+: R46.1, R48.1, SP.1
SP-: R71.2, SP.2
SWC: PAD1.1, SW.1
SWITCH: B.22, R85.1
TRUBKI: MK.1, R43.1
TRUBKI1: 74HC2.1, MOT-ST.1
TX: GPS-HEADER.2, STM32F002.8
VAB: A.16, B.9, PER-PAR.2, PER-SP.2, PER-ST.2
VCC: AMS1117-ADJ.P$3, NDC7002N.1, NDC7002N.3, R1.1, R3.2, R4.2, U$2.C, VCC.1
VCC1: AO3407.2, R7.2, VCC1.1, МКА-07101.2
VCC2: BUZZER.+, C3.2, MX25L512.8, R8.1, R9.1, R10.1, R11.2, R12.2, STM32F042.5, VCC2.1
VCC3: 74HC595.10, 74HC595.16, AMS1117.P$1, AMS1117.P$3, AO1.2, BUZ+.1, C1.2, C2.2, C6.2, E01-ML01SP4.1, MX25L1.8, NDC7002N1.1, NDC7002N1.3, R15.1, R16.1, R19.2, R20.2, R23.2, R24.2, R25.1, R26.2, R27.2, R28.2, STM32F001.5, STM32F001.16, U$3.2
VCC4: 74HC1.10, 74HC1.16, AMS1117-3.3.2, AMS1117-3.3.4, AO2.2, BUZZER1.+, C7.2, C8.2, C10.2, C11.2, E01-ML01SP1.1, GPS-HEADER.1, MX25L2.8, MX25L512-G.8, NDC7002N2.1, NDC7002N2.3, R31.1, R32.1, R33.2, R34.2, R37.2, R38.2, R39.2, R40.2, STM32F002.5, STM32F002.16, U$7.2
VCC/1: AMS1117.P$4, U$4.C, U$6.C
VCC/2: AMS1117-ADJ.P$4, U$1.C
VCC/3: AMS1117-3.3.3, U$8.C, U$10.C
WP: MX25L2.3, MX25L512-G.3, R40.1
