cansat-tsniimash/NeonBlade-2023/schematics/board/Cansat-2023-1.brd

## EAGLE design schematics/board/Cansat-2023-1.brd (2023-05-17)

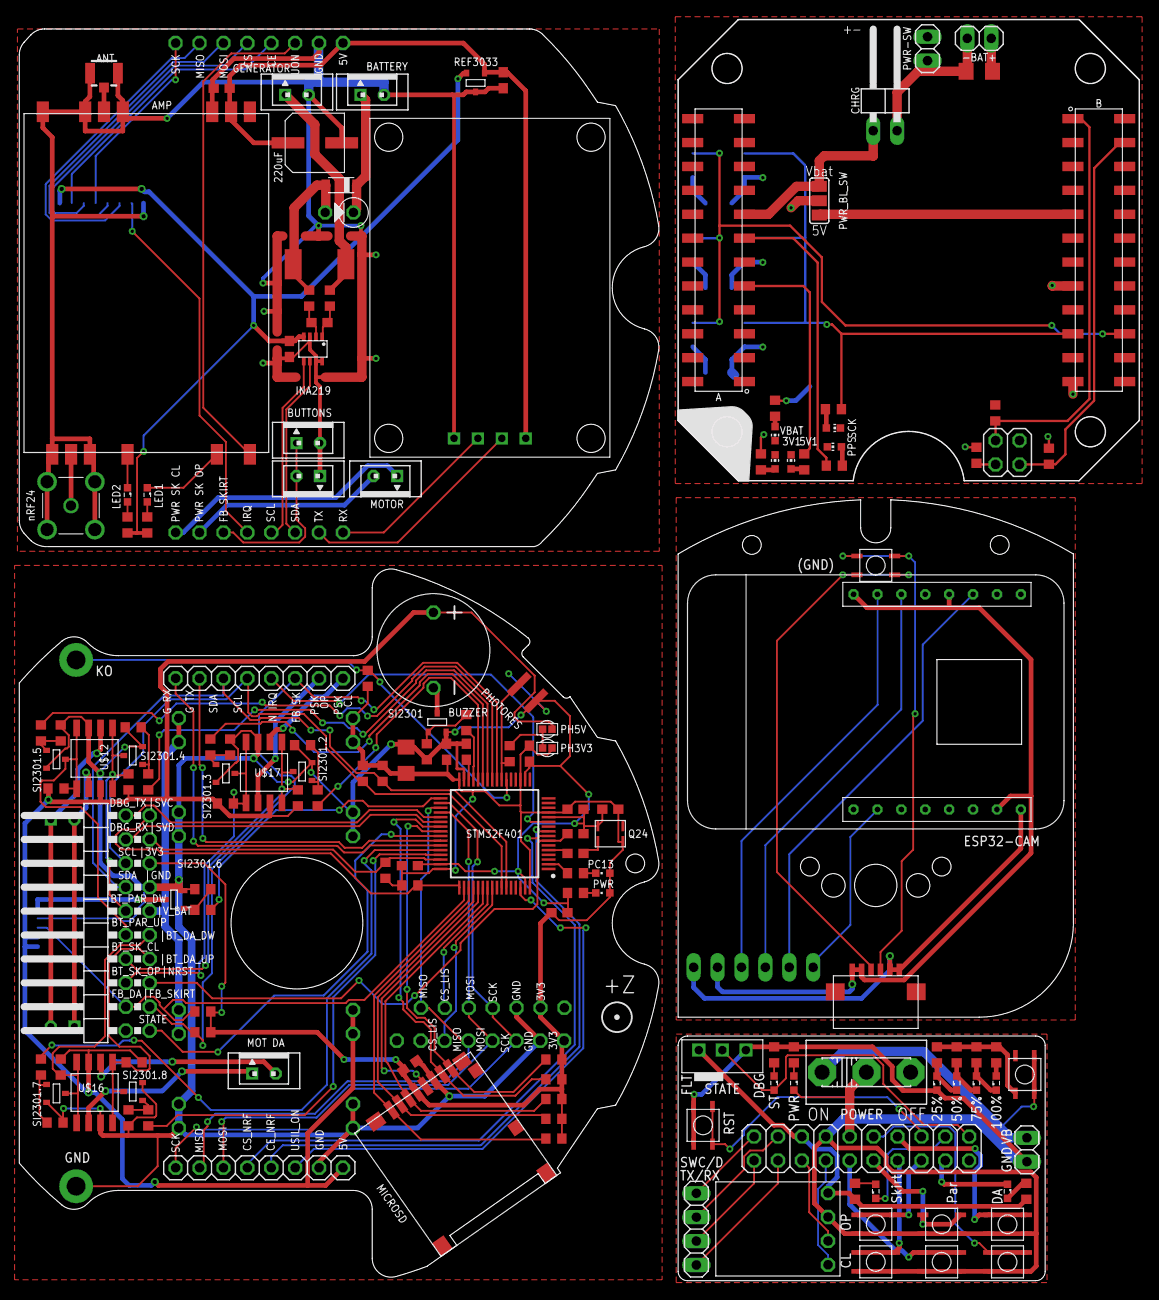
[picture p106: board Cansat-2023-1.brd from above]

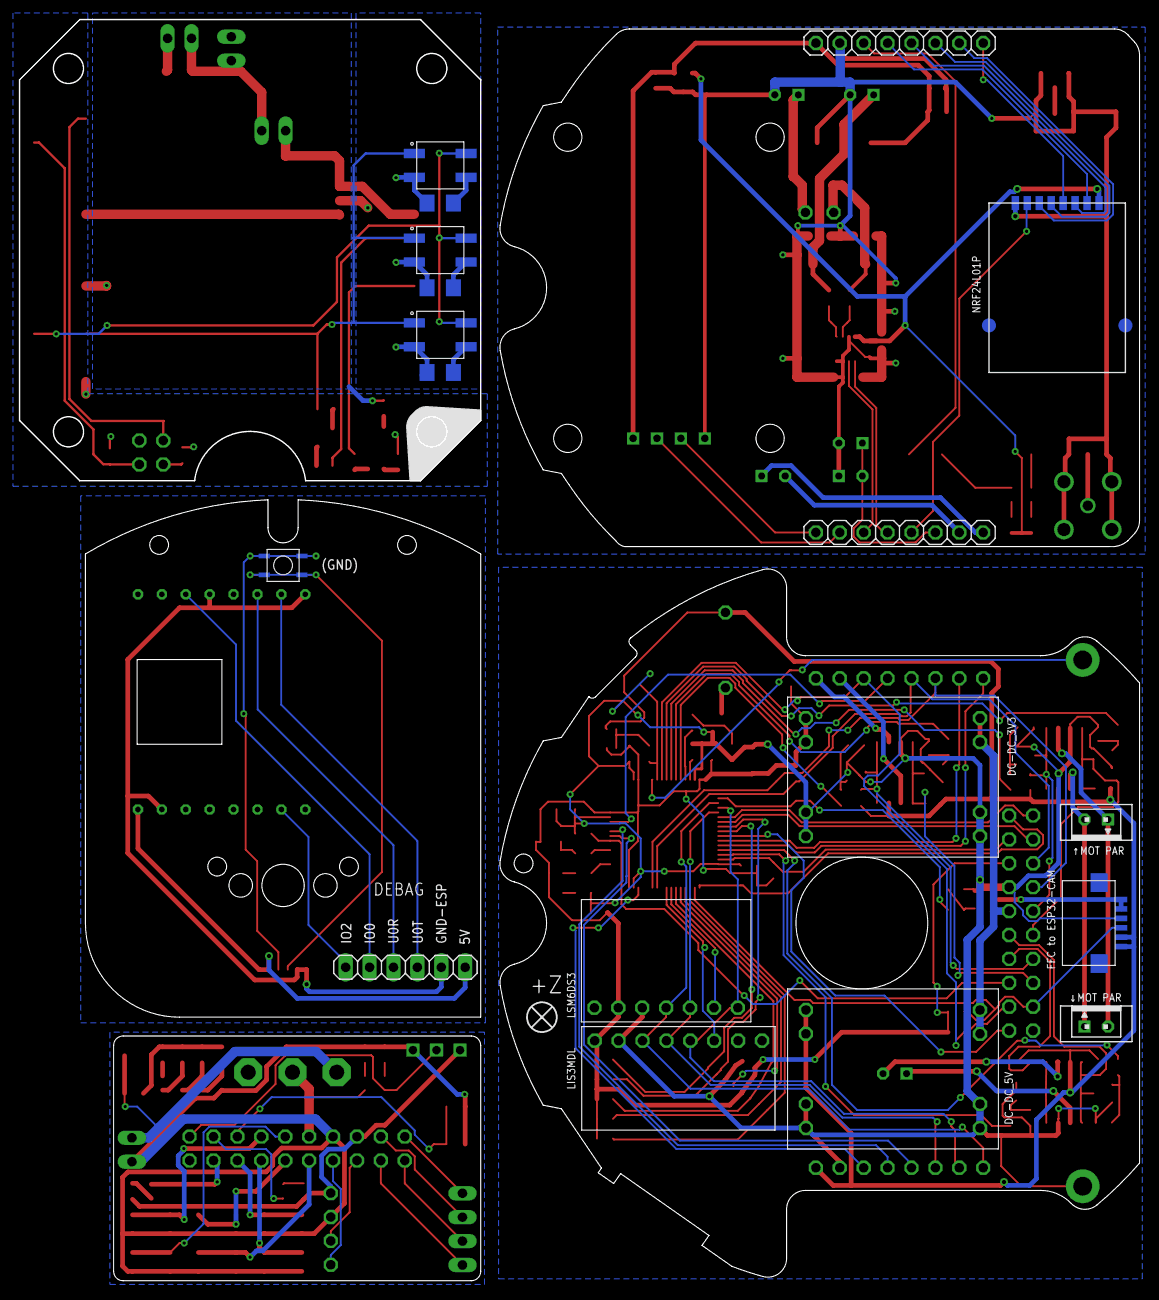
[picture p107: board Cansat-2023-1.brd from below]

Board: 2 copper layers, 119.0 x 134.0 mm, 169 parts (16 on the bottom side), 152 nets.

Parts:
1, 2, 3: 4-PIN; 4PINHEADERSMD
3V1, 5V1: CHIP-LED0603
3V3, 5V: VIAS-CONNECT
-BAT+: 1X02
A: 24-PIN; 24PINHEADERSMD
AMP: XQ-02A
B: 24-PIN; 24PINHEADERSMD
BATTERY: JST-2-K-S; B2B-PH-K-S
BUTTON-OP: JST-2-K-S; B2B-PH-K-S
BUTTONS: JST-2-K-S; B2B-PH-K-S
BUZZER: BUZZERS8R6; BUZZER-S8R12
C1, C3, C4, C5, C6, C7, C9, C12, C13, C14, C15: 100nF; C0603
C2: 10uF; C1206
C8: 1nF; C0603
C10: 10nF; C0603
C11: 4.7uf; C0603
C16: 220uF; ECAP220-CMD
C17, C18, C19, C20: 10µF; C1206
CHRG: 1X02/90
D1: D-MBR; SOD123
DC-DC_3V3, DC-DC_5V: MP1584-B
DEBAG: 1X06
DIP-4A: BA159
ESP32-CAM: ESP32-CAM
GENERATOR: JST-2-K-S; B2B-PH-K-S
INA219: INA219AID; SOT23-8
J1: MCX-J-P-H-ST-TH1; MCXJPHSTTH1
J2: U.FL-R-SMT-1_10_; U.FL-R-SMT-1(10)
JP1: 2X10/90
JP2, JP3, JP4: JST-2-K-S; B2B-PH-K-S
JP5: 1X04
JP6, JP7, JP11, JP12: 1X08
JP8: 1X02
JP9: 2X10
JP10: 2X02
LED1, LED2, LED3, LED4, LED5, LED6, LED7, LED8, LED9, LED10: SML0603
LIS3MDL: LIS3MDL-CJMCUБез_отв._зеркальный; LIS3MDL-CGMSU-NB2023
LSM6DS3: LSM6DS3-GY-NB2023
MICROSD: SD
MOTOR: JST-2-K-S; B2B-PH-K-S
NRF24L01P: NRF24L01_ML01SP4
PC13: CHIPLED_0603
PHOTORES: PHOTORES_VT93N1; PHOTORES_VT93N1_SMD
PPS: CHIP-LED0603
PWR: CHIPLED_0603
PWR-SW: 1X02
PWR_BL_SW: SJ_2
Q24: Q24
R1, R5, R6, R11, R12, R13, R14, R18, R19, R20, R21, R24, R25, R26, R27, R31, R33, R35: 10k; R0603
R2, R7, R8, R9, R10: 3k3; R0603
R3, R4, R40, R41, R47, R48, R50, R52, R54: 2k; R0603
R15, R16, R22, R23, R28, R29, R30, R34, R38, R39, R57: 100R; R0603
R17: 191k/2k; R0603
R32: 3k9; R0603
R36, R37: 4k7; R0603
R42: R05; R2512
R43, R44, R45, R46, R51, R53, R58: 1k; R0603
R49: 5K1; R0603
R55: R0603
R56: 5k1; R0603
REF3033: REF3033; SOT23-3
S1: UNICS-SWITCH
SCK: CHIP-LED0603
SI2301, SI2301.2, SI2301.3, SI2301.4, SI2301.5, SI2301.6, SI2301.7, SI2301.8: MOSFET-N; SOT23-3
STM32F401: STM32F401RCT6; QFP50P1200X1200X160-64N
U$1, U$8: FCC-CONNECT-6P; FFC-CONNECT-6P-SMD
U$2, U$3, U$6, U$7, U$9, U$10, U$11, U$13, U$14, U$15: BTN_VERY_SMALL
U$4: BME280BME280-PINS-ONLY; BME280-PINS-ONLY
U$5: GPS
U$12, U$16, U$17: MOSFET_2P+2N_AP9930GM; SO8
U$18: MSS12D01
VBAT: CHIP-LED0603

Connections:
3V1: C14.2, INA219.4, NRF24L01P.P$1, R40.2, R41.2, REF3033.2
3V2: JP9.15, R47.2, R48.2, U$4.P$1, U$18.P$2
3V3: 3V3.1, C1.2, C2.1, C3.2, C4.1, C5.1, C6.1, C7.2, C10.2, DC-DC_3V3.P$7, DC-DC_3V3.P$8, JP1.15, LIS3MDL.P$1, LSM6DS3.P$6, MICROSD.VDD, PC13.A, PWR.A, Q24.P$4, R1.2, R2.2, R5.2, R6.2, R7.2, R8.2, R9.2, R10.2, R32.1, R35.1, R36.2, R37.2, STM32F401.13, STM32F401.19, STM32F401.32, STM32F401.48, STM32F401.64
5V: 5V.2, BUZZER.P$1, DC-DC_5V.P$7, DC-DC_5V.P$8, JP6.8, R12.2, R13.2, R19.2, R20.2, R25.2, R26.2, U$8.P$5, U$8.P$6, U$12.7, U$16.7, U$17.7
5V1: AMP.P$5, C12.1, C15.2, C16.P$1, JP11.8, REF3033.1, U$5.UCC
5V2: DEBAG.1, ESP32-CAM.P$1, U$1.P$5, U$1.P$6
+3V3: A.23, B.23, R53.2, R55.2, R57.2
+5V: A.9, B.9, PWR_BL_SW.1, R52.2
BASS_BUZZER: R30.1, STM32F401.29
BOTTON_DA_DOWN: JP1.9, R13.1, SI2301.7.3, U$16.1, U$16.8
BOTTON_DA_DOWN1: JP9.9, U$9.P$1, U$9.P$2
BOTTON_DA_UP: JP1.7, R12.1, SI2301.8.3, U$16.4, U$16.5
BOTTON_DA_UP1: JP9.7, U$10.P$1, U$10.P$2
BOTTON_PAR_DOWN: JP1.12, R20.1, SI2301.4.3, U$12.1, U$12.8
BOTTON_PAR_DOWN1: JP9.12, U$11.P$1, U$11.P$2
BOTTON_PAR_UP: JP1.10, R19.1, SI2301.5.3, U$12.4, U$12.5
BOTTON_PAR_UP1: JP9.10, U$13.P$1, U$13.P$2
BOTTON_SKIRT_CLOSE: JP1.8, R26.1, SI2301.2.3, U$17.1, U$17.8
BOTTON_SKIRT_CLOSE1: JP9.8, U$15.P$1, U$15.P$2
BOTTON_SKIRT_OPEN: JP1.6, R25.1, SI2301.3.3, U$17.4, U$17.5
BOTTON_SKIRT_OPEN1: JP9.6, U$14.P$1, U$14.P$2
CE_NRF: JP6.5, STM32F401.9
CE_NRF1: JP11.5, NRF24L01P.P$2
CS_LIS: LIS3MDL.P$6, STM32F401.56
CS_LSM: LSM6DS3.P$2, STM32F401.55
CS_NRF: JP6.4, STM32F401.8
CS_NRF1: JP11.4, NRF24L01P.P$3
DBG_RX: JP1.18, STM32F401.38
DBG_RX1: JP5.1, JP9.18
DBG_TX: JP1.20, STM32F401.37
DBG_TX1: JP5.2, JP9.20
ESP_EN: R34.1, STM32F401.33
FEEDBACK_DA: JP1.4, R35.2, STM32F401.50, U$8.P$4
FEEDBACK_DA1: U$1.P$4, U$2.P$1, U$2.P$2, U$3.P$1, U$3.P$2
FEEDBACK_DA2: JP9.4, LED8.C
FEEDBACK_SKIRT: JP1.3, JP7.6, R1.1, STM32F401.24
FEEDBACK_SKIRT1: BUTTON-OP.2, BUTTONS.1, JP12.6
FEEDBACK_SKIRT2: JP9.3, LED7.C
GND: C1.1, C2.2, C3.1, C4.2, C5.2, C6.2, C7.1, C9.1, C10.1, C11.2, DC-DC_3V3.P$3, DC-DC_3V3.P$4, DC-DC_3V3.P$5, DC-DC_3V3.P$6, DC-DC_5V.P$3, DC-DC_5V.P$4, DC-DC_5V.P$5, DC-DC_5V.P$6, JP1.13, JP6.7, LIS3MDL.P$2, LSM6DS3.P$5, MICROSD.VSS, PHOTORES.P$1, Q24.P$2, R3.1, R11.1, R14.1, R18.1, R21.1, R24.1, R27.1, R31.2, R33.1, SI2301.2, SI2301.2.2, SI2301.3.2, SI2301.4.2, SI2301.5.2, SI2301.6.2, SI2301.7.2, SI2301.8.2, STM32F401.12, STM32F401.18, STM32F401.31, STM32F401.47, STM32F401.63, U$8.P$3, U$12.3, U$16.3, U$17.3
GND1: AMP.P$1, AMP.P$2, AMP.P$4, AMP.P$10, AMP.P$12, AMP.P$13, BATTERY.2, BUTTON-OP.1, BUTTONS.2, C12.2, C14.1, C15.1, C16.P$2, GENERATOR.2, INA219.3, INA219.7, INA219.8, J1.2, J1.3, J1.4, J1.5, J2.1, J2.2, JP11.7, NRF24L01P.P$8, REF3033.3, U$5.GND
GND2: U$1.P$3, U$2.P$3, U$2.P$4, U$3.P$3, U$3.P$4
GND3: JP8.2, JP9.13, LED3.C, R49.2, R50.2, U$4.P$2, U$7.P$3, U$7.P$4, U$9.P$3, U$9.P$4, U$10.P$3, U$10.P$4, U$11.P$3, U$11.P$4, U$13.P$3, U$13.P$4, U$14.P$3, U$14.P$4, U$15.P$3, U$15.P$4, U$18.P$3
GND4: 1.3, 2.3, 3.3, 3V1.C, 5V1.C, A.2, A.10, A.16, A.24, B.2, B.10, B.16, B.24, C18.1, C19.1, C20.1, JP10.1, PPS.C, PWR-SW.1, R56.1, SCK.C, VBAT.C
GND_ESP: SI2301.6.3, U$8.P$1, U$8.P$2
GND_ESP1: DEBAG.2, ESP32-CAM.P$2, ESP32-CAM.P$12, ESP32-CAM.P$16, U$1.P$1, U$1.P$2
GPS_RX: JP7.1, STM32F401.43
GPS_RX1: JP12.1, U$5.TX
GPS_TX: JP7.2, STM32F401.42
GPS_TX1: JP12.2, U$5.RX
IO0: DEBAG.5, ESP32-CAM.P$11
IO2: DEBAG.6, ESP32-CAM.P$7
KO: R32.2, STM32F401.22
LED: R4.1, STM32F401.2
LED1: AMP.P$8, LED1.C
LED2: AMP.P$9, LED2.C
MISO: JP6.2, LIS3MDL.P$5, LSM6DS3.P$1, STM32F401.35
MISO1: JP11.2, NRF24L01P.P$6
MOSI: JP6.3, LIS3MDL.P$4, LSM6DS3.P$3, STM32F401.36
MOSI1: JP11.3, NRF24L01P.P$5
MOTOR_DA_DOWN: R15.1, STM32F401.44
MOTOR_DA_UP: R16.2, STM32F401.45
MOTOR_PAR_DOWN: R22.1, STM32F401.26
MOTOR_PAR_UP: R23.2, STM32F401.25
MOTOR_SKIRT_CLOSE: R28.1, STM32F401.28
MOTOR_SKIRT_OPEN: R29.2, STM32F401.27
unnamed: R30.2, R31.1, SI2301.1
unnamed: R11.2, R15.2, SI2301.7.1
unnamed: R18.2, R22.2, SI2301.4.1
unnamed: R33.2, R34.2, SI2301.6.1
unnamed: JP3.1, JP4.2, U$12.2
unnamed: JP2.1, U$16.2
unnamed: JP2.2, U$16.6
unnamed: R14.2, R16.1, SI2301.8.1
unnamed: JP3.2, JP4.1, U$12.6
unnamed: C8.2, Q24.P$3
unnamed: R21.2, R23.1, SI2301.5.1
unnamed: C11.1, STM32F401.30
unnamed: 3V3.2, 5V.1, R17.1
unnamed: R24.2, R28.2, SI2301.2.1
unnamed: C13.1, INA219.1, R38.2
unnamed: C13.2, INA219.2, R39.2
unnamed: R27.2, R29.1, SI2301.3.1
unnamed: BATTERY.1, D1.C, DIP-4A.P$2
unnamed: GENERATOR.1, R38.1, R42.1
unnamed: BUZZER.P$2, SI2301.3
unnamed: AMP.P$3, J2.3
unnamed: AMP.P$11, J1.1
unnamed: LED1.A, R40.1
unnamed: LED2.A, R41.1
unnamed: D1.A, DIP-4A.P$1, R39.1, R42.2
unnamed: LED3.A, LED4.C, R43.2
unnamed: LED4.A, LED5.C, R44.2
unnamed: LED5.A, LED6.C, R45.2
unnamed: LED6.A, R46.2
unnamed: JP8.1, S1.1, U$6.P$1, U$6.P$2
unnamed: LED7.A, R47.1
unnamed: LED8.A, R48.1
unnamed: LED9.C, R49.1
unnamed: LED10.C, R50.1
unnamed: R43.1, R44.1, R45.1, R46.1, U$6.P$3
unnamed: PWR.C, R3.2
unnamed: PC13.C, R4.2
unnamed: R51.1, SCK.A
unnamed: 5V1.A, R52.1
unnamed: 3V1.A, R53.1
unnamed: PPS.A, R54.1
unnamed: -BAT+.2, C17.1, CHRG.2, PWR-SW.2
unnamed: JP10.4, R57.1
unnamed: R58.1, VBAT.A
NRF_IRQ: JP7.5, STM32F401.11
NRF_IRQ1: JP12.5, NRF24L01P.P$7
NRST: C9.2, JP1.5, STM32F401.7
NRST1: JP9.5, U$7.P$1, U$7.P$2
PHOT: B.4, JP10.2, R55.1
PHOTORES: PHOTORES.P$2, R17.2, STM32F401.23
POWER_SKIRT_CLOSE: JP7.8, U$17.2
POWER_SKIRT_CLOSE1: JP12.8, MOTOR.1
POWER_SKIRT_OPEN: JP7.7, U$17.6
POWER_SKIRT_OPEN1: JP12.7, MOTOR.2
PPS: A.13, R54.2
SCK: JP6.1, LIS3MDL.P$3, LSM6DS3.P$4, STM32F401.34
SCK1: JP11.1, NRF24L01P.P$4
SCL: JP1.16, JP7.4, R37.1, STM32F401.58
SCL1: INA219.5, JP12.4
SCL2: JP9.16, U$4.P$3
SCL3: 1.1, 2.1, 3.1, B.19, R51.2
SDA: JP1.14, JP7.3, R36.1, STM32F401.59
SDA1: INA219.6, JP12.3
SDA2: JP9.14, U$4.P$4
SDA3: 1.2, 2.2, 3.2, B.20
SDIO_CK: MICROSD.CLK, STM32F401.53
SDIO_CMD: MICROSD.CMD, R8.1, STM32F401.54
SDIO_DAT0: MICROSD.DAT0, R9.1, STM32F401.39
SDIO_DAT1: MICROSD.DAT1, R10.1, STM32F401.40
SDIO_DAT2: MICROSD.DAT2, R2.1, STM32F401.51
SDIO_DAT3: MICROSD.DAT3, R7.1, STM32F401.52
ST-SW: B.1, JP10.3, R56.2
STATE: JP1.1, STM32F401.41
STATE1: JP9.1, LED10.A, U$18.P$1
SVC: JP1.19, R6.1, STM32F401.49
SVD: JP1.17, R5.1, STM32F401.46
SWC: JP5.4, JP9.19
SWD: JP5.3, JP9.17
TCXO: C8.1, STM32F401.5
U0R: DEBAG.4, ESP32-CAM.P$14
U0T: DEBAG.3, ESP32-CAM.P$15
USIL_ON: JP6.6, STM32F401.62
USIL_ON1: AMP.P$7, JP11.6
V+: -BAT+.1, A.15, B.15, C17.2, CHRG.1, PWR_BL_SW.3, R58.2
VCC: 1.4, 2.4, 3.4, C18.2, C19.2, C20.2, PWR_BL_SW.2
V_BAT: DC-DC_3V3.P$1, DC-DC_3V3.P$2, DC-DC_5V.P$1, DC-DC_5V.P$2, JP1.11
V_BAT1: JP9.11, LED9.A, S1.2
