cansat-tsniimash/NeonBlade-2023/src/board/bme_proj/bme_proj.ioc

Mcu.UserName=STM32F411CEUx
PA10.Signal=USART1_RX
PA13.Signal=SYS_JTMS-SWDIO
PA14.Signal=SYS_JTCK-SWCLK
PA7.Signal=ADCx_IN7
PA9.Signal=USART1_TX
PB10.Signal=SPI2_SCK
PB14.Signal=SPI2_MISO
PB15.Signal=SPI2_MOSI
PB6.Signal=I2C1_SCL
PB7.GPIO_Label=I2C1_SDA
PB7.Signal=I2C1_SDA
PB8.GPIO_Label=CS_NRF
PB8.Signal=GPIO_Output
PB9.GPIO_Label=CE_NRF
PB9.Signal=GPIO_Output
PC13-ANTI_TAMP.GPIO_Label=LED
PC13-ANTI_TAMP.Signal=GPIO_Output
PC14-OSC32_IN.GPIO_Label=LIS_CS
PC14-OSC32_IN.Signal=GPIO_Output
PC15-OSC32_OUT.GPIO_Label=LSM_CS
PC15-OSC32_OUT.Signal=GPIO_Output
