cansat-tsniimash/NeonBlade-2023/(commit log)

2022-10-15 Начало проекта!
2022-10-15 Закинул скрипт для моделей Creo
2022-10-15 продвинул компоновку ДА
2022-11-26 Собрал классный аппарат, назначил его массу
    [babara_babina.prt, bass_buzzer.prt, bme280_module.prt, bottom_2floar.prt, button.prt, camera-sq11.prt, connector-ffc_686115148922.prt, connector-pbd-20r.prt]
2022-11-26 Я сделал классный дочерний аппарат
    [battery_li-pol_lp601730.prt, cup_bottom_doch.prt, cup_up_doch.prt, dc_dc.prt, gpstwo.prt, ic_mc_stm32f405rgt6.prt, platada.prt, switch_sk12f14.prt]
2022-11-26 Добавили классные поддержки, увеличили отверстия под гайки
2022-11-29 Назначил массу дочернему аппарату. Общая массса зонда составила 560 грамм
    [battery_li-pol_lp601730.prt, cup_bottom_doch.prt, cup_up_doch.prt, dc_dc.prt, gpstwo.prt, gy-lsm6ds3_lsm6ds3.prt, ic_mc_stm32f405rgt6.prt, lil_uzi_otvet.prt]
2022-11-29 В догонку
    [battery_li-pol_lp402030.prt]
2022-12-03 Вернули в модель дочерние аппараты
    [lm_korpus.prt]
2022-12-21 переработаная бабара-бабина
    [babara_babina.prt]
2022-12-21 сделали анимацию для юбок
    [_.prt, ember_skirt.prt, generator.prt, lil_uzi_otvet.prt]
2022-12-23 видосик с отделением ДА
2022-12-23 Добавил шкив
    [krug_michail.prt, shkiv.prt]
2023-01-27 сделали 5д модельки для печати
    [cup_bottom_doch.prt, cup_bottom_doch.stl, cup_om.prt, cup_om.stl, krug_michail.prt, krug_michail.stl, lm_korpus.prt, lm_korpus.stl]
2023-01-28 Доработка проектной модели для зимней сессии
    [_.prt, connector-pls-4.prt, liluziverx.prt, nrf24l01_pa_lna_e01_ml01sp4.prt, rocket.prt]
2023-01-28 делаем отверстия под парашют дочек
    [cup_up_doch.prt]
2023-01-28 Добавили документы на зимнюю сессию
2023-02-08 Создан габаритный чертеж
2023-02-08 Добавлены направляющие для крышки паращютного отсека
    [cup_bottom_doch.prt, cup_om.prt, cup_up_doch.prt, krug_michail.prt, lm_korpus.prt, mm_korpus.prt, platada.prt]
2023-02-08 я сделял платы
    [plata_doch.dxf, plata_interface.dxf, plata_low_module_first.dxf, plata_low_module_second.dxf, plata_optical_module.dxf]
2023-02-10 Добавил библиотеки для разработки печатных плат
2023-02-13 Перенес DXF файлы в соответствующую папку
    [plata_doch.dxf, plata_interface.dxf, plata_low_module_first.dxf, plata_low_module_second.dxf, plata_optical_module.dxf]
2023-02-13 Проверил схему платы: добавил схемы управления ESP32, контакта отделения (КО), исправил ошибку с подключением транзистора для управления двигателя. Сделал примерку футпринтов на плату
    [MA_board_1.brd, MA_board_1.sch]
2023-02-13 Дополнена компоновка плат МА в 3D модели
    [bottom_2floar.prt, connector-ffc_6pins.prt, connector-pbs-8.prt, lm_bottom_board.prt, magnetometer_cjmcu-lis3mdl.prt]
2023-02-17 Добавлен проект в Eagle
2023-02-18 новая версия первой платы нижнего модуля
    [MA_board_1.brd, MA_board_1.sch]
2023-02-18 Создан проект второй платы МА
    [MA_board_2.sch]
2023-02-18 начали делать интерфейсную плату
    [MA_interface-board.brd, MA_interface-board.sch]
2023-02-18 немного продвинул работу над платой (Прмгите)
    [MA_board_1.brd, MA_board_1.sch]
2023-02-18 я весь день делал плату с гпской
    [MA_board_2.brd, MA_board_2.sch]
2023-02-19 Проверил платы. Исправил некоторые ошибки
    [MA_board_1.brd, MA_board_2.brd, MA_board_2.sch, MA_interface-board.brd, MA_interface-board.sch, ma_2floar_plata.dxf, ma_low_plata.dxf]
2023-02-19 Добавил отверстия для крепления к нижнему модулю. Жаль, вспомнили про них, когда уже напечатали
2023-02-23 Я Тимофей, и я сделал плату. Гыы...
    [MA_interface-board.brd, MA_interface-board.sch]
2023-02-23 Я Данижок, и я тоже сделал плату. А куратор за всех коммитит и выключает компьютеры((
    [MA_board_2.brd, MA_board_2.sch]
2023-02-24 залили два проекта ДА и МА, которые общаются без акков
2023-02-24 ну короче сделал плату оптического модуля
    [optical_modul.brd, optical_modul.sch]
2023-03-01 МА передает быстро, а ДА отправляет ACK редко(
    [bme_proj Debug (1).cfg]
2023-03-04 Делаем уборку
2023-03-04 Убираемся дальше
2023-03-04 МА получает пакеты от ДА вместе с ACK. Ура!
2023-03-15 Ина работает исправно!
2023-03-15 Сам либцниимаш
2023-03-17 отдельный проект для сд. ножек в основном не хватает
2023-03-24 Сделана плата дочерних аппаратов
    [DA.brd, DA.sch]
2023-03-24 Доработана 3D модель по результатам разводки платы ДА
    [cup_bottom_doch.prt, cup_up_doch.prt, platada.prt, switch_sk12f14.prt]
2023-03-24 Создана платка с кнопкой
    [button.brd, button.sch]
2023-03-24 Обновлены DXF файлы для плат
    [halo_doch.dxf, lm_bottom_board-dxf.dxf, ma_board-2_zone.dxf, plata_da_new.dxf, plata_da_zone-top.dxf]
2023-03-24 Все платы проверены и вроеде бы как готовы к изготовлению!
    [MA_board_1.brd, MA_board_1.sch, MA_board_2.brd, MA_board_2.sch, MA_interface-board.brd, MA_interface-board.sch, lm_bottom_board.prt, optical_modul.brd]
2023-03-25 доработал верхний модуль и другую часть конструкции
    [babara_babina.prt, ember_skirt.prt, krug_michail.prt, krug_michail.stl, lil_uzi_otvet.prt, liluziverx.prt, liluziverx.stl, mm_korpus.stl]
2023-03-26 Еще раз проверил все платы и подготовил для производства в Резоните
    [Cansat-2023-1.brd, Cansat-2023-2.brd, Cansat-2023-3.brd, DA.brd, MA_board_1.sch, MA_board_2.brd, MA_board_2.sch, MA_interface-board.brd]
2023-03-29 Переписал драйвер BME280 студлиги под наш проект. Теперь надо отлаживать
2023-04-05 Доработаны модели верхнего модуля. Подготовлены STLs
    [ember_skirt.prt, ember_skirt_print.prt, ember_skirt_print.stl, lil_uzi_otvet.prt, lil_uzi_otvet.stl, liluziverx.prt, liluziverx.stl, lm_korpus.stl]
2023-04-14 Доработана модель корпуса ДА
    [cup_bottom_doch.stl, cup_bottom_doch_new.stl, cup_up_doch.prt]
2023-04-14 причина ненависти к пружинам
    [ember_skirt_print.stl]
2023-04-15 исправляем ошибки в моделях
    [cup_up_doch.prt, cup_up_doch.stl, ember_skirt.prt, ember_skirt_print.prt]
2023-04-15 кнопку сохранить придумали до... (исправил крышку дочерки)
    [cup_bottom_doch.prt]
2023-04-15 обрезал лил узи
    [lil_uzi_otvet.prt]
2023-04-15 Зачатки ПЗ
2023-04-21 ПЗ обновлена
2023-05-01 Глобальный ребрендинг 3D моделей
    [_.prt, babara_babina.prt, bass_buzzer.prt, battery_li-pol_lp402030.prt, bme280_module.prt, bobine.prt, bottom_2floar.prt, button.prt]
2023-05-01 Создали спецификации атмосферного зонда
2023-05-01 Модели для печати
    [babara_babina.stl, cup_babina.stl, platada.stl, platada_om.stl, skirt.stl]
2023-05-01 Файлы печатных плат для видеозачета
    [DA.brd, DA.sch, MA_board_1.brd, MA_board_1.sch, MA_board_2.brd, MA_board_2.sch, MA_interface-board.brd, MA_interface-board.sch]
2023-05-01 Черноглазов Данила написал код для ESP32-CAM
2023-05-01 Воронов Даниил написал код для обработчика наземки
2023-05-13 новая версия юбки
    [skirt.prt]
2023-05-17 Комплекты плат, которые были отправлены на производство (кроме платы ДА)
    [Cansat-2023-1.brd, Cansat-2023-2.brd, Cansat-2023-3.brd, Cansat-2023-4.brd, Cansat-2023-5.brd, DA.brd]
2023-05-17 Скрыл поддержки у детали
    [parachute_compartment.prt]
2023-05-17 Добавлены материалы к видеозачету кроме видео
    [Циклограмма полета.xlsx]
2023-05-24 Модернизировал верхний модуль
    [fairing-top.prt, fairing.prt, spring_0_4x2_4x19_6.prt, topcorpus.prt, windgen-vint.prt]
2023-05-26 Учёл недочёты в обтекателе
    [fairing-top.prt]
2023-05-26 Добавил отверстия для строп ДА
    [cup_up_da.prt]
