cansat-tsniimash/NeonBlade-2023/(notices)

Notices in the files:
src/board/bme_proj/Core/Inc/main.h:
Copyright (c) 2022 STMicroelectronics.
All rights reserved.
This software is licensed under terms that can be found in the LICENSE file
